ea3hmj/HMJTS/README.txt

!IMPORTANT, this repository is obsolete and has been replaced by the EA3HMJ Tracking Software Suit repository (https://github.com/EA3HMJ-Tracking-Software-Suite)
