ea3hmj/HMJTS/controller dish/remote/readme.md

# REMOTE CONTROL

The DishController remote control unit is a standalone battery powered wireless device that allows users to control the basic motion functions of the DishController without requiring a computer. 
It is a convenient device to operate the system outdoors (i.e., at the antenna location) while monitoring the antenna movement.
The remote wirelessly connects to the DishController mainboard and is powered by a rechargeable lithium-ion polymer (LiPo) battery.

## WARNING
Using the remote while a computer is operating connected to the DishController can potentially interfere with the normal functioning of the system. Therefore, it's advisable to avoid using the remote control when your computer is in use to command the DishController.

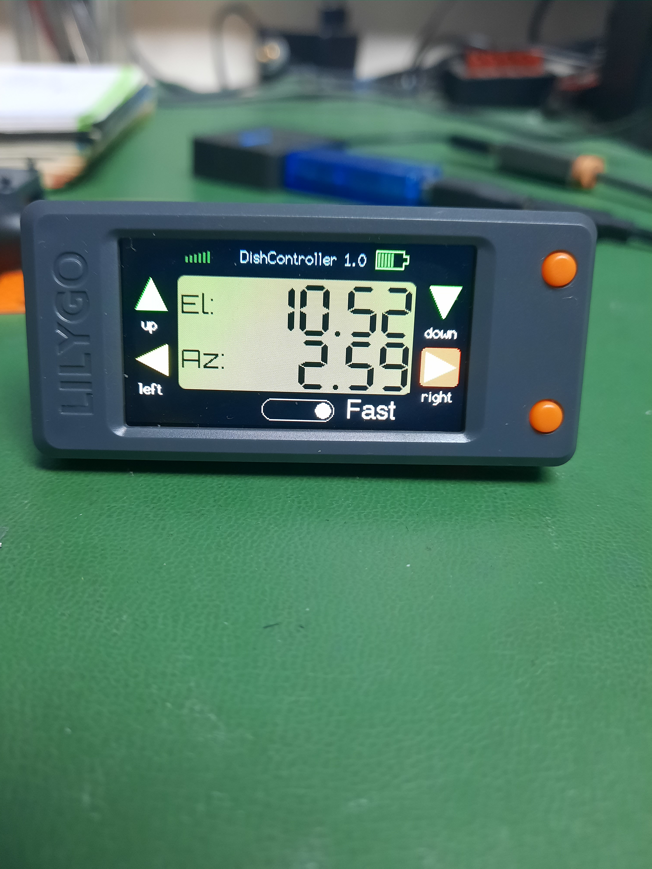
[picture p8: img/mando.jpg]


## INSTRUCTIONS

The remote has two main operating buttons on the upper and lower right of the front panel and a reset button on the side. 
To perform an action with the remote, press the appropriate button.

The lower right button performs the following functions:

• Single click to move between the four motion axes: ELEVATION (EL) up and down and AZIMUTH (AZ) right and left

• Double-click to switch from fast to slow speed motor movement

• Long click (0.5 s) to turn off the controller

The upper right button performs the following functions:

• Press and hold moves the selected movement axis

• Release stops movement

• When the motors are stopped, pressing it turns them on

## HARDWARE
The remote control is based on the LILYGO T-Display-S3 development board whose main control chip is ESP32-S3. It is equipped with a 1.9-inch LCD color screen and two programmable buttons.





## Documentation
### T-Display-S3 
https://es.aliexpress.com/item/1005004496543314.html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

### litle batery
https://www.amazon.es/EEMB-Bater%C3%ADa-pol%C3%ADmero-Recargable-Conector/dp/B09DPNZM31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

### big batery
https://www.amazon.es/dp/B09DPPMX14?psc=1&ref=ppx_yo2ov_dt_b_product_details

### files to print 3D box
https://github.com/Xinyuan-LilyGO/T-Display-S3/tree/main/3D_file/Shell

## Disclaimer
This software -including the source and the whole package- and hardware are distributed "as is" without any representation or warranty of any kind, either express or implied.

Please note that I am not able to provide support for this antenna tracking system. I designed and wrote it for myself and I am willing to share it here for those asking about my tracking system. I do not guarantee the accuracy or completeness of the information and materials distributed here. The software source has been tested on a real environment and scanned for viruses and has passed all tests.

I shall not be liable for any errors or omissions and shall not be responsible for any damages arising from the use of this antenna tracking system. I shall not be held responsible for any issues or problems that may arise from the use of it. By using any part of this antenna tracking system (software or hardware), you acknowledge and agree to the terms of this disclaimer.
