ea3hmj/HMJTS/controller dish/paralell to 485/readme.md

# CONVERTER PARALEL TO MODBUS-RTU RS-485
Interface for reading a 13-bit parallel encoder and converting it to RS-485 MOD-BU protocol.



## Documentation
For details, please read the document: [Encoder optico v2 ENG.pdf](docs/Encoder%20optico%20v2%20ENG.pdf)

## External library 
[ModbusSlave](https://github.com/yaacov/ArduinoModbusSlave)

## Updates

Download the firmware in [latest release page](https://github.com/ea3hmj/HMJTS/blob/main/controller%20dish/paralell%20to%20485/software/interface%20485.rar)

Use ST-LINK2 to program the board.

[Drivers for ST-LINK2 windows available here](https://github.com/ea3hmj/HMJTS/blob/main/controller%20dish/paralell%20to%20485/software/ST-LINK_USB_V2_1_Driver.rar)

## Disclaimer
This is an antenna tracking system (software and hardware) designed for amateur use in Earth–Moon–Earth communication (EME), radioastronomy, amateur Deep Sky Network (DSN) and other Space Communication applications where accurate and high precision tracking are required. 
Proper use of the system requires electronics knowledge and some software skills. Thus, it is only recommended to users with previous experience with antenna tracking systems.

This software -including the source and the whole package- and hardware are distributed "as is" without any representation or warranty of any kind, either express or implied. 

Please note that I am not able to provide support for this antenna tracking system. I designed and wrote it for myself and I am willing to share it here for those asking about my tracking system. I do not guarantee the accuracy or completeness of the information and materials distributed here. The software source has been tested on a real environment and scanned for viruses and has passed all tests.

I shall not be liable for any errors or omissions and shall not be responsible for any damages arising from the use of this antenna tracking system. I shall not be held responsible for any issues or problems that may arise from the use of it. 
By using any part of this antenna tracking system (software or hardware), you acknowledge and agree to the terms of this disclaimer.
