ea3hmj/HMJTS/Star up tracking system v1 ENG.pdf

### Version 1.0

08-08-2023

# STARTUP TRACKING SYSTEM

© EA3HMJ

Translated by CT1BYM

08/08/2023 | STARTUP TRACKING SYSTEM | 1

# INDICE

08/08/2023 | STARTUP TRACKING SYSTEM | 2

## STARTUP TRACKING SYSTEM

This is an antenna tracking system that integrates dedicated hardware and software designed for amateur use in Earth-Moon-Earth (EME) communications, radio astronomy, amateur Deep Sky Network (DSN) and other Space Communications applications where an accurate and high precision tracking is needed.

Proper use of the system requires knowledge of electronics and some software skills. Therefore, it is recommended for users with previous experience in antenna tracking systems only.

The hardware components of this system have been specifically selected to support the software applications that run on it. These components include a DishController unit that uses an ESP32 microcontroller (MCU), a DC motor driver board with high-performance, high-current control devices, RS485 input/output devices, and a DC step-up converter (versions <1.5). Other peripherals can be connected, such as a variety of digital absolute encoders and inclinometers to sense the motion and position of the motorized turning system, and a remote control unit.

The application software includes the DriverDish program, responsible for requesting data from the ephemeris server and for communicating with the DishController unit, and a suite of server programs (JPLastroserver, Astroserver, or Astronomyserver) that obtain the most accurate positioning data possible, are available from reliable sources.

The integration of dedicated hardware and software in such a system offers several advantages. First, it improves system performance and reliability by allowing the DishController unit to directly access and control specialized hardware components such as motor drivers and position sensors. This reduces overhead and improves response times. Second, it simplifies system design and development by providing a standardized set of hardware and software components optimized for narrow-beam antenna tracking. Third, unlike other antenna tracking system designs, motion and position sensors are located at the last link in the motion chain to actively monitor the aim of the antenna. In this way, the system is able to minimize the impact of mechanical tolerances and gear backlash.

The system is made up of three blocks that work together:

- Ephemeris servers (Astroserver, JPLastroserver or Astronomyserver)
- Control soware, SO Windows (DriverDish.App)
- Antenna Controller (Controller Dish)

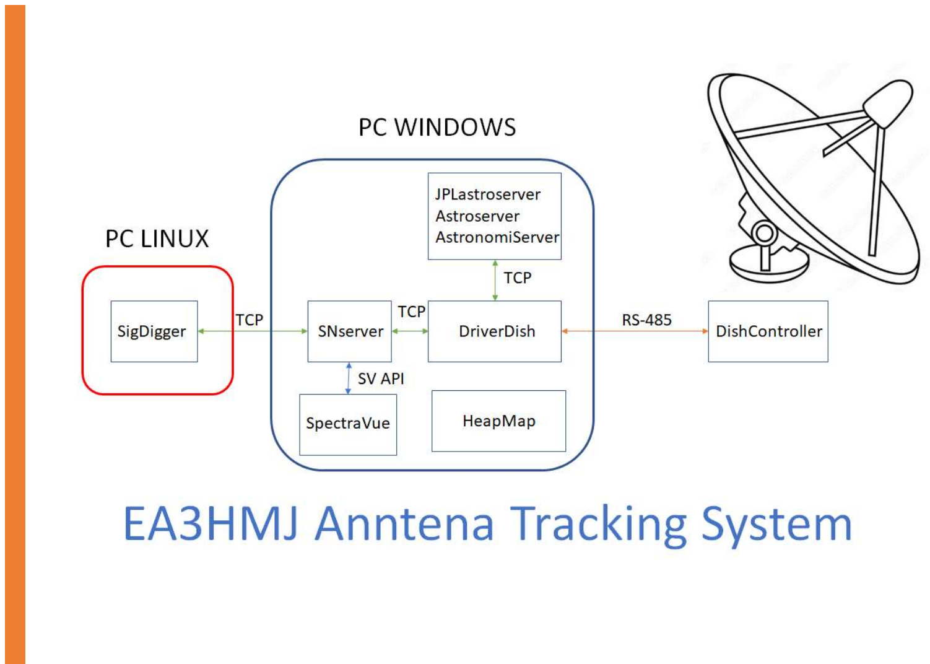
[picture p13: page 4]

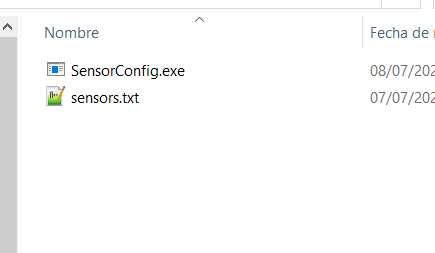
[picture p14: figure]
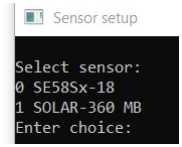
[picture p15: figure]
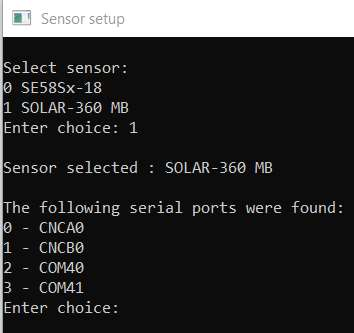
[picture p16: figure]

08/08/2023 | STARTUP TRACKING SYSTEM | 4

## Encoders

The first thing we must do is configure the encoders, both SOLAR-360 elevation and SE58xx azimuth.

To simplify the process I have created a utility that does the job automatically, we just have to connect the sensor to the computer through the USB-RS485 adapter and power it.

We will use two programs, one to configure and the other to verify.

To configure: https://ea3hmj.net/download/SensorConfig.rar

To verify: https://ea3hmj.net/download/ModRTUClient.rar

Unzip the file to a directory and run SensorConfig.exe

## Elevation SOLAR-360 MB

We connect the encoder and feed it.

Option 1 ask wich port it is connected

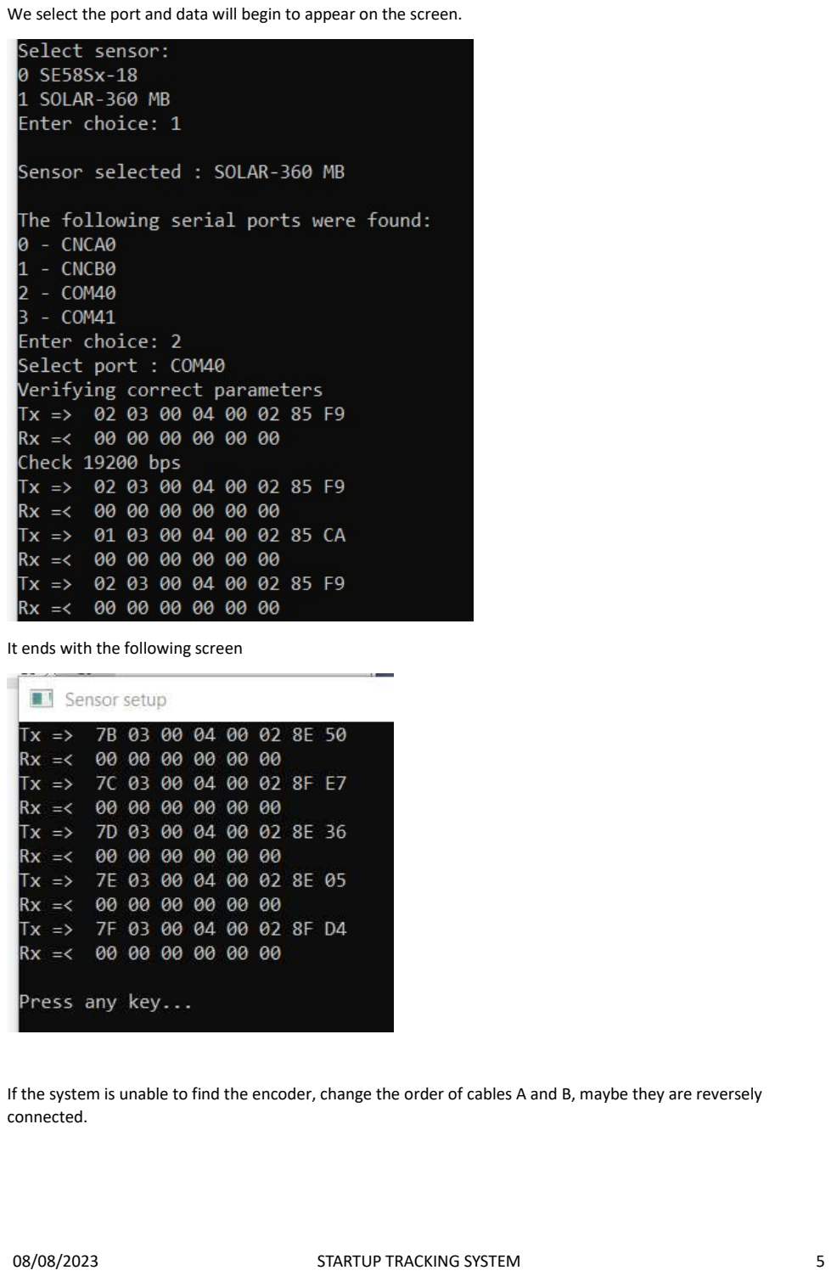
[picture p17: page 6]

08/08/2023 | STARTUP TRACKING SYSTEM | 5

We select the port and data will begin to appear on the screen.

It ends with the following screen

If the system is unable to find the encoder, change the order of cables A and B, maybe they are reversely connected.

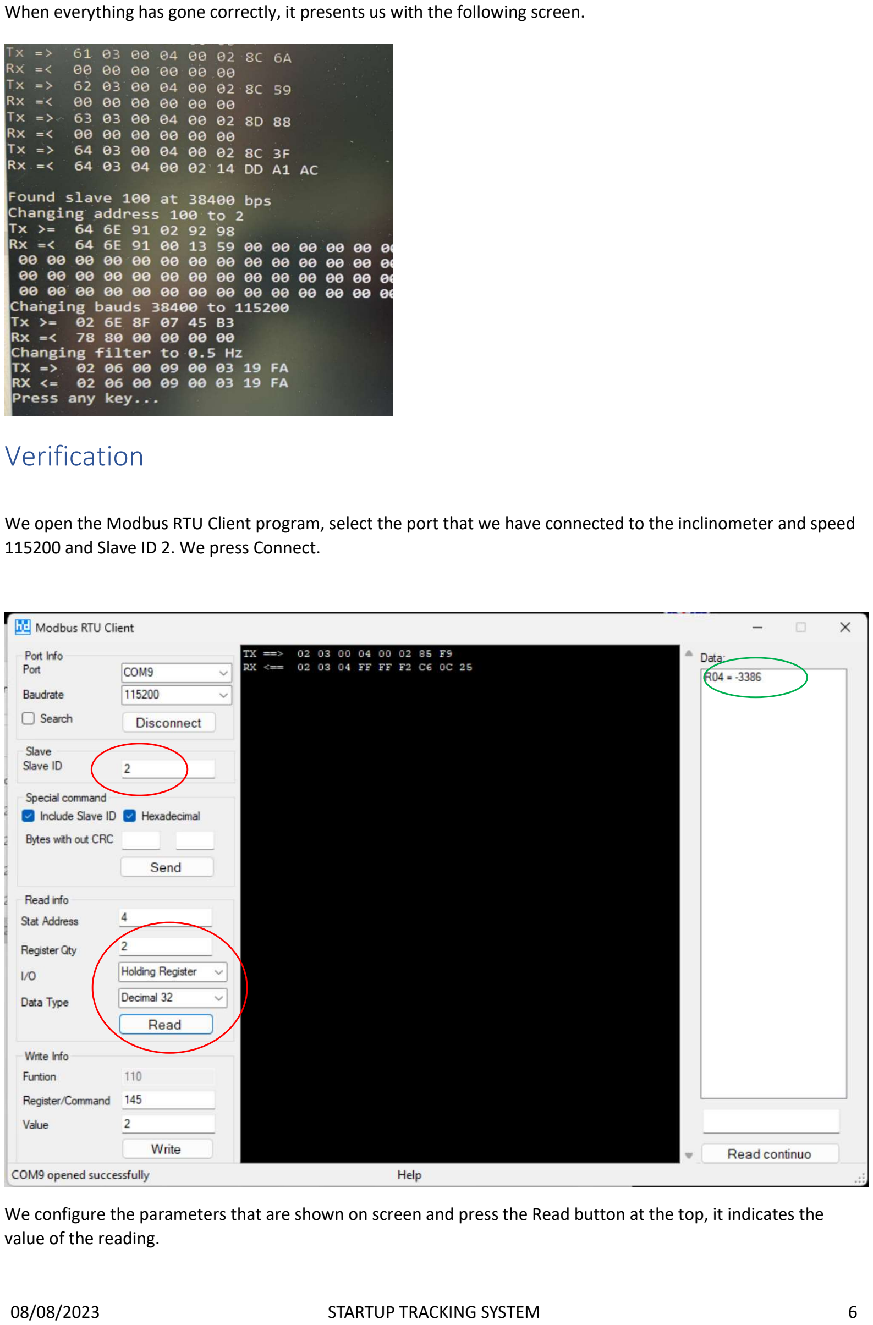
[picture p18: page 7]

08/08/2023 | STARTUP TRACKING SYSTEM | 6

When everything has gone correctly, it presents us with the following screen.

## Verification

We open the Modbus RTU Client program, select the port that we have connected to the inclinometer and speed 115200 and Slave ID 2. We press Connect.

We configure the parameters that are shown on screen and press the Read button at the top, it indicates the value of the reading.

## Azimuth SE58Sx

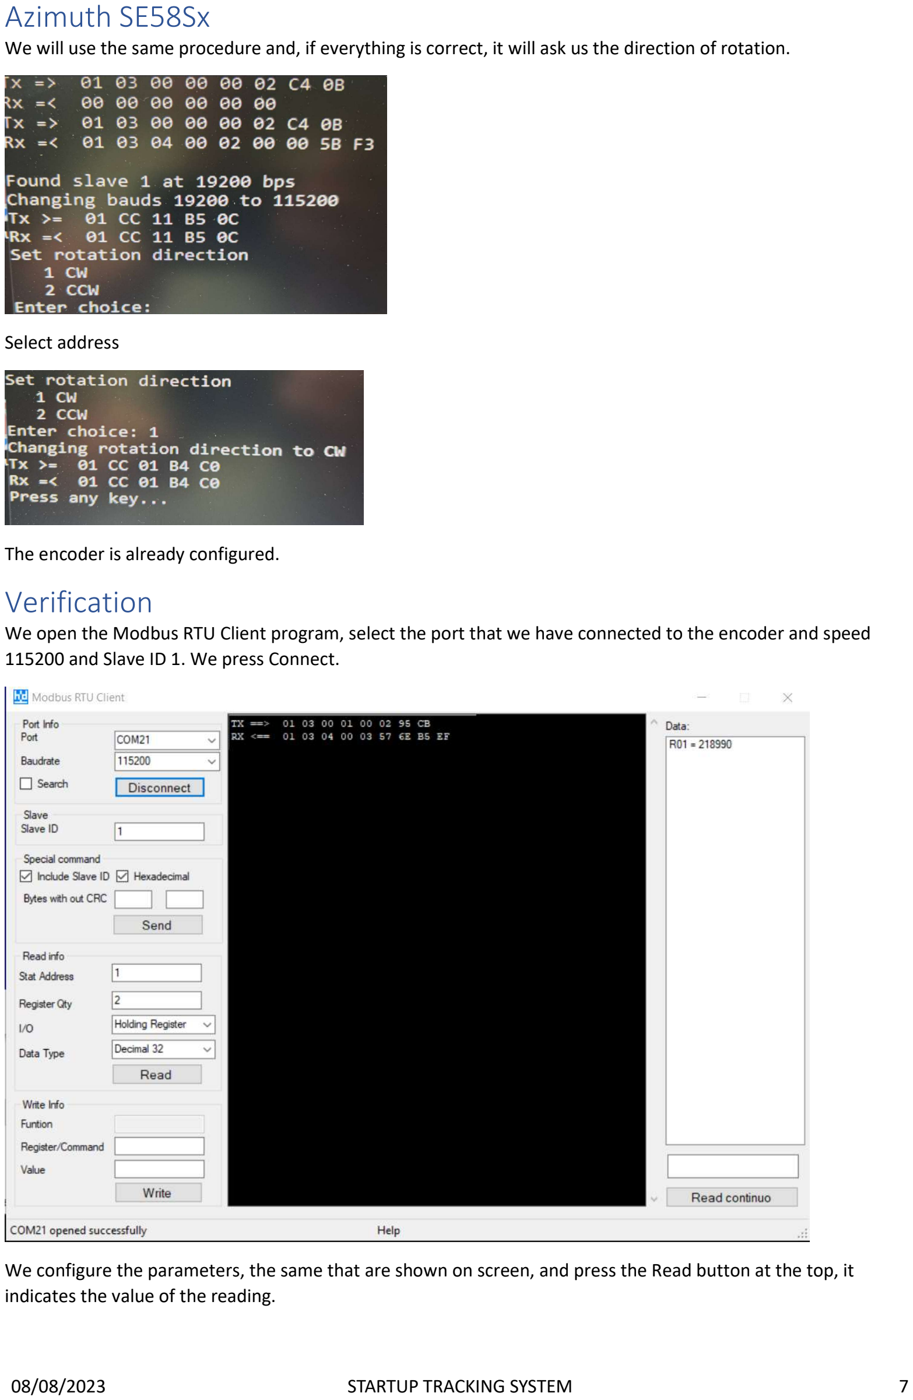
[picture p19: page 8]

08/08/2023 | STARTUP TRACKING SYSTEM | 7

We will use the same procedure and, if everything is correct, it will ask us the direction of rotation.

Select address

The encoder is already configured.

## Verification

We open the Modbus RTU Client program, select the port that we have connected to the encoder and speed 115200 and Slave ID 1. We press Connect.

We configure the parameters, the same that are shown on screen, and press the Read button at the top, it indicates the value of the reading.

## DriverDish

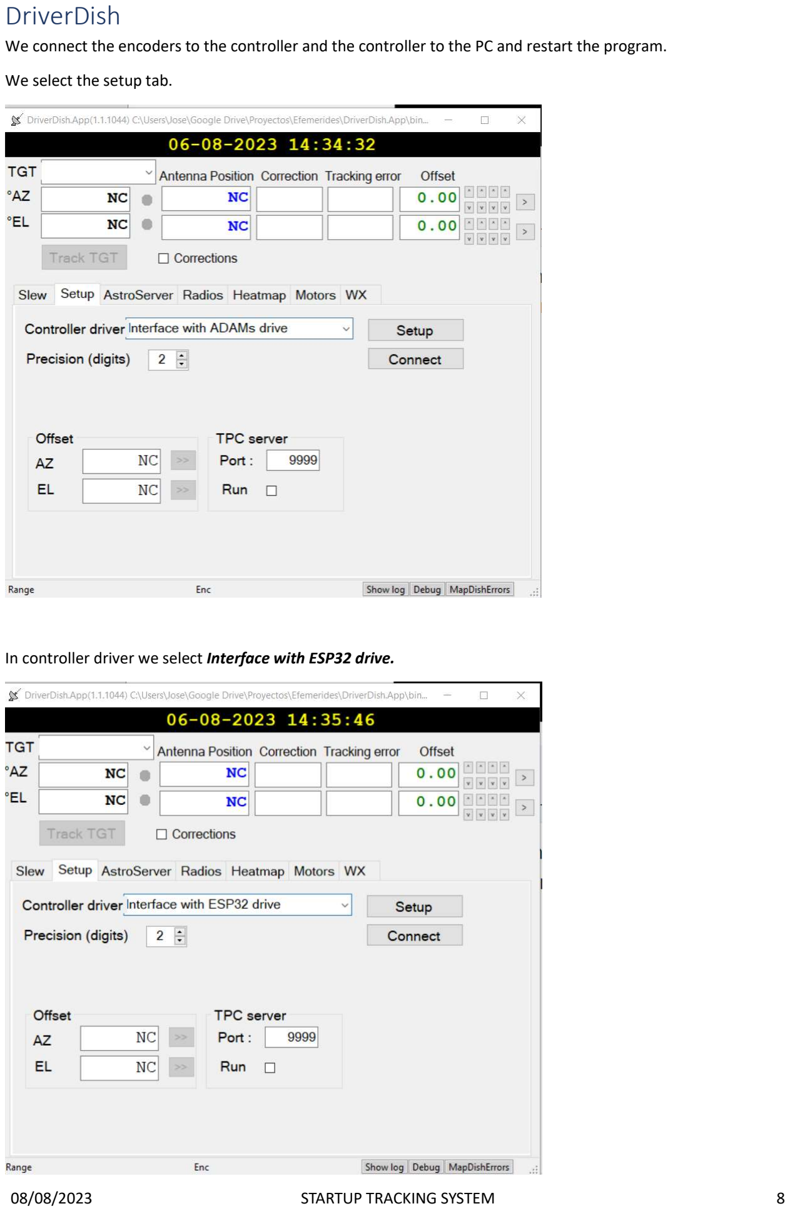
[picture p20: page 9]

08/08/2023 | STARTUP TRACKING SYSTEM | 8

We connect the encoders to the controller and the controller to the PC and restart the program. We select the setup tab.

In controller driver we select Interface with ESP32 drive.

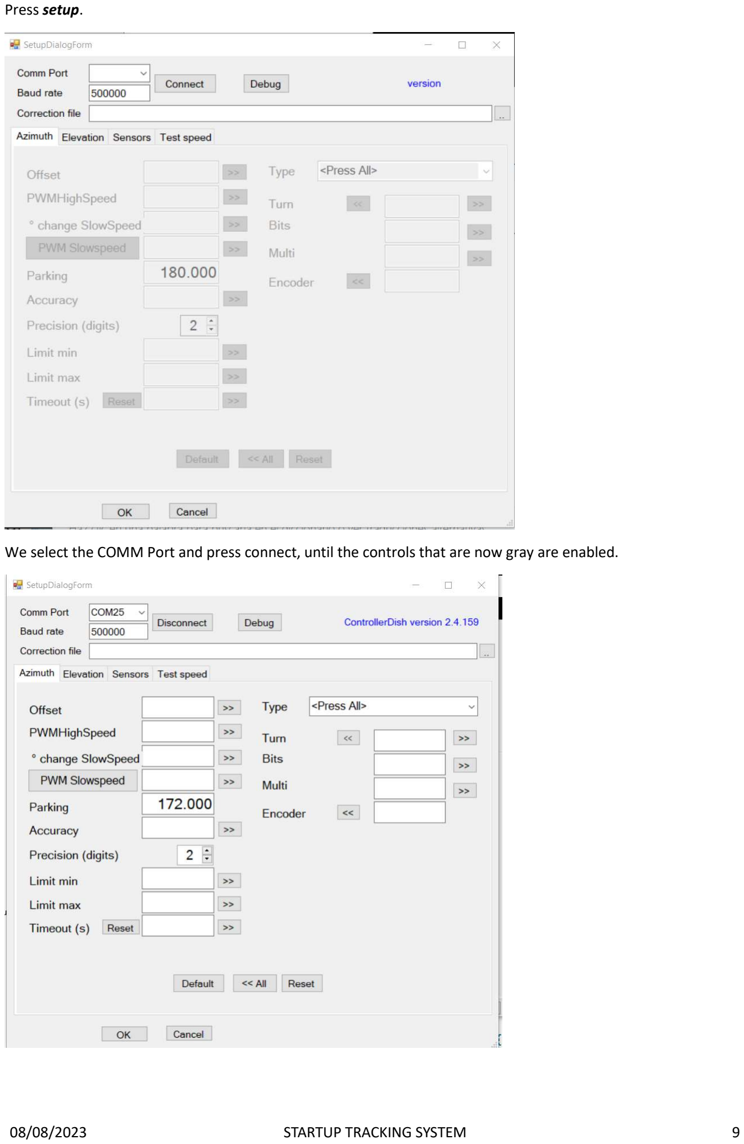
[picture p21: page 10]

08/08/2023 | STARTUP TRACKING SYSTEM | 9

Press setup.

We select the COMM Port and press connect, until the controls that are now gray are enabled.

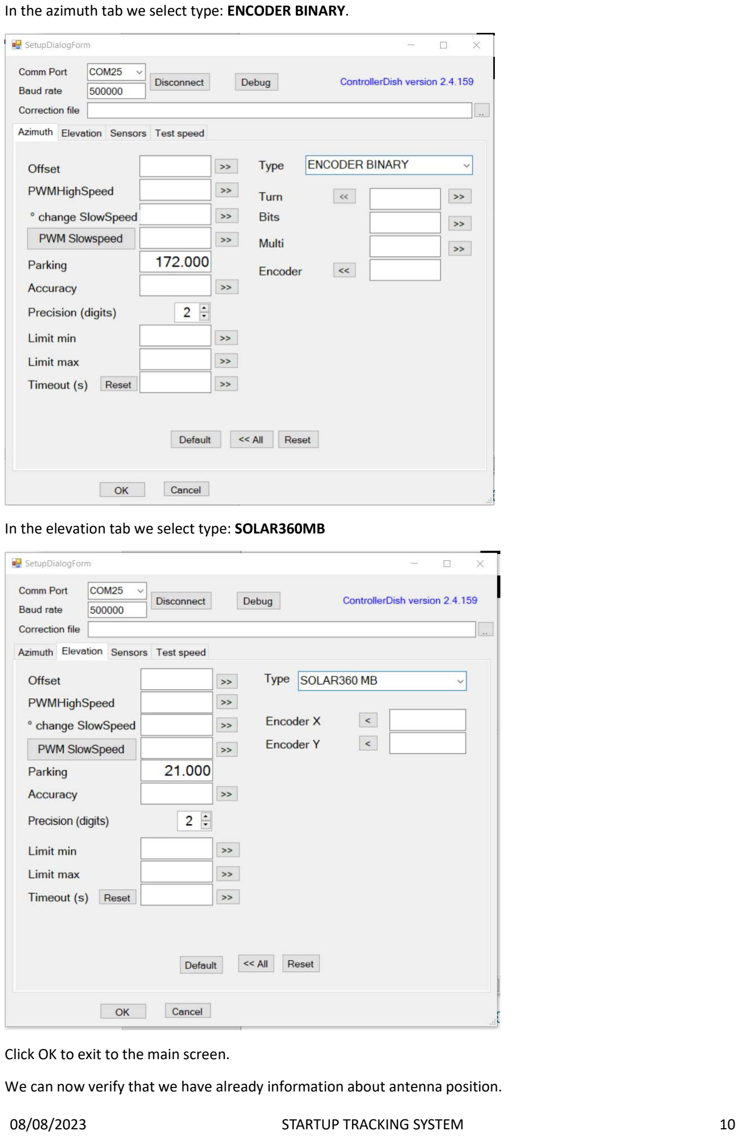
[picture p22: page 11]

08/08/2023 | STARTUP TRACKING SYSTEM | 10

In the azimuth tab we select type: ENCODER BINARY.

In the elevation tab we select type: SOLAR360MB

Click OK to exit to the main screen.
We can now verify that we have already information about antenna position.

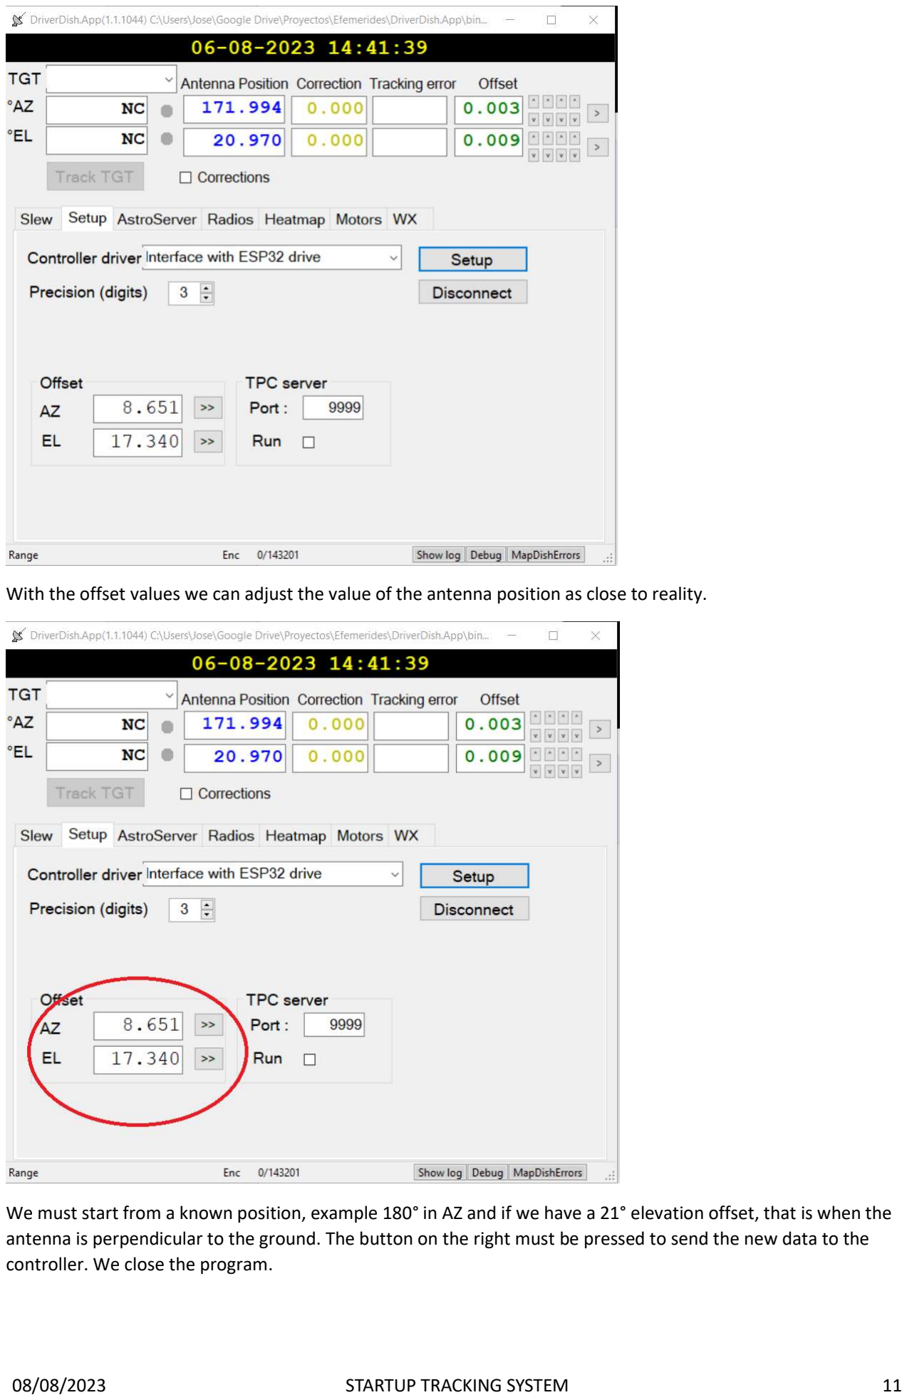
[picture p23: page 12]

08/08/2023 | STARTUP TRACKING SYSTEM | 11

With the offset values we can adjust the value of the antenna position as close to reality.

We must start from a known position, example 180° in AZ and if we have a 21° elevation offset, that is when the antenna is perpendicular to the ground. The button on the right must be pressed to send the new data to the controller. We close the program.

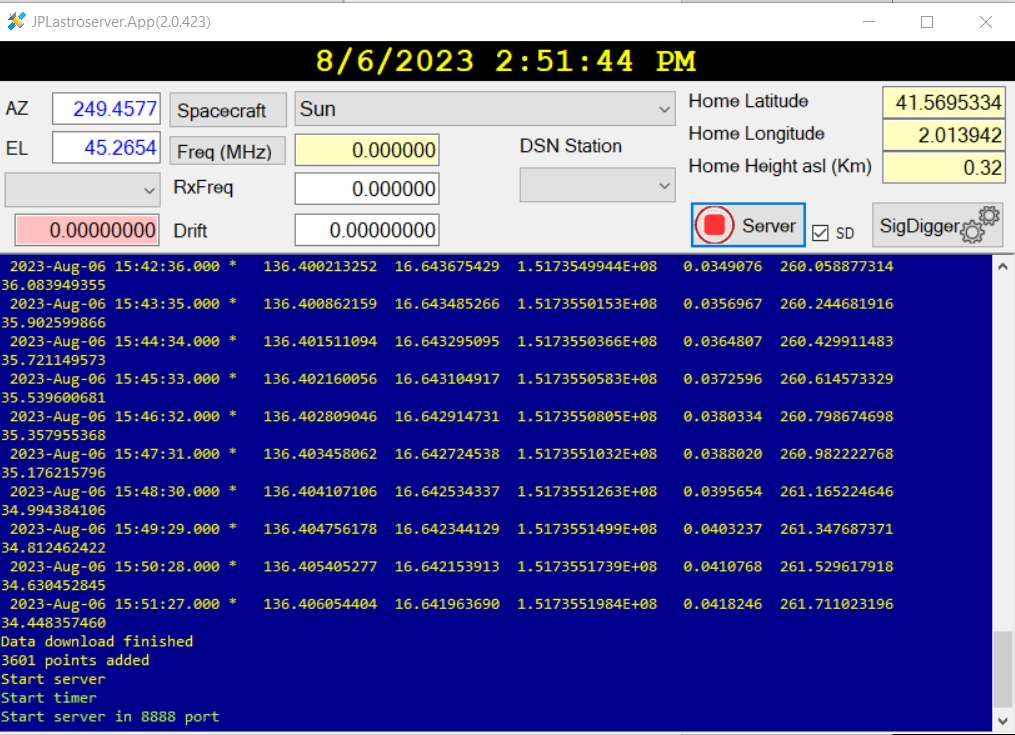
[picture p24: figure]

08/08/2023 | STARTUP TRACKING SYSTEM | 12

## JPLastroserver

We start the program

We must put the appropriate values of latitude, longitude and height of our location.

We close the program.

## Verification of communications

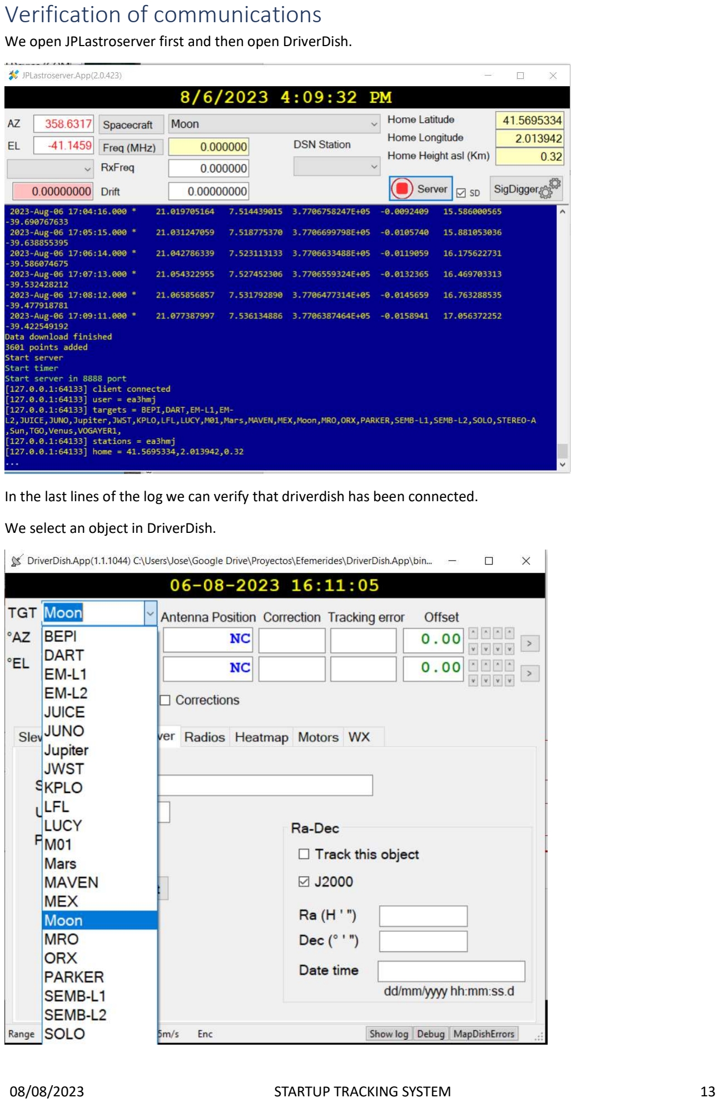
[picture p25: page 14]

08/08/2023 | STARTUP TRACKING SYSTEM | 13

We open JPLastroserver first and then open DriverDish.

In the last lines of the log we can verify that driverdish has been connected. We select an object in DriverDish.

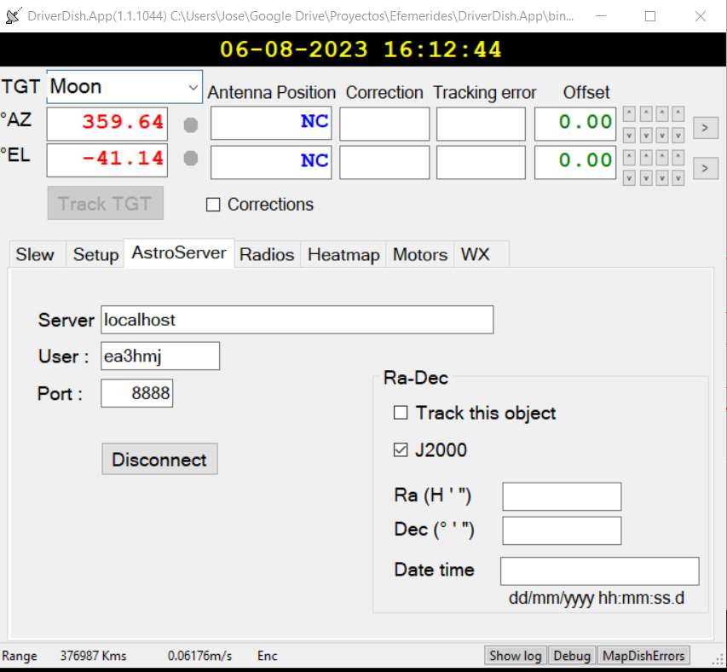
[picture p26: figure]

08/08/2023 | STARTUP TRACKING SYSTEM | 14

The program already obtained ephemeris from the server and we can track the object selected.

## SNserver

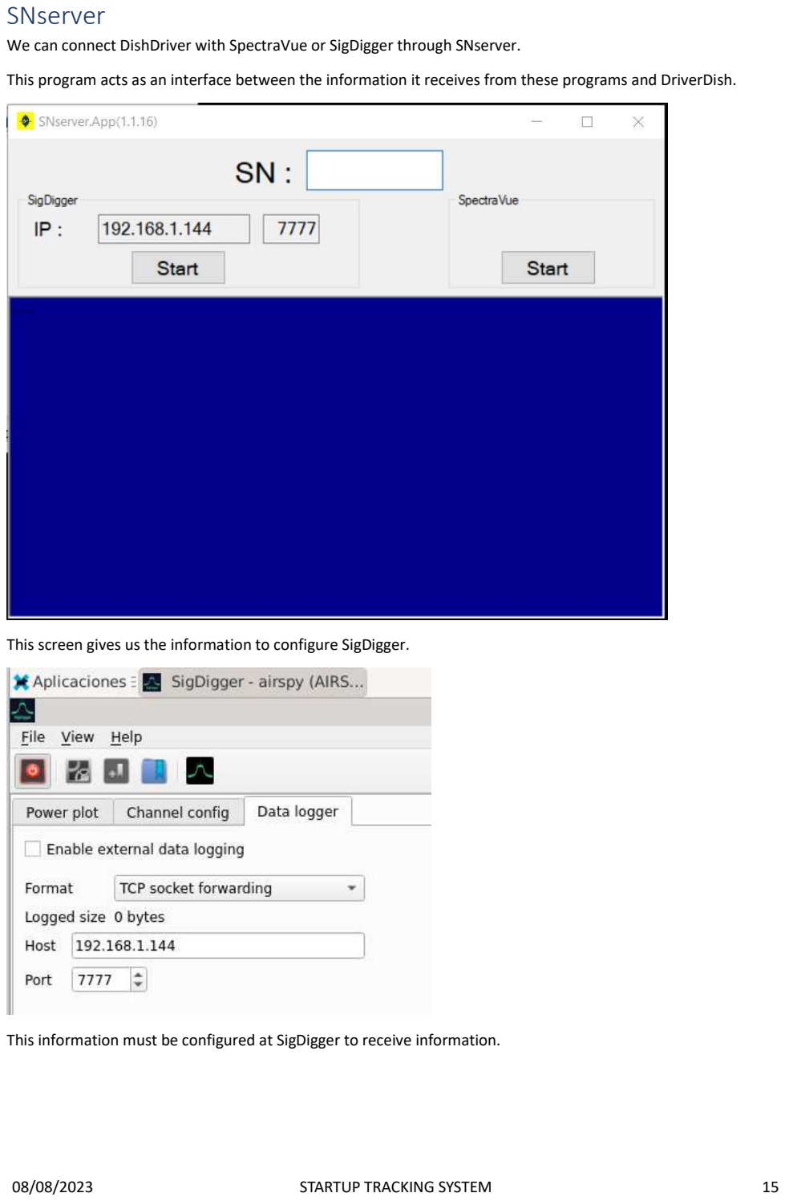
[picture p27: page 16]

08/08/2023 | STARTUP TRACKING SYSTEM | 15

We can connect DishDriver with SpectraVue or SigDigger through SNserver.
This program acts as an interface between the information it receives from these programs and DriverDish.

This screen gives us the information to configure SigDigger.

This information must be configured at SigDigger to receive information.

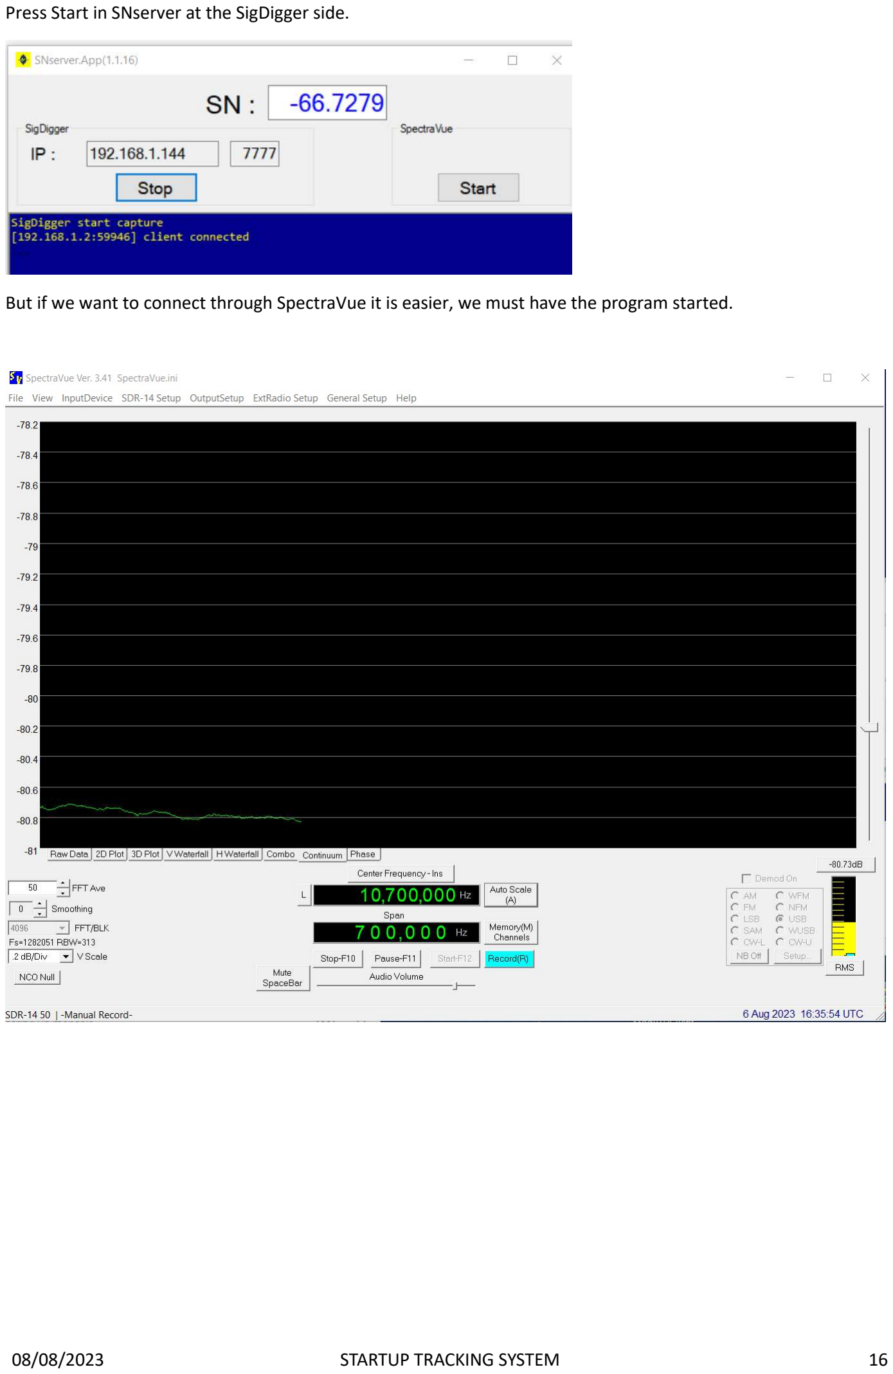
[picture p28: page 17]

08/08/2023 | STARTUP TRACKING SYSTEM | 16

Press Start in SNserver at the SigDigger side.

But if we want to connect through SpectraVue it is easier, we must have the program started.

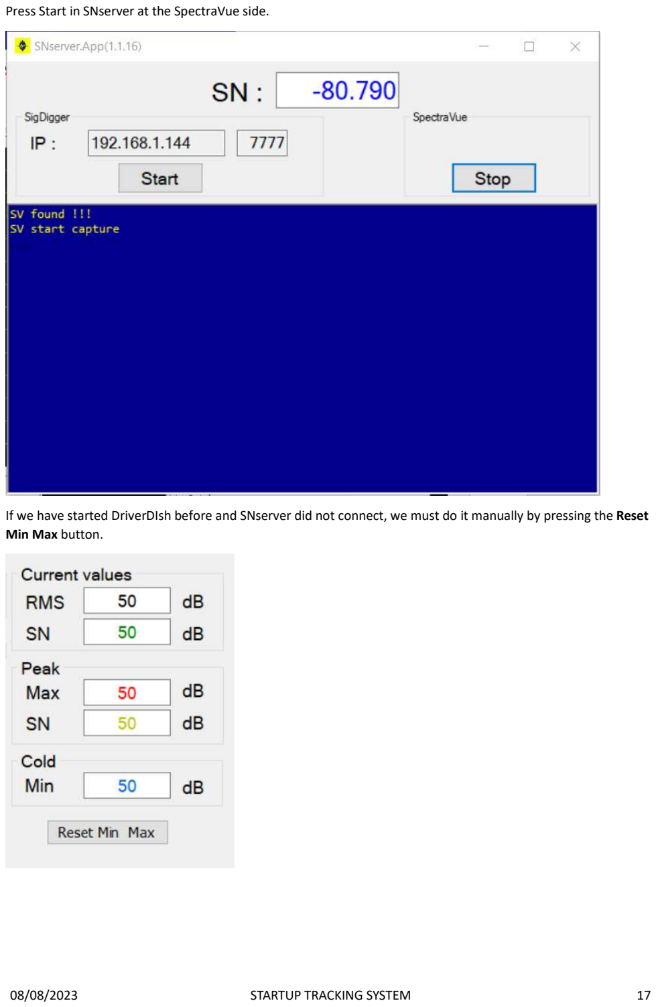
[picture p29: page 18]

08/08/2023 | STARTUP TRACKING SYSTEM | 17

Press Start in SNserver at the SpectraVue side.

If we have started DriverDIsh before and SNserver did not connect, we must do it manually by pressing the Reset Min Max button.

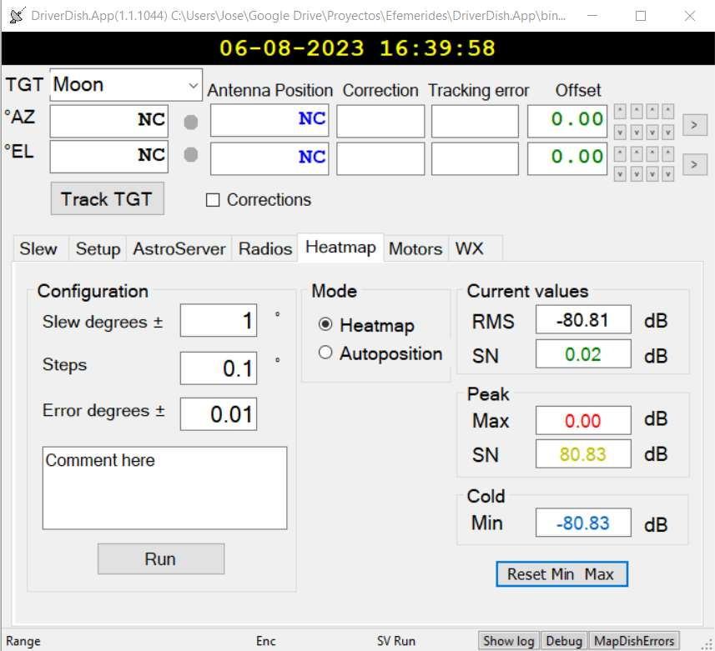
[picture p30: figure]

08/08/2023 | STARTUP TRACKING SYSTEM | 18

We already have the information.
If we first start SNserver when starting DriverDish it automatically connects.
