ea3hmj/HMJTS/Star up tracking system v1 ESP.pdf

### Versión 1.0

6-08-2023

# START UP TRACKING SYSTEM

© EA3HMJ

06/08/2023 | START UP TRACKING SYSTEM | 1

# INDICE

06/08/2023 | START UP TRACKING SYSTEM | 2

## START UP TRACKING SYSTEM

Se trata de un sistema de seguimiento de antenas que integra hardware y software dedicado diseñado para uso amateur en comunicaciones Tierra-Luna-Tierra (EME), radioastronomía, Red de Cielo Profundo (DSN) amateur y otras aplicaciones de Comunicaciones Espaciales donde se requiere un seguimiento exacto y de alta precisión.

El uso adecuado del sistema requiere conocimientos de electrónica y algunas habilidades de software. Por ello, sólo se recomienda a usuarios con experiencia previa en sistemas de seguimiento de antenas.

Los componentes hardware de este sistema han sido específicamente seleccionados para soportar las aplicaciones software que se ejecutan en él. Estos componentes incluyen una unidad DishController que incluye un microcontrolador ESP32 (MCU), una placa de controladores de motor de CC con dispositivos de control de alto rendimiento y alta corriente, dispositivos de entrada/salida RS485 y un convertidor elevador de tensión de CC (versiones <1.5) , otros periféricos como una variedad de codificadores digitales absolutos e inclinómetros para detectar el movimiento y la posición del sistema de accionamiento de giro motorizado y una unidad de control remoto.

El software de aplicación incluye el programa DriverDish, responsable de solicitar datos al servidor de efemérides y de comunicarse con la unidad DishController, y un conjunto de programas de servidor (JPLastroserver, Astroserver y Astronomyserver) que obtienen los datos de posicionamiento más precisos que sean factibles y estén disponibles en fuentes fiables.

La integración de hardware y software dedicados en un sistema de este tipo ofrece varias ventajas. En primer lugar, mejora el rendimiento y la fiabilidad del sistema al permitir que la unidad DishController acceda directamente a los componentes de hardware especializados, como los controladores de motor y los sensores de posición, y los controle. Esto reduce la sobrecarga y mejora los tiempos de respuesta. En segundo lugar, simplifica el diseño y desarrollo del sistema al proporcionar un conjunto estandarizado de componentes de hardware y software optimizados para el seguimiento de antenas de haz estrecho. En tercer lugar, a diferencia de otros diseños de sistemas de seguimiento de antenas, los sensores de movimiento y posición están situados en el último eslabón de la cadena de movimiento para supervisar activamente la dirección de apuntamiento de la antena. De este modo, el sistema es capaz de minimizar el impacto de las tolerancias mecánicas y las holguras de los engranajes.

El sistema se compone de tres bloques que funcionan conjuntamente:

- Servidores de efemérides (Astroserver, JPLastroserver y Astronomyserver)
- Aplicación de control en SO Windows (DriverDish.App)
- Controlador de antena (Controller Dish)

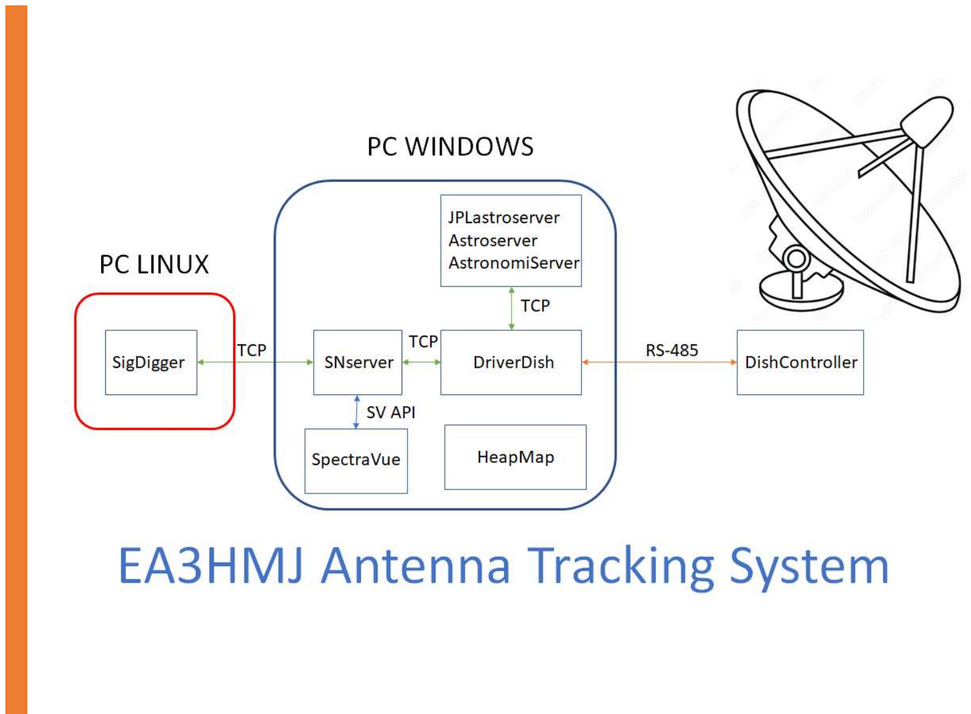
[picture p31: page 4]

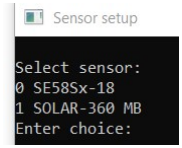
[picture p32: figure]

06/08/2023 | START UP TRACKING SYSTEM | 4

## Encoders

Lo primero que debemos de hacer es configurar los encoders, tanto elevación SOLAR-360 como azimuth SE58xx. Para simplificar el proceso he creado una utilidad que realiza el trabajo automáticamente, solo debemos de conectar el sensor al ordenador a través del adaptador USB-RS485 y alimentarlo.
Usaremos dos programas uno para configurar y otro para verificar.
Para configurar bajar https://ea3hmj.net/download/SensorConfig.rar y para verificar https://ea3hmj.net/download/ModRTUClient.rar

Descomprime el fichero en un directorio y ejecuta SensorConfig.exe

## Elevación SOLAR-360 MB

Conectamos el encoder y lo alimentamos.

Opción 1 y nos pregunta el puerto donde está conectado

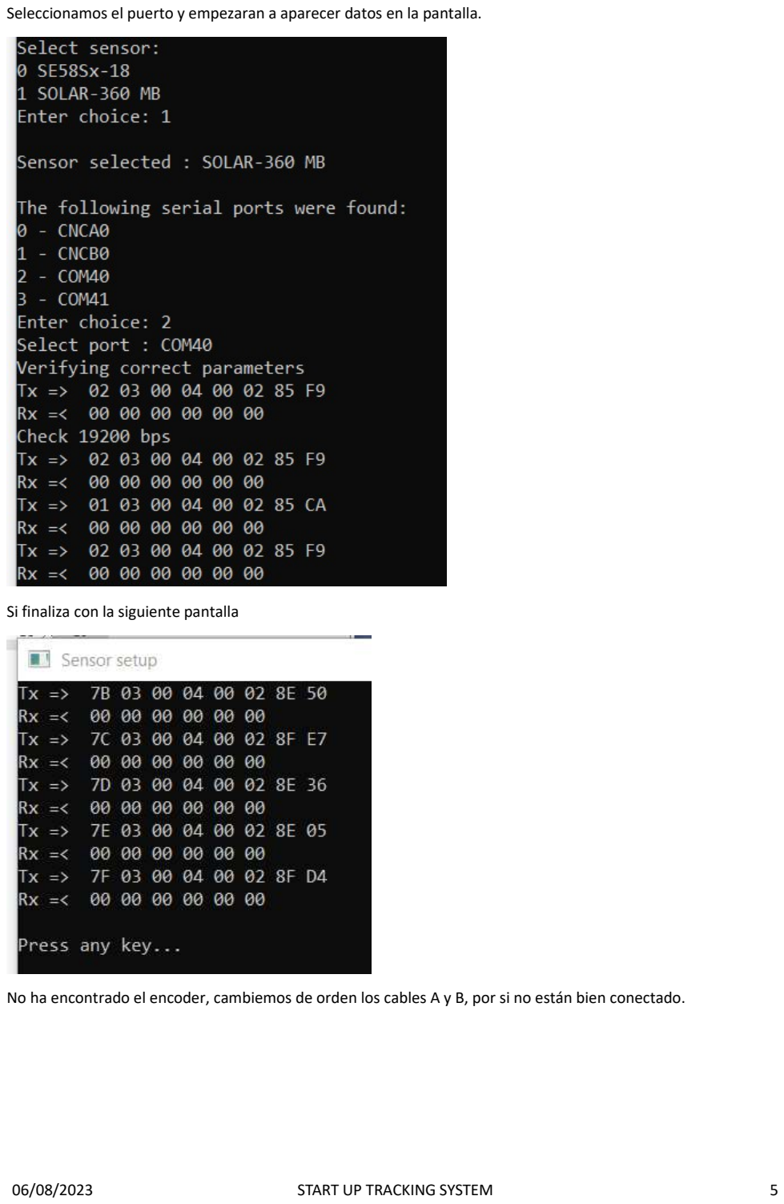
[picture p33: page 6]

06/08/2023 | START UP TRACKING SYSTEM | 5

Seleccionamos el puerto y empezaran a aparecer datos en la pantalla.

Si finaliza con la siguiente pantalla

No ha encontrado el encoder, cambiemos de orden los cables A y B, por si no están bien conectado.

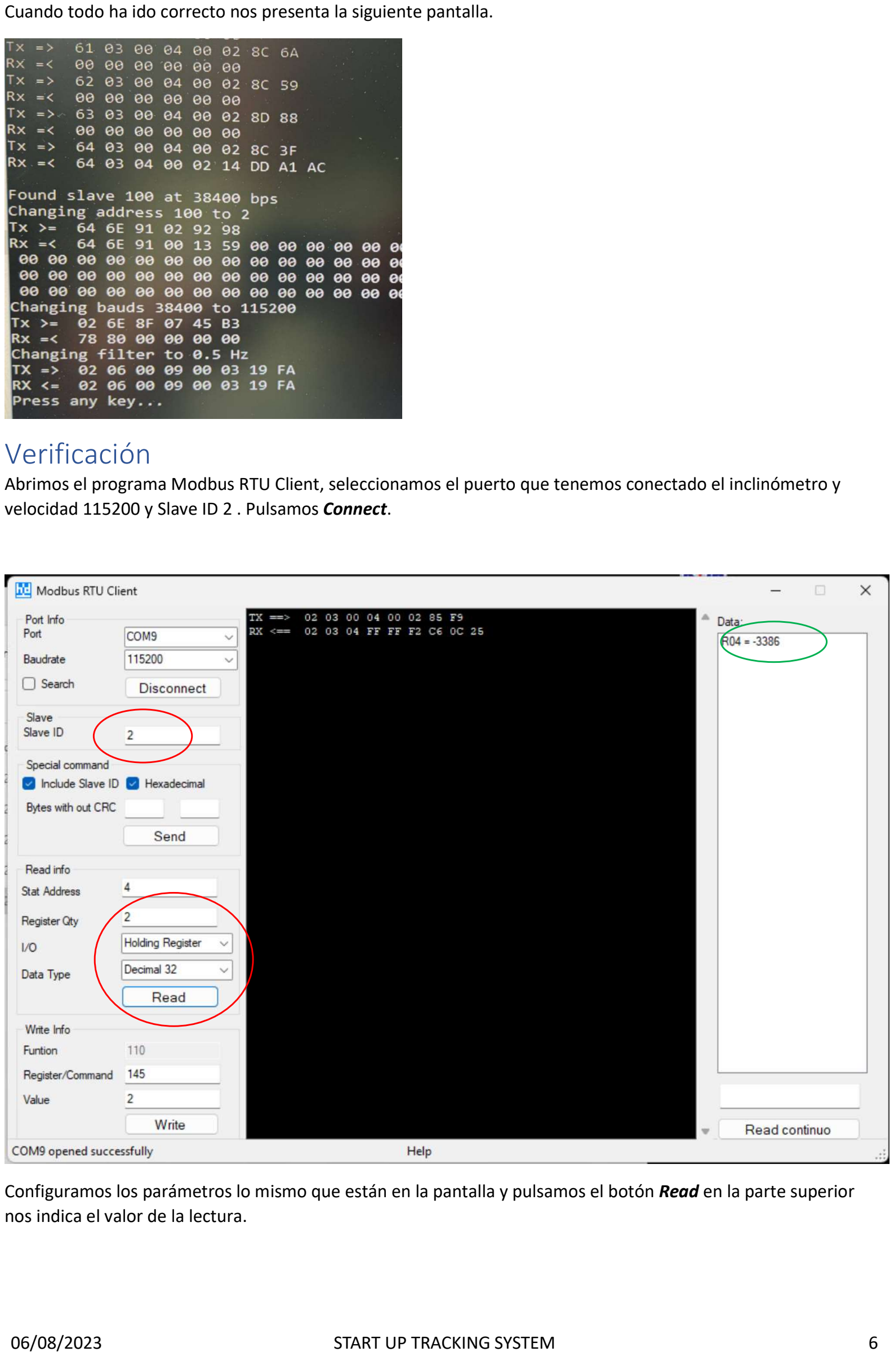
[picture p34: page 7]

06/08/2023 | START UP TRACKING SYSTEM | 6

Cuando todo ha ido correcto nos presenta la siguiente pantalla.

## Verificación

Abrimos el programa Modbus RTU Client, seleccionamos el puerto que tenemos conectado el inclinómetro y velocidad 115200 y Slave ID 2 . Pulsamos Connect.

Configuramos los parámetros lo mismo que están en la pantalla y pulsamos el botón Read en la parte superior nos indica el valor de la lectura.

## Azimuth SE58Sx

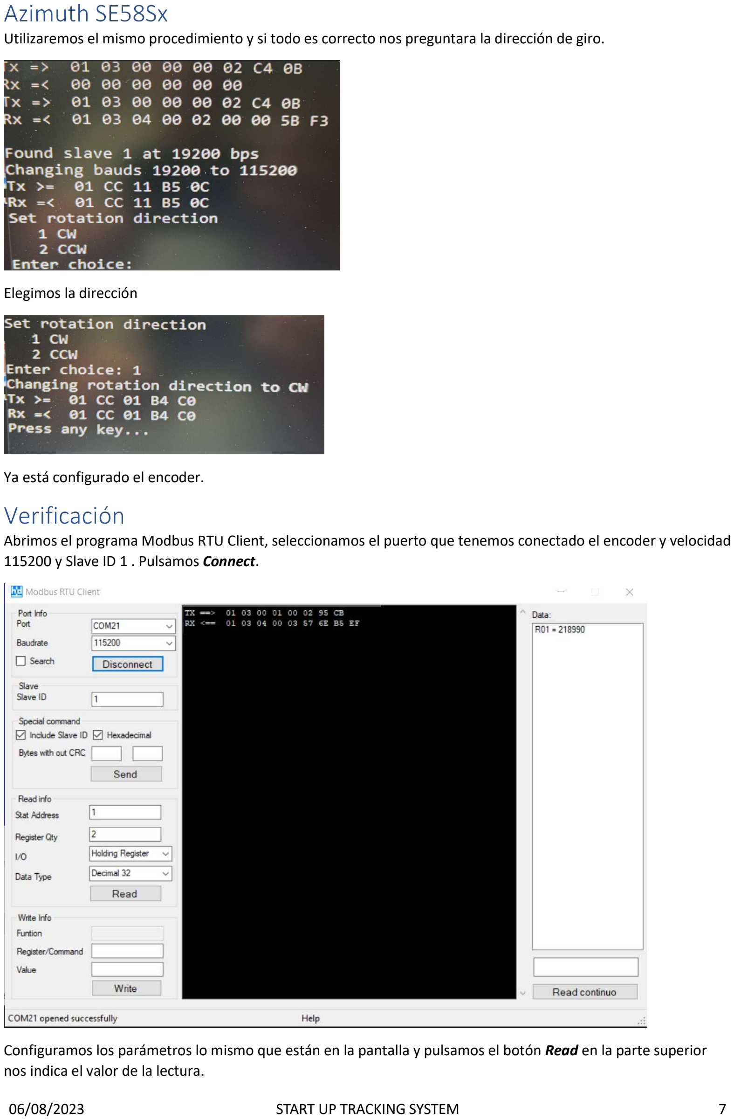
[picture p35: page 8]

06/08/2023 | START UP TRACKING SYSTEM | 7

Utilizaremos el mismo procedimiento y si todo es correcto nos preguntara la dirección de giro.

Elegimos la dirección

Ya está configurado el encoder.

## Verificación

Abrimos el programa Modbus RTU Client, seleccionamos el puerto que tenemos conectado el encoder y velocidad 115200 y Slave ID 1 . Pulsamos Connect.

Configuramos los parámetros lo mismo que están en la pantalla y pulsamos el botón Read en la parte superior nos indica el valor de la lectura.

## DriverDish

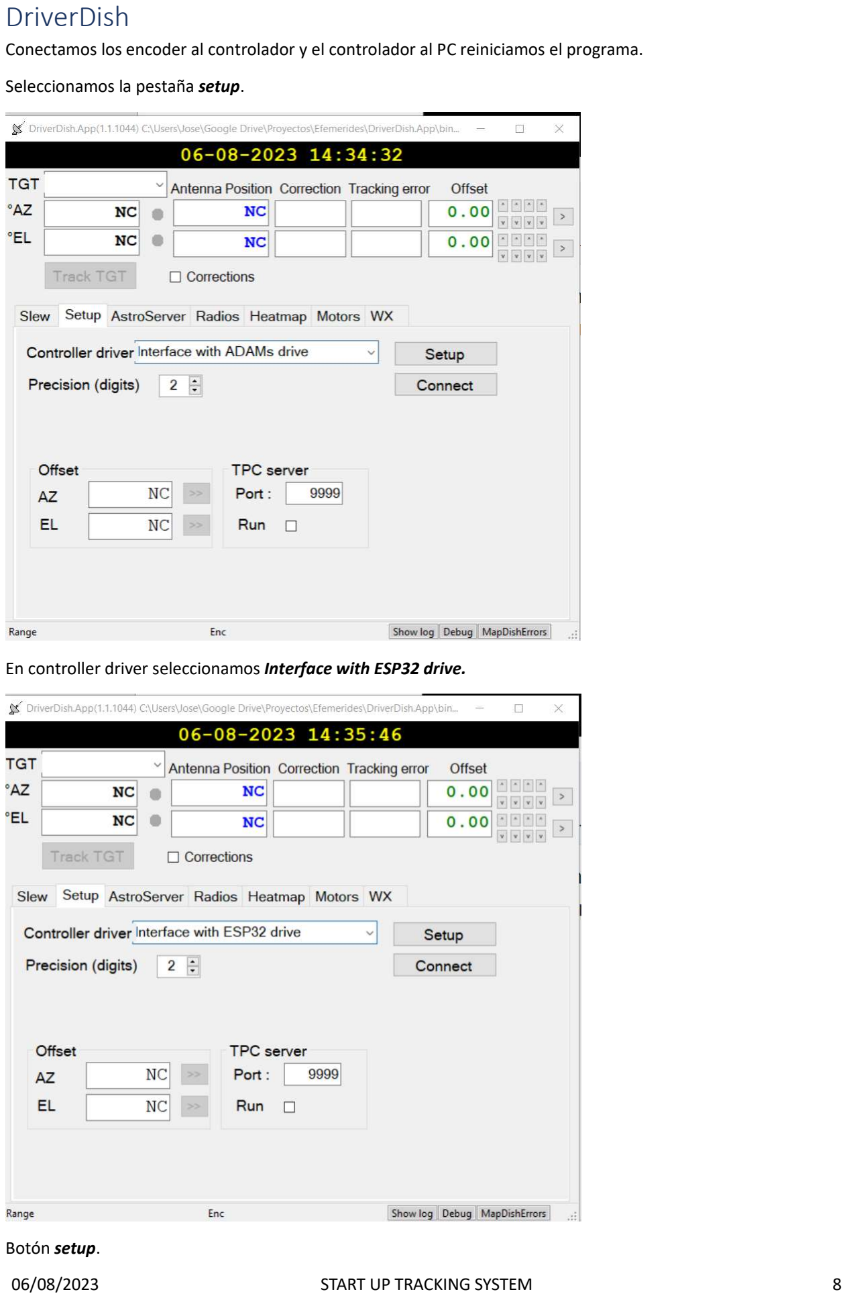
[picture p36: page 9]

06/08/2023 | START UP TRACKING SYSTEM | 8

Conectamos los encoder al controlador y el controlador al PC reiniciamos el programa. Seleccionamos la pestaña setup.

En controller driver seleccionamos Interface with ESP32 drive.

Botón setup.

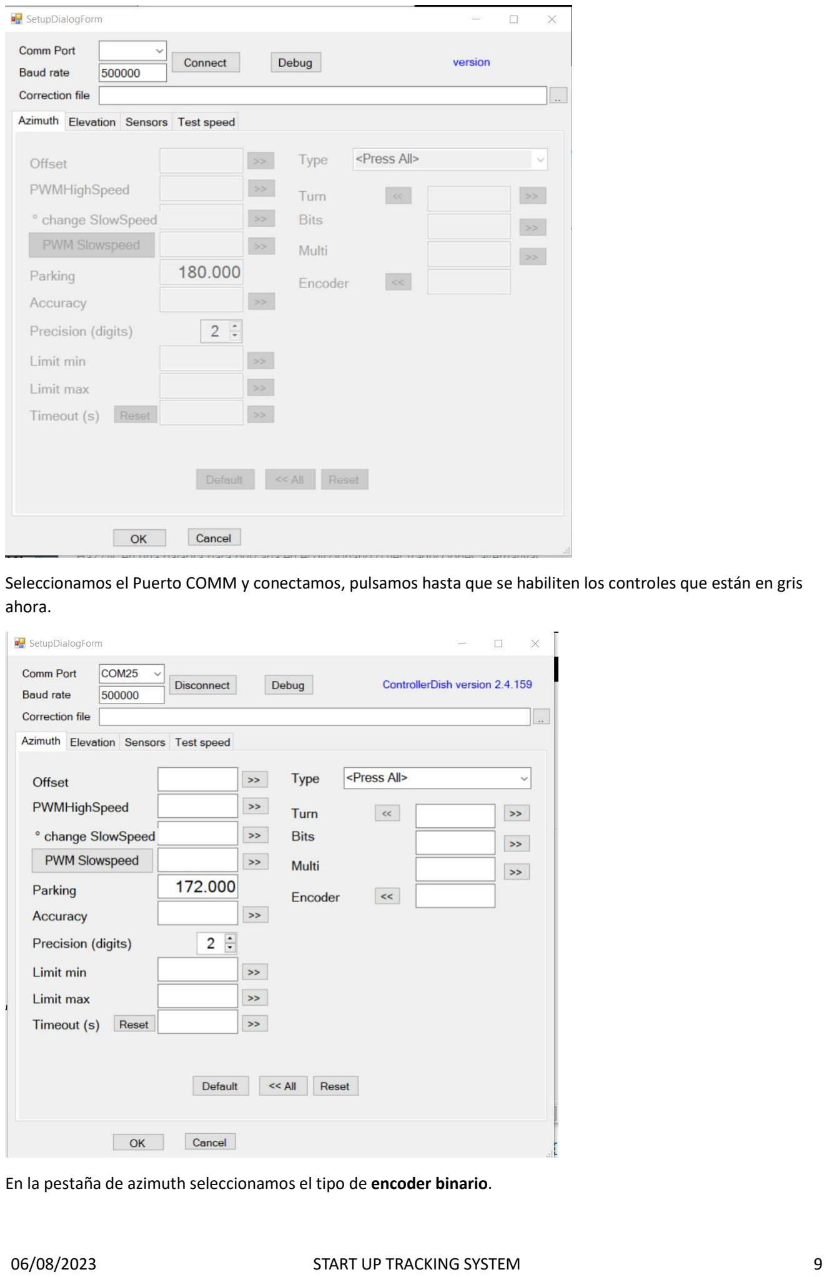
[picture p37: page 10]

06/08/2023 | START UP TRACKING SYSTEM | 9

Seleccionamos el Puerto COMM y conectamos, pulsamos hasta que se habiliten los controles que están en gris ahora.

En la pestaña de azimuth seleccionamos el tipo de encoder binario.

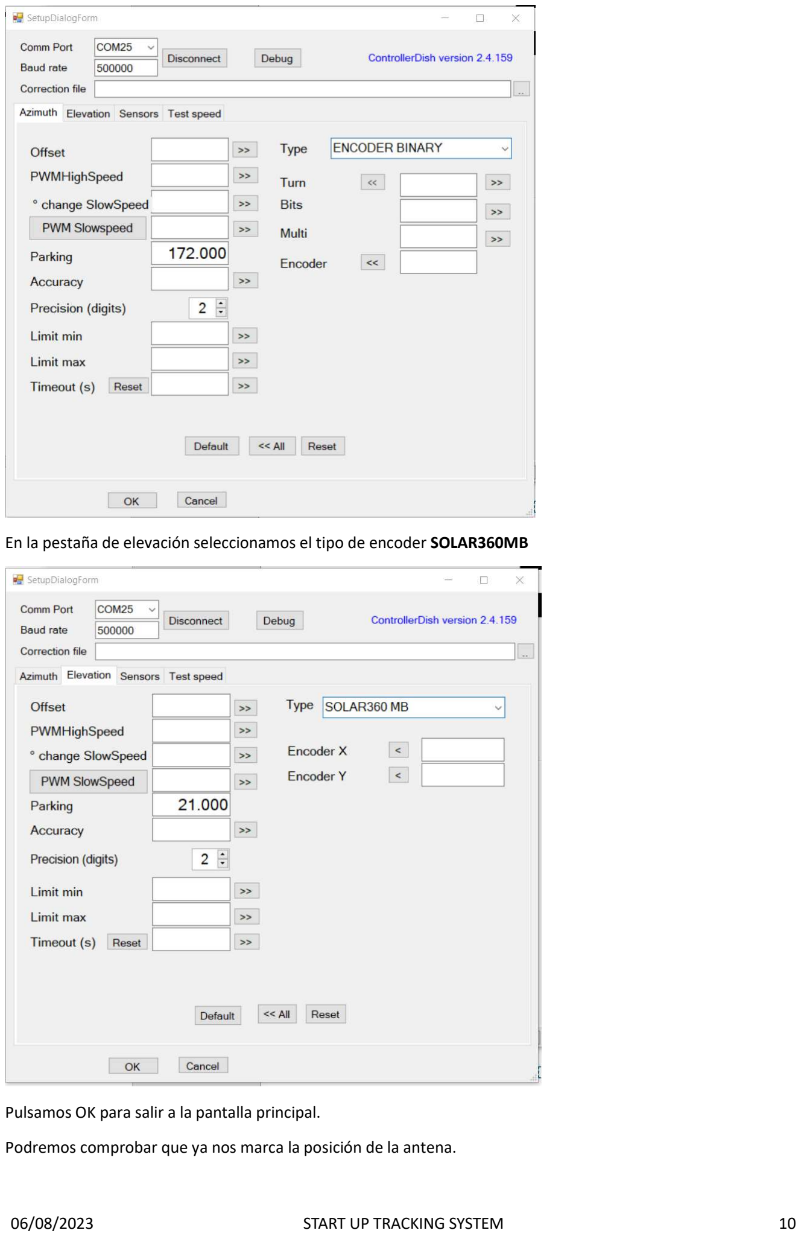
[picture p38: page 11]

06/08/2023 | START UP TRACKING SYSTEM | 10

En la pestaña de elevación seleccionamos el tipo de encoder SOLAR360MB

Pulsamos OK para salir a la pantalla principal.
Podremos comprobar que ya nos marca la posición de la antena.

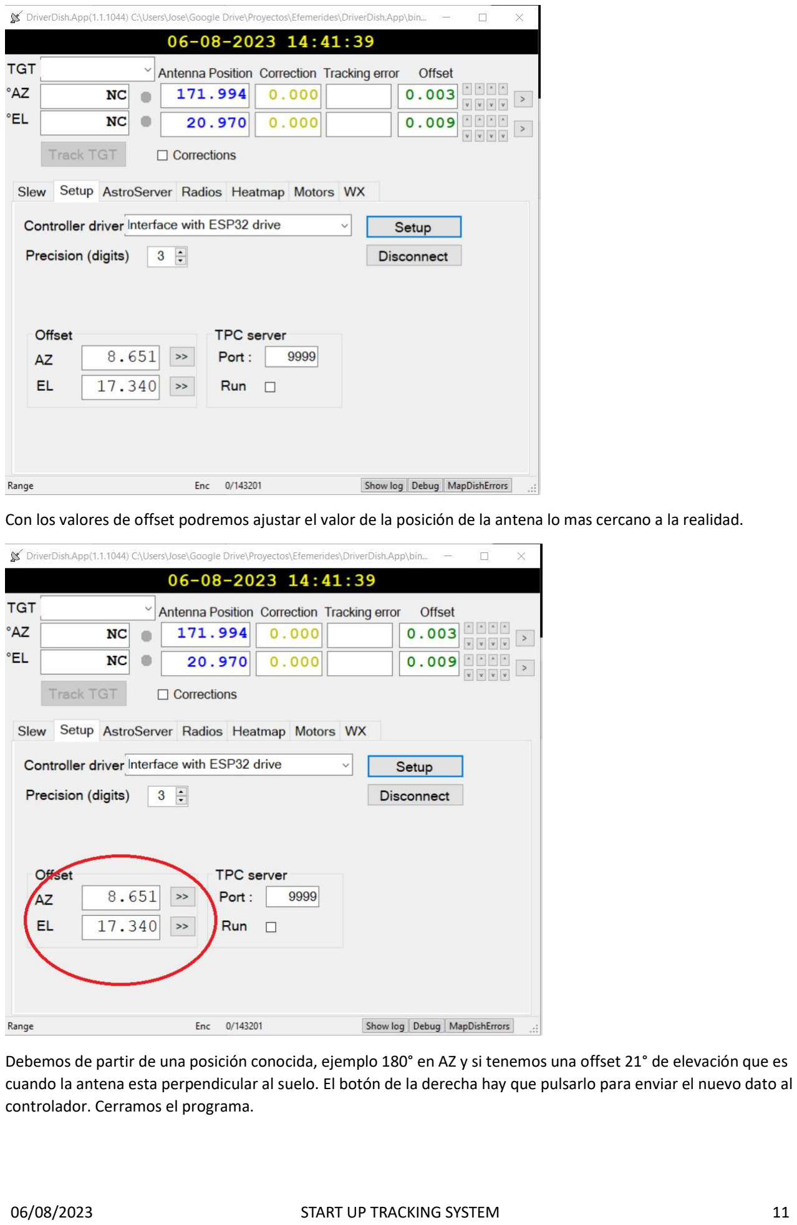
[picture p39: page 12]

06/08/2023 | START UP TRACKING SYSTEM | 11

Con los valores de offset podremos ajustar el valor de la posición de la antena lo mas cercano a la realidad.

Debemos de partir de una posición conocida, ejemplo 180° en AZ y si tenemos una offset 21° de elevación que es cuando la antena esta perpendicular al suelo. El botón de la derecha hay que pulsarlo para enviar el nuevo dato al controlador. Cerramos el programa.


06/08/2023 | START UP TRACKING SYSTEM | 12

## JPLastroserver

Iniciamos el programa

Debemos poner los valores adecuandos de latitud, longitud y altura de nuestro qth. Cerramos el programa.

## Verificación de las comunicaciones

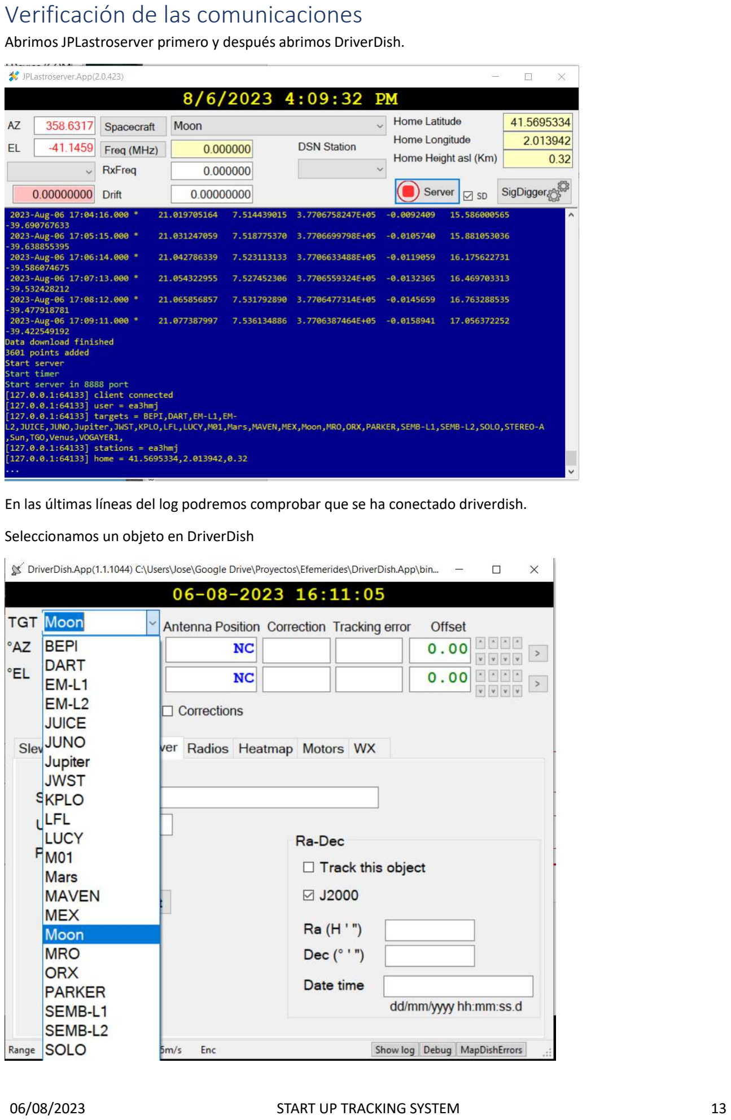
[picture p40: page 14]

06/08/2023 | START UP TRACKING SYSTEM | 13

Abrimos JPLastroserver primero y después abrimos DriverDish.

En las últimas líneas del log podremos comprobar que se ha conectado driverdish. Seleccionamos un objeto en DriverDish


06/08/2023 | START UP TRACKING SYSTEM | 14

El programa ya obtiene efemerides del servidor y podemos hacer seguimientos.

## SNserver

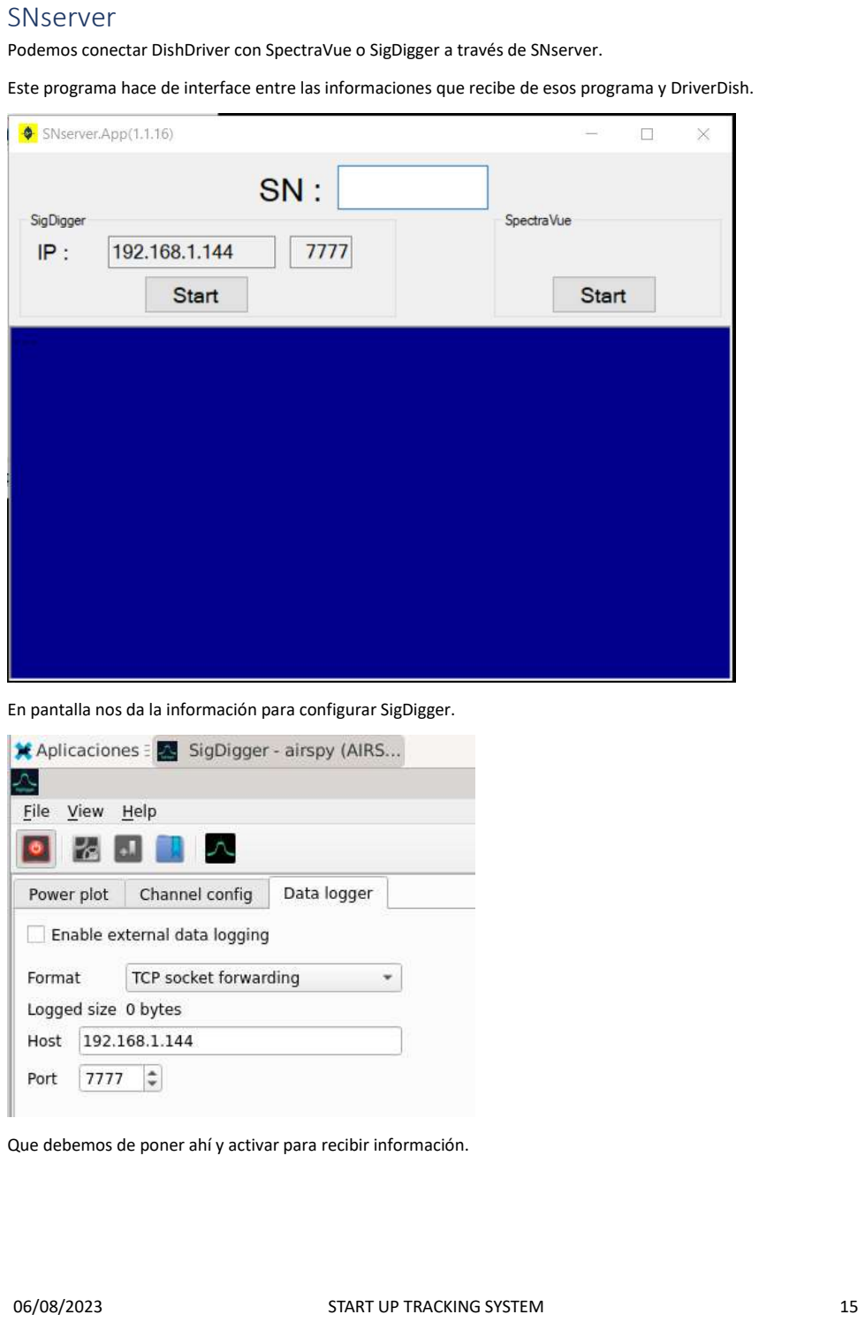
[picture p41: page 16]

06/08/2023 | START UP TRACKING SYSTEM | 15

Podemos conectar DishDriver con SpectraVue o SigDigger a través de SNserver.
Este programa hace de interface entre las informaciones que recibe de esos programa y DriverDish.

En pantalla nos da la información para configurar SigDigger.

Que debemos de poner ahí y activar para recibir información.

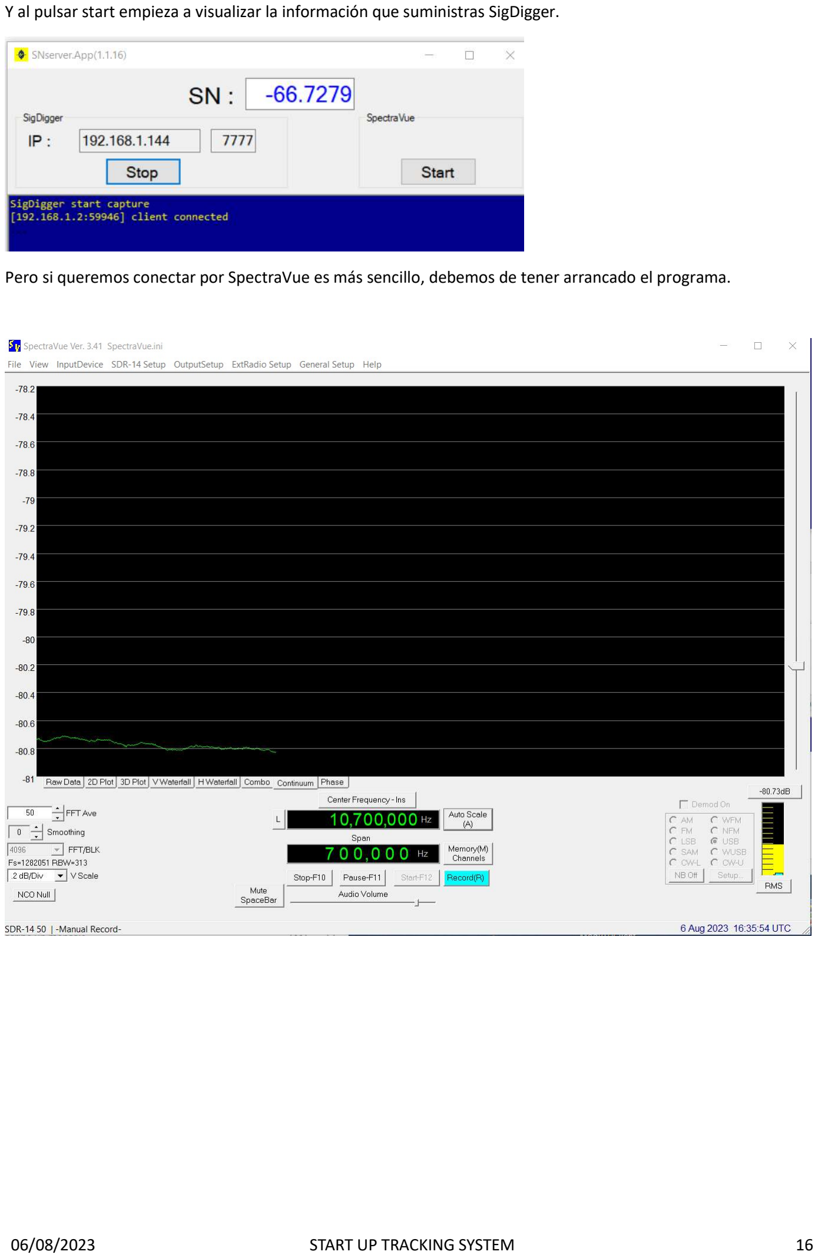
[picture p42: page 17]

06/08/2023 | START UP TRACKING SYSTEM | 16

Y al pulsar start empieza a visualizar la información que suministras SigDigger.

Pero si queremos conectar por SpectraVue es más sencillo, debemos de tener arrancado el programa.

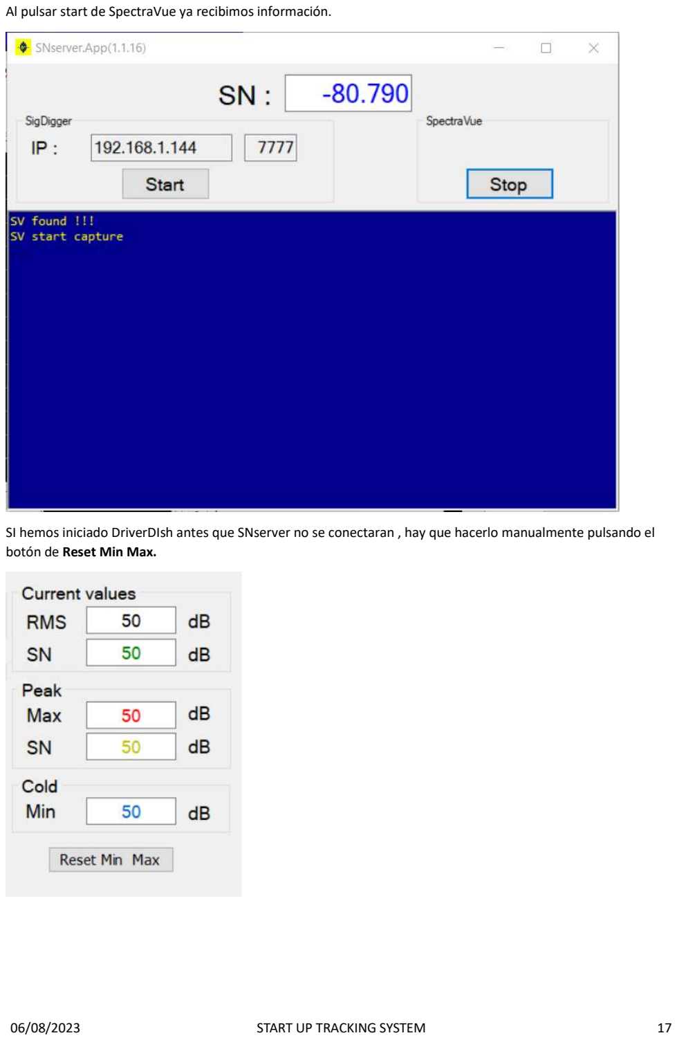
[picture p43: page 18]

06/08/2023 | START UP TRACKING SYSTEM | 17

Al pulsar start de SpectraVue ya recibimos información.

SI hemos iniciado DriverDIsh antes que SNserver no se conectaran , hay que hacerlo manualmente pulsando el botón de Reset Min Max.


06/08/2023 | START UP TRACKING SYSTEM | 18

Ya tenemos la información.
Si arrancamos primero SNserver al arrancar DriverDish automáticamente se conecta.
