ea3hmj/HMJTS/controller dish/mini weather station/wx V1 ESP.pdf

### VERSIÓN 1.0

16-04-2023

### WEATHER STATTION DISH CONTROLLER

© EA3HMJ

15-06-2021 | DISH CONTROLLER | 1


15-06-2021 | DISH CONTROLLER | 2

### DISH CONTROLLER

INTRODUCCIÓN
El controlador dispone de un puerto MOD-BUS RS485 para disposivos auxiliares, en este puerto conectamos la estación meteorológica WX.

Esta estación meteorológica esta compuesta por:
- ESP32 -S2 mini
- Sonda BME280
- Sonda MLX90614 10° POV
- Interface TTL - RS485

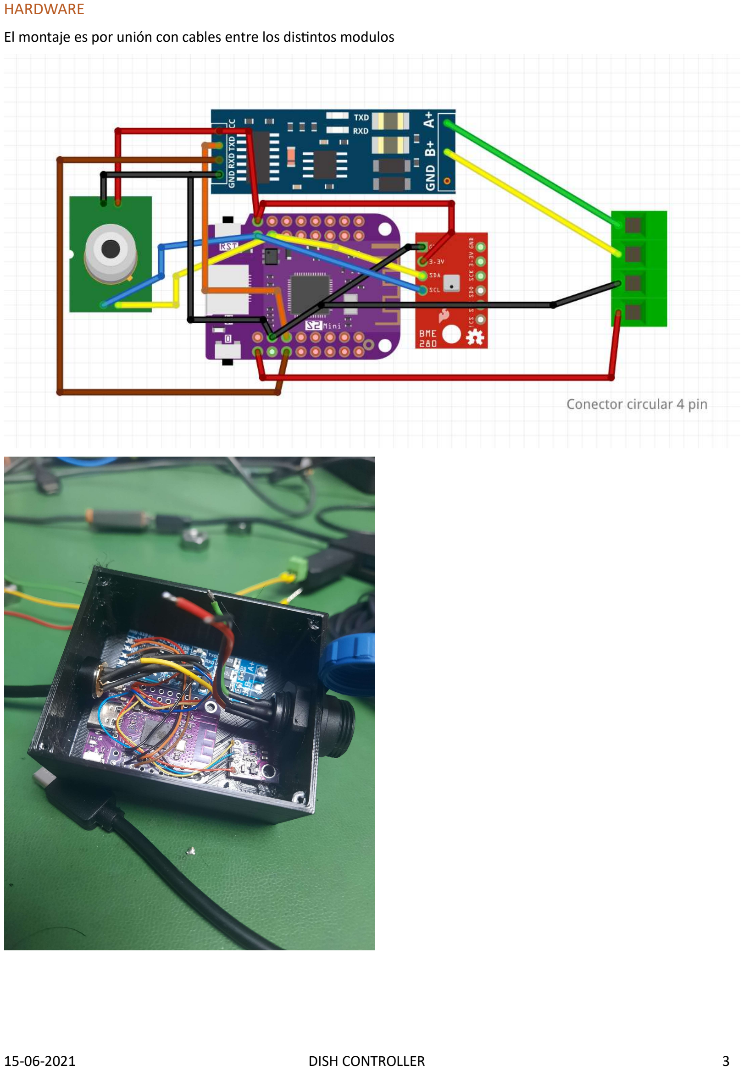
[picture p47: page 4]

15-06-2021 | DISH CONTROLLER | 3

HARDWARE
El montaje es por unión con cables entre los disntos modulos


15-06-2021 | DISH CONTROLLER | 4

COMUNICACIONES
La comunicación con el PC es a través de un puerto RS-485 a 57600 bauds. La dirección del disposivo es la número 3 y hay 5 registros con datos.
Registro | Contenido | Comentarios
0 | Temperatura del cielo | Devuelte la temperatura * 10
1 | Temperatura ambiente | Devuelte la temperatura * 10

2 Presión atmosférica

3 Humedad relava

4 | Temperatura BME280 | Devuelte la temperatura * 10

Estos valores los usara DriverDish.App

15-06-2021 | DISH CONTROLLER | 5

ENLACES DE COMPRAS
ESP32 S2 MINI
hps://www.amazon.es/Sxdluzi-V1-0-0-ESP32-S2FN4R2-ESP32-S2-MicroPython/dp/B0BPS4X6C9/ref=sr_1_1_sspa?__mk_es_ES=%C3%85M%C3%85%C5%BD%C3%95%C3%91&crid= O03W9L2VSBBF&keywords=ESP32+S2+Mini&qid=1681664534&s=electronics&sprefix=esp32+s2+mini+%2Celectron ics%2C95&sr=1-1-spons&sp_csd=d2lkZ2V0TmFtZT1zcF9hdGY&psc=1 hps://es.aliexpress.com/item/1005003145192016.html

ADAPTADOR TTL A RS485
HTTPS://WWW.AMAZON.ES/DP/B09Z2GTMJ8?PSC=1&REF=PPX_YO2OV_DT_B_PRODUCT_DETAILS hps://es.aliexpress.com/item/4001032241843.html?pdp_npi=2%40dis%21EUR%21%E2%82%AC%200.64%21%E2 %82%AC%200.55%21%21%21%21%21%40211b446216816647415508375efcc0%2110000013612022862%21b&_t =pvid%3A1bd3ddbe-5843-4520-8937-7037dd0f996e&afTraceInfo=4001032241843__pc__pcBridgePPC__xxxxxx__1681664741&spm=a2g0o.ppclist.produ ct.mainProduct&gatewayAdapt=glo2esp

BME280
hps://www.amazon.es/s?k=bme280+3%2C3v&ref=nb_sb_ss__1_4 hps://es.aliexpress.com/item/1005002950104941.html?pdp_npi=2%40dis%21EUR%21%E2%82%AC%200.80%21 %E2%82%AC%200.76%21%21%21%21%21%40211b5e1d16816651886764122e0b15%2112000022925834914%21b &_t=pvid%3Ad0062f42-466e-4436-bf42-ae8905e6ea85&afTraceInfo=1005002950104941__pc__pcBridgePPC__xxxxxx__1681665189&spm=a2g0o.ppclist.pr oduct.mainProduct&gatewayAdapt=glo2esp

MLX90614
hps://www.ebay.es/itm/173858657366?hash=item287ac89456:g:rzwAAOSw6n5XvLW9&amdata=enc%3AAQAIAA AAwICMTxSBsxy8PAX6rDxlUr%2FXbDutRZKorxaV5EpyON0BKKDuVTBHP8vM5Xnlu6rfCyp59uEsYmOrB2xD7d1Uu5aP Havjw3u7seGHzUjBaJTB9El08rAIBsckiTELlIcj9ozrf7C2uI4NxLpVNvFt3GdD2lNp11iZbqDto6JaQfwse2meCR5GUvWaQ pQmLk40Q6Lcy5%2FIAF%2B%2BS2%2BuK3DBceEe3Li3G2DRArKmla4JntOHyOKkNLz%2BFT8ta7I0FLpdGA%3D%3D% 7Ctkp%3ABk9SR-rQhrHxYQ
