ea3hmj/HMJTS/controller dish/main board/docs/Dish Controller v5 ENG.pdf

### VERSION 5.0

6-05-2023

### DISH CONTROLLER

Translated by EA4LE

© EA3HMJ

08-03-2023 | DISH CONTROLLER | 1

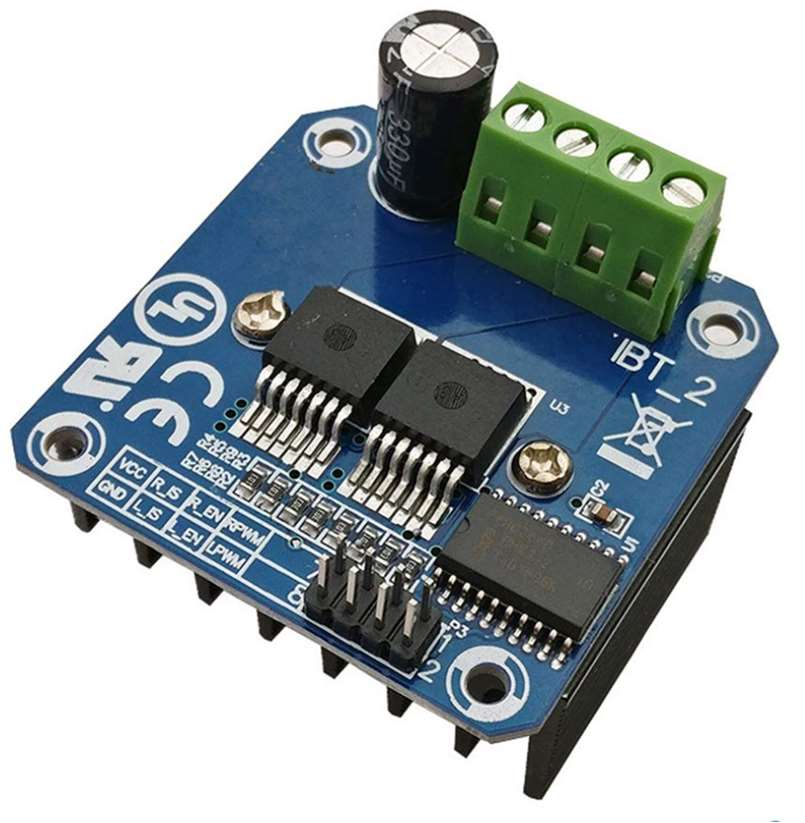
[picture p48: figure]
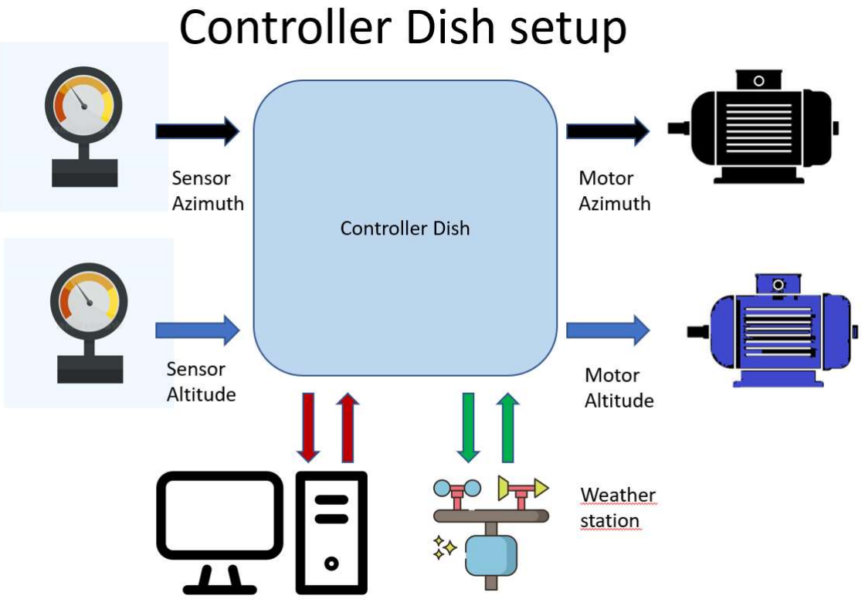
[picture p49: figure]

08-03-2023 | DISH CONTROLLER | 2

### DISH CONTROLLER

INTRODUCTION
The Dish Controller board version 5 differs from version 4 and it is not a direct replacement.

Version 5 offers disnct hardware features, including the absence of an onboard voltage up-converter, which allows for direct power supply from either 12 or 24V sources.

It also supports the affordable IBT_2 H-bridge motor drivers, and each motor can be powered separately with its own voltage, with independent monitoring of each motor's current.

In addion, version 5 has an extra controller bus for connecng auxiliary devices, such as the new compact weather staon. This weather staon is capable of measuring the sky temperature

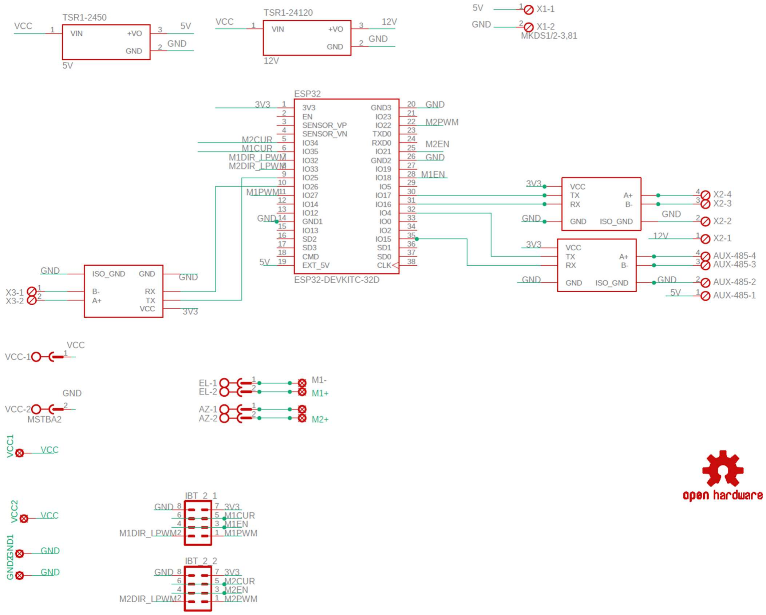
[picture p50: figure]

08-03-2023 | DISH CONTROLLER | 3

HARDWARE CONTROLADOR
The majority of the features remain the same as in previous versions, but now include the new motor driver opon.

FIRMWARE
Starng from version 2.4, the new firmware now includes an automac detecon feature for the type of motor driver being used. This eliminates the need for any manual configuraon, streamlining the setup process for users. ASSEMBLY DIRECTIONS
The assembly direcons for the new version remain the same as in previous versions, except for the connecon of the new IBT_2 motor driver. The control bus on this device is designed to use an 8-way IDC connector, while the power bus lines require 1mm diameter cable.

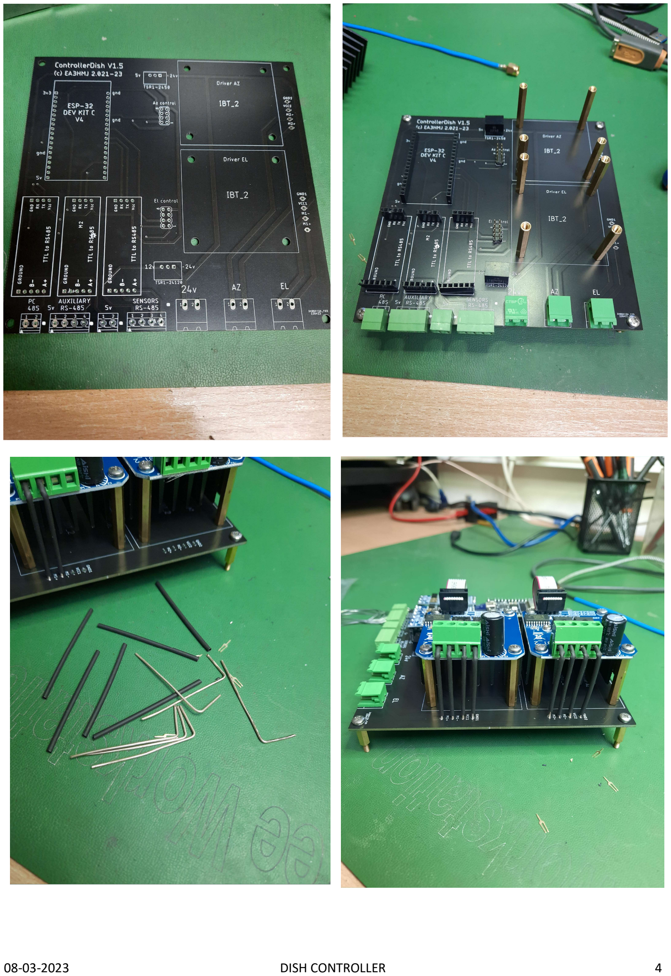
[picture p51: page 5]

08-03-2023 | DISH CONTROLLER | 4

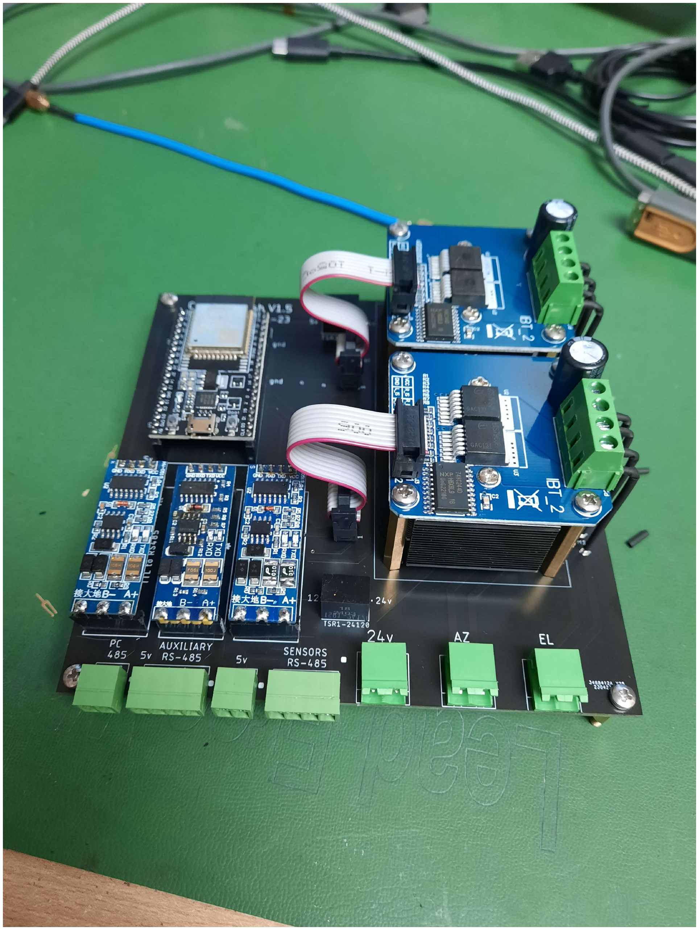
[picture p52: figure]

08-03-2023 | DISH CONTROLLER | 5

08-03-2023 | DISH CONTROLLER | 6

PURCHASING LINKS
DC CONVERTERS (36V MAX. INPUT VOLTAGE) hps://es.farnell.com/tracopower/tsr-1-2450/converter-dc-dc-5v-1a-sip/dp/1696320 hps://es.farnell.com/tracopower/tsr-1-24120/converdor-cc-cc-24v-12v-1a-sip/dp/1672130?st=tsr1-24120 MOTOR DRIVERS (2)
hps://www.googleadservices.com/pagead/aclk?sa=L&ai=DChcSEwjk3N6nlOX-AhVBgFAGHd58CoUYABAKGgJkZw&ohost=www.google.com&cid=CAESbeD2bo1V8LsuCqo79lI77-NstVpm4CR1W3GnSNVnx5-s3N0igP9xXnJvIbyygsPoqkW9CE3VXR7F1Vb8OOpzitZHqkEsszk_a2kv-M_kETdYVvUuddUddvEMuY1B-W6S33_gBksJQi-DMsopctk&sig=AOD64_0oUAsVfMlSiAPBuBmcqYuTOtgrbw&ctype=5&q=&ved=2ahUKEwjKp9inlOX-AhWMRMAKHbvGANwQ9aACKAB6BAgCEB4&adurl= hps://www.amazon.es/BTS7960-H-Bridge-corriente-Semiconductor-Refrigeraci%C3%B3n/dp/B07Y4TTK3Z/ref=dp_prsubs_sccl_1/260-6917266-6408167?pd_rd_w=AYVad&contentid=amzn1.sym.ab915153-2fea-42b5-89b1-8b48983ea8e7&pf_rd_p=ab915153-2fea-42b5-89b1-8b48983ea8e7&pf_rd_r=QZZBQE6D2NBDVZD487KF&pd_rd_wg=9vNFA&pd_rd_r=0f4e240c-adb6-4593-801eade620416c94&pd_rd_i=B07Y4TTK3Z&psc=1
