ea3hmj/HMJTS/controller dish/main board/docs/Dish Controller v5 ESP.pdf

### VERSIÓN 5.0

6-05-2023

### DISH CONTROLLER

© EA3HMJ

08-03-2023 | DISH CONTROLLER | 1

### DISH CONTROLLER

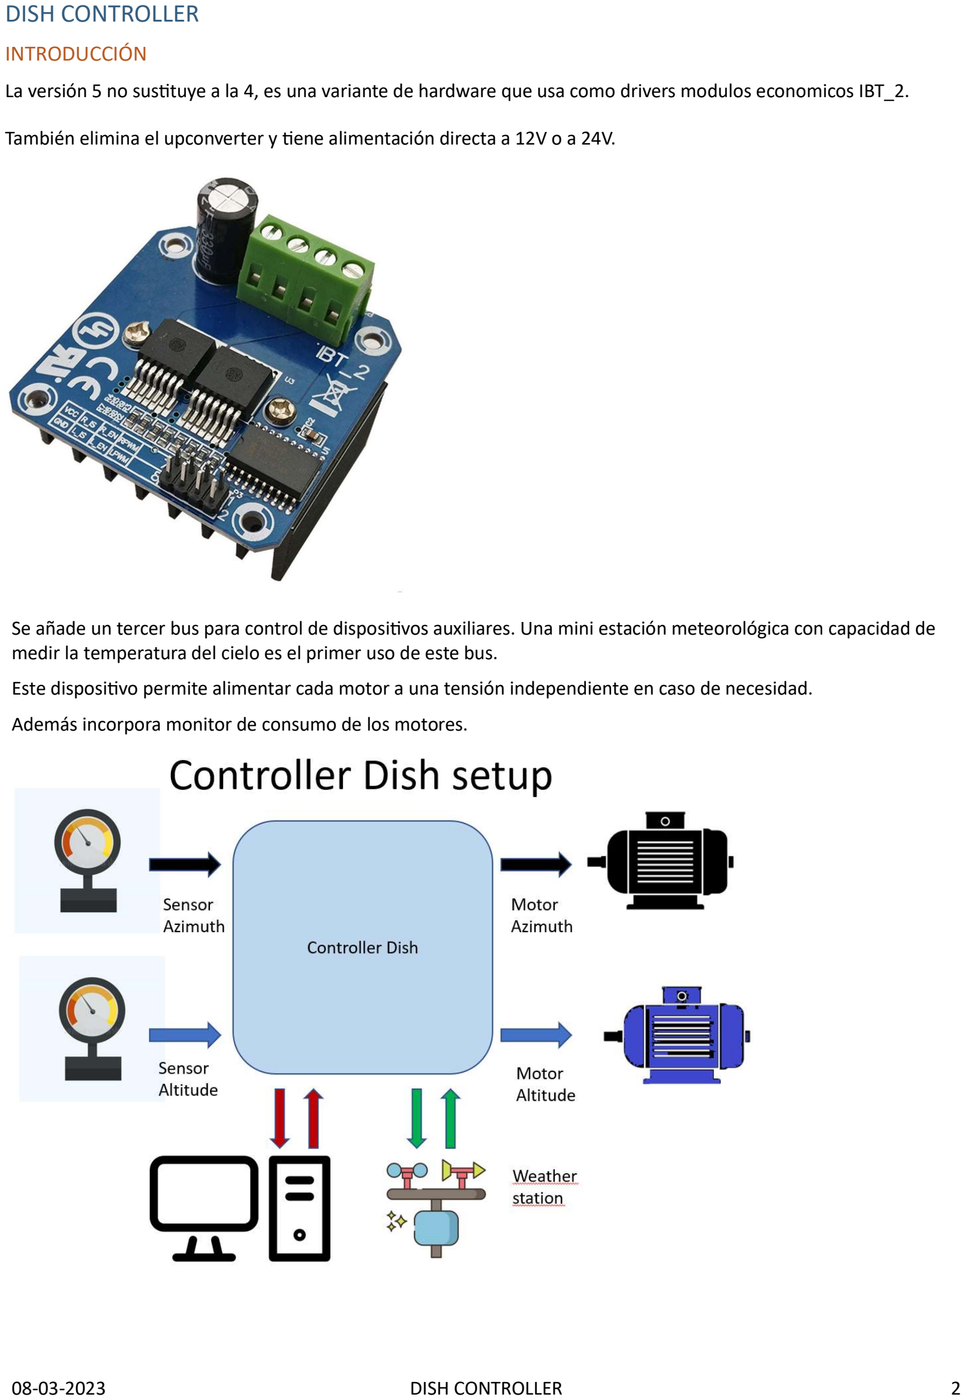
[picture p53: page 3]

08-03-2023 | DISH CONTROLLER | 2

INTRODUCCIÓN
La versión 5 no sustuye a la 4, es una variante de hardware que usa como drivers modulos economicos IBT_2.

También elimina el upconverter y ene alimentación directa a 12V o a 24V.

Se añade un tercer bus para control de disposivos auxiliares. Una mini estación meteorológica con capacidad de medir la temperatura del cielo es el primer uso de este bus.
Este disposivo permite alimentar cada motor a una tensión independiente en caso de necesidad.
Además incorpora monitor de consumo de los motores.


08-03-2023 | DISH CONTROLLER | 3

HARDWARE CONTROLADOR
Es de aplicación la lo mismo que las versiones anteriores más el añadido del nuevo driver.

FIRMWARE
A parr de la versión 2.4. el firmware detecta automácamente el po de driver empleado, por lo que no es necesario realizar ninguna configuración.
MONTAJE
El proceso de montaje es el descrito en el anterior manual a excepción del driver IBT_2 que la conexión de control se realiza por un peine de 8 vias IDC y las de potencia con cable de 1 mm de diametro..


08-03-2023 | DISH CONTROLLER | 4


08-03-2023 | DISH CONTROLLER | 5

08-03-2023 | DISH CONTROLLER | 6

ENLACES DE COMPRAS
REGULADORES DE TENSION (TENSIÓN DC MÁX. DE ENTRADA:36V) hps://es.farnell.com/tracopower/tsr-1-2450/converter-dc-dc-5v-1a-sip/dp/1696320 hps://es.farnell.com/tracopower/tsr-1-24120/converdor-cc-cc-24v-12v-1a-sip/dp/1672130?st=tsr1-24120 MODULO REGULADOR MOTORES (2) hps://www.googleadservices.com/pagead/aclk?sa=L&ai=DChcSEwjk3N6nlOX-AhVBgFAGHd58CoUYABAKGgJkZw&ohost=www.google.com&cid=CAESbeD2bo1V8LsuCqo79lI77-NstVpm4CR1W3GnSNVnx5-s3N0igP9xXnJvIbyygsPoqkW9CE3VXR7F1Vb8OOpzitZHqkEsszk_a2kv-M_kETdYVvUuddUddvEMuY1B-W6S33_gBksJQi-DMsopctk&sig=AOD64_0oUAsVfMlSiAPBuBmcqYuTOtgrbw&ctype=5&q=&ved=2ahUKEwjKp9inlOX-AhWMRMAKHbvGANwQ9aACKAB6BAgCEB4&adurl= hps://www.amazon.es/BTS7960-H-Bridge-corriente-Semiconductor-Refrigeraci%C3%B3n/dp/B07Y4TTK3Z/ref=dp_prsubs_sccl_1/260-6917266-6408167?pd_rd_w=AYVad&contentid=amzn1.sym.ab915153-2fea-42b5-89b1-8b48983ea8e7&pf_rd_p=ab915153-2fea-42b5-89b1-8b48983ea8e7&pf_rd_r=QZZBQE6D2NBDVZD487KF&pd_rd_wg=9vNFA&pd_rd_r=0f4e240c-adb6-4593-801eade620416c94&pd_rd_i=B07Y4TTK3Z&psc=1
