ea3hmj/HMJTS/ephemerides/JPLastroserver/readme.md

# JPLASTROSERVER
Download the application and run it, you only have to define your position (Latitude, Longitude and altitude in Kms).

For spacecraft tracking, the server can calculate the doppler of the probe's emission frequency, but we must enter it in the file sondas.txt.

The format of the probes.txt file is a text file with **;** delimiter.

If the line starts with **;** it is a comment.

The fields are:
Naif Id;Name;Rx frequency in MHz

Example
-170;JWST;2270.5

In the combobox list all the objects included in the file sondas.txt will appear.

It`s now possible to send commands to SigDigger software to control the Doppler Rate in the Doppler Tool menu.
Both machines IP must be known, JPL Server must be configured with the IP and port from SigDigger machine:

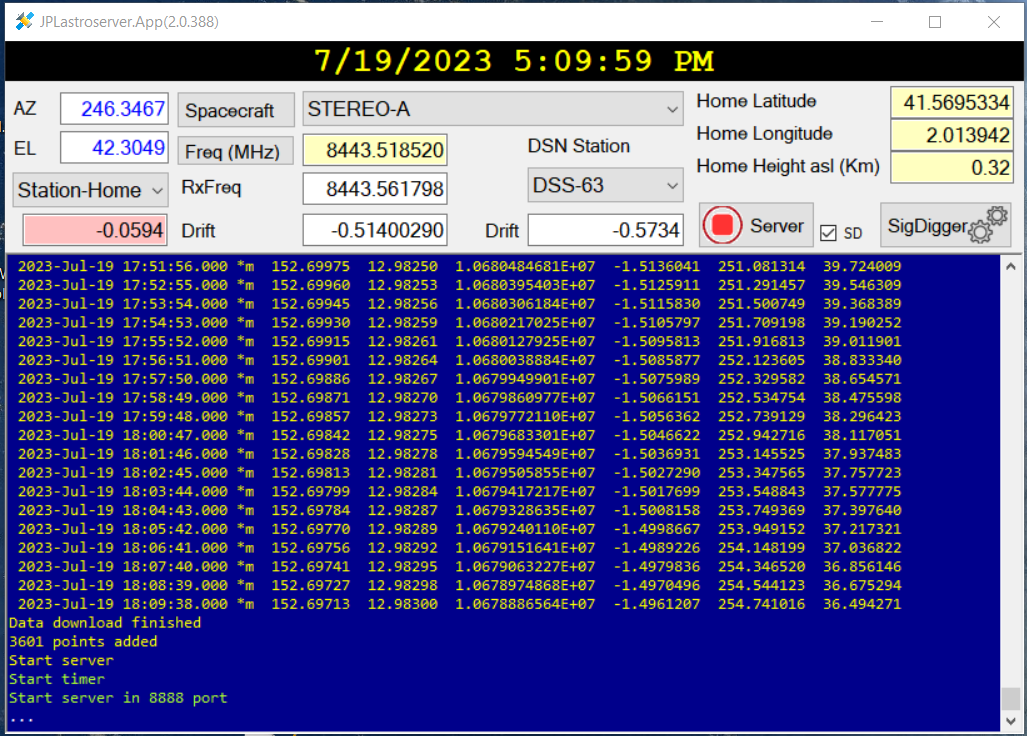
[picture p54: img/jpl11.png]


SigDigger must have enabled the remote operation, with its own IP and port:

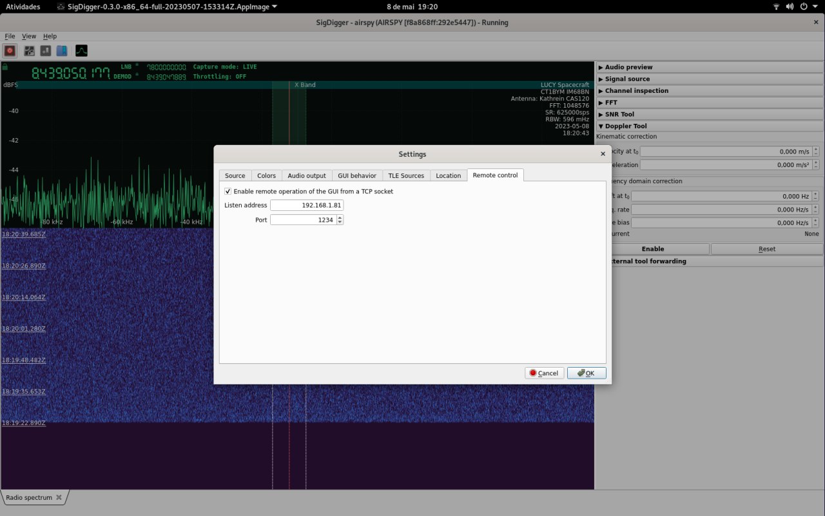
[picture p55: img/SD1.jpg]


Sometimes the spacecraft is locked to some Groundstation from Deep Space Network.

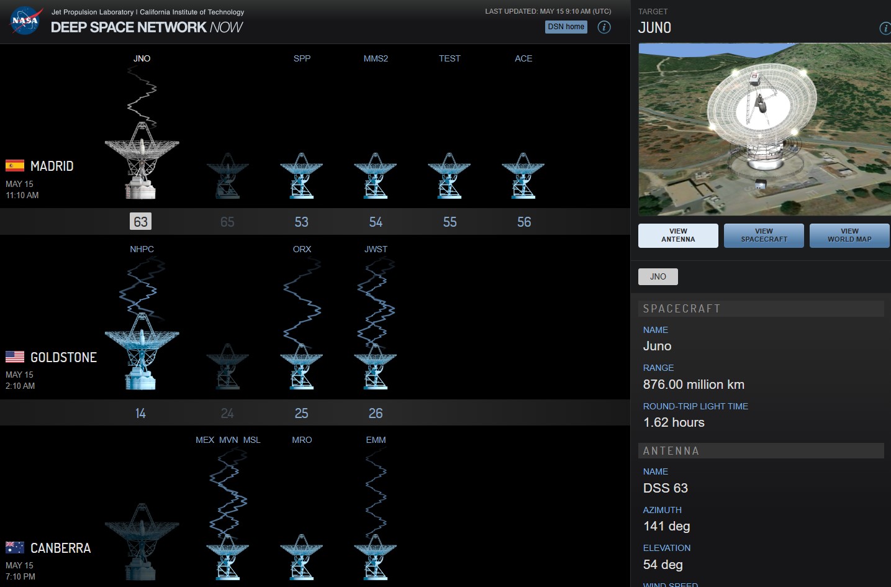
[picture p56: img/DSN1.jpg]


It`s now possible to compensate also this difference in Doppler by selecting the Ground Station. The software will perform all the calculations needed and send the results to SigDigger.

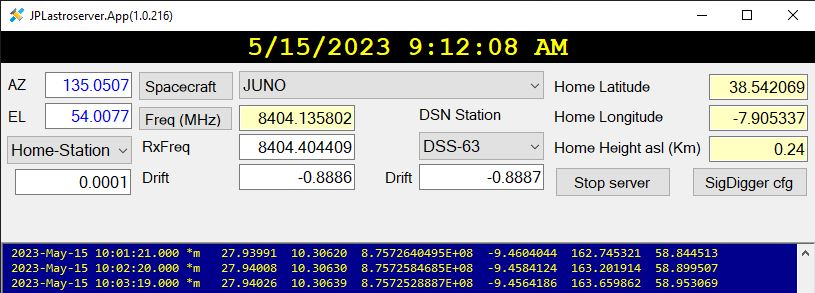
[picture p57: img/JPL3.JPG]




When press button Spacecraft, list all small bodys found in JPL system.
 


Added search functionality.



## New server for satellites
Through the system menu you can change the server.
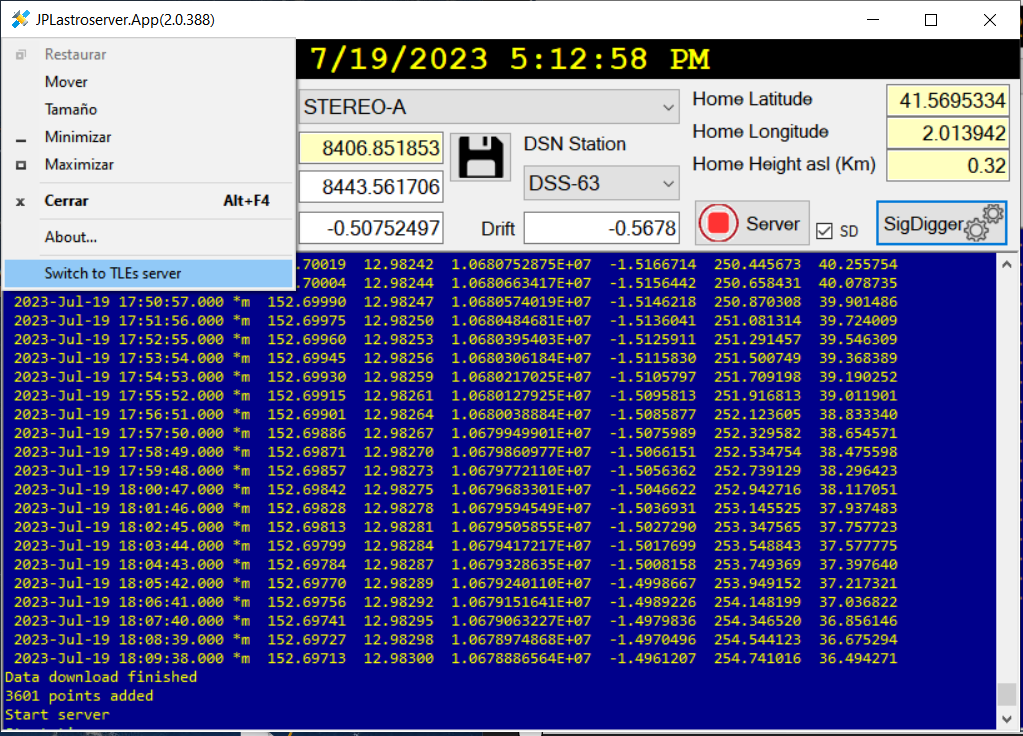
[picture p58: img/jpl14.png]

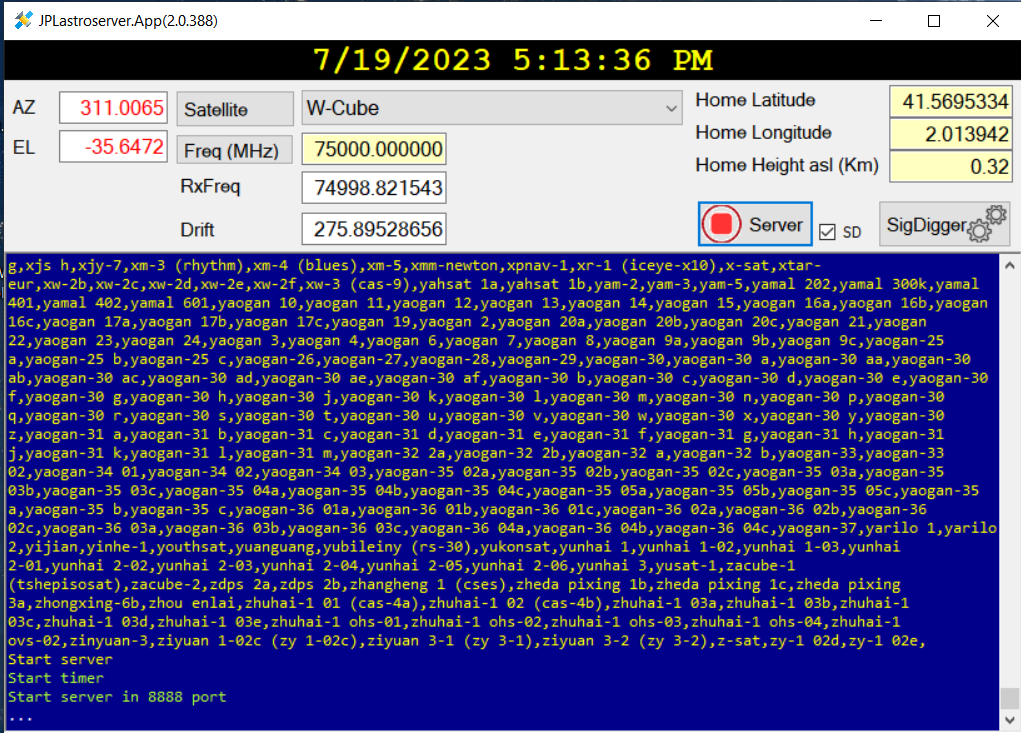
[picture p59: img/jpl15.png]


You can choose the satellite from the list of active satellites or by editing the satelites.txt file.

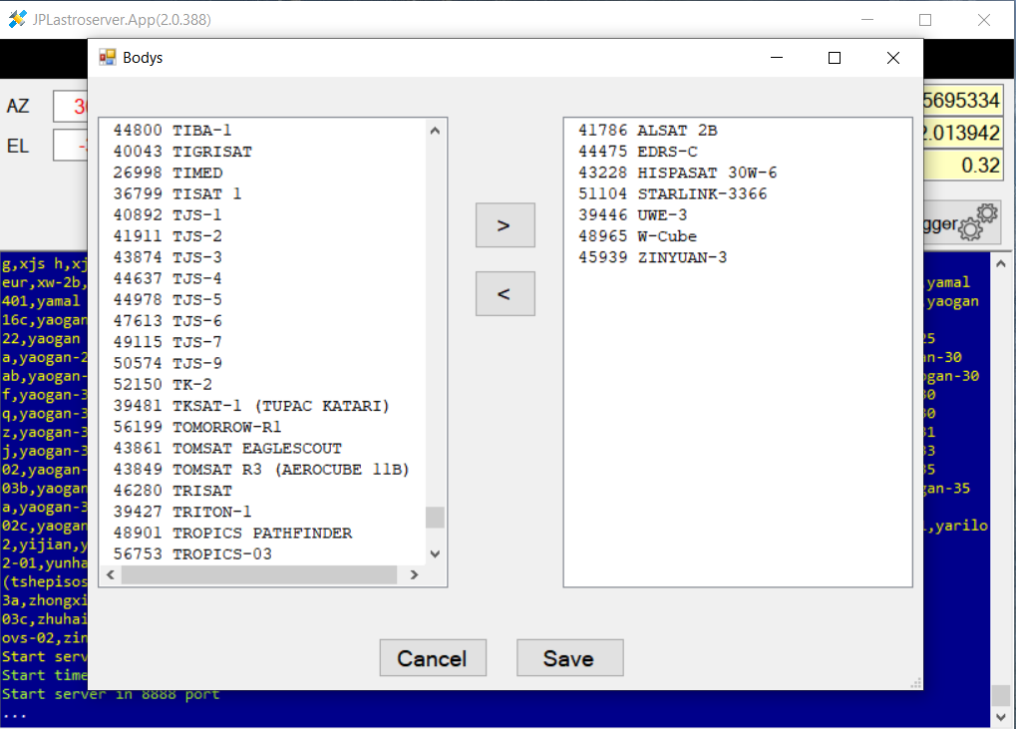
[picture p60: img/jpl16.png]


Added search functionality when press button Satellite.



## Disclaimer
This is a tracking systems designed for amateur use in Moonbounce, Radioastronomy and DSN. It requieres advanced skills of electronics and software, only recommended to users with previous experience with tracking systems.

Warning this software is distributed as is and I can not supply support. I write  it for myself and now I share it for other users that are asking about my tracking system.

This source and the whole package comes without warranty. It may or may not harm your computer or cell phone. Please use with care. Any damage cannot be related back to the author. The source has been tested on a real environment and scanned for viruses and has passed all tests.
