ea3hmj/HMJTS/DriverDish/SNserver/readme.md

This server enables the possibility to chose from two sources of Data: SigDigger or SpectraVue.



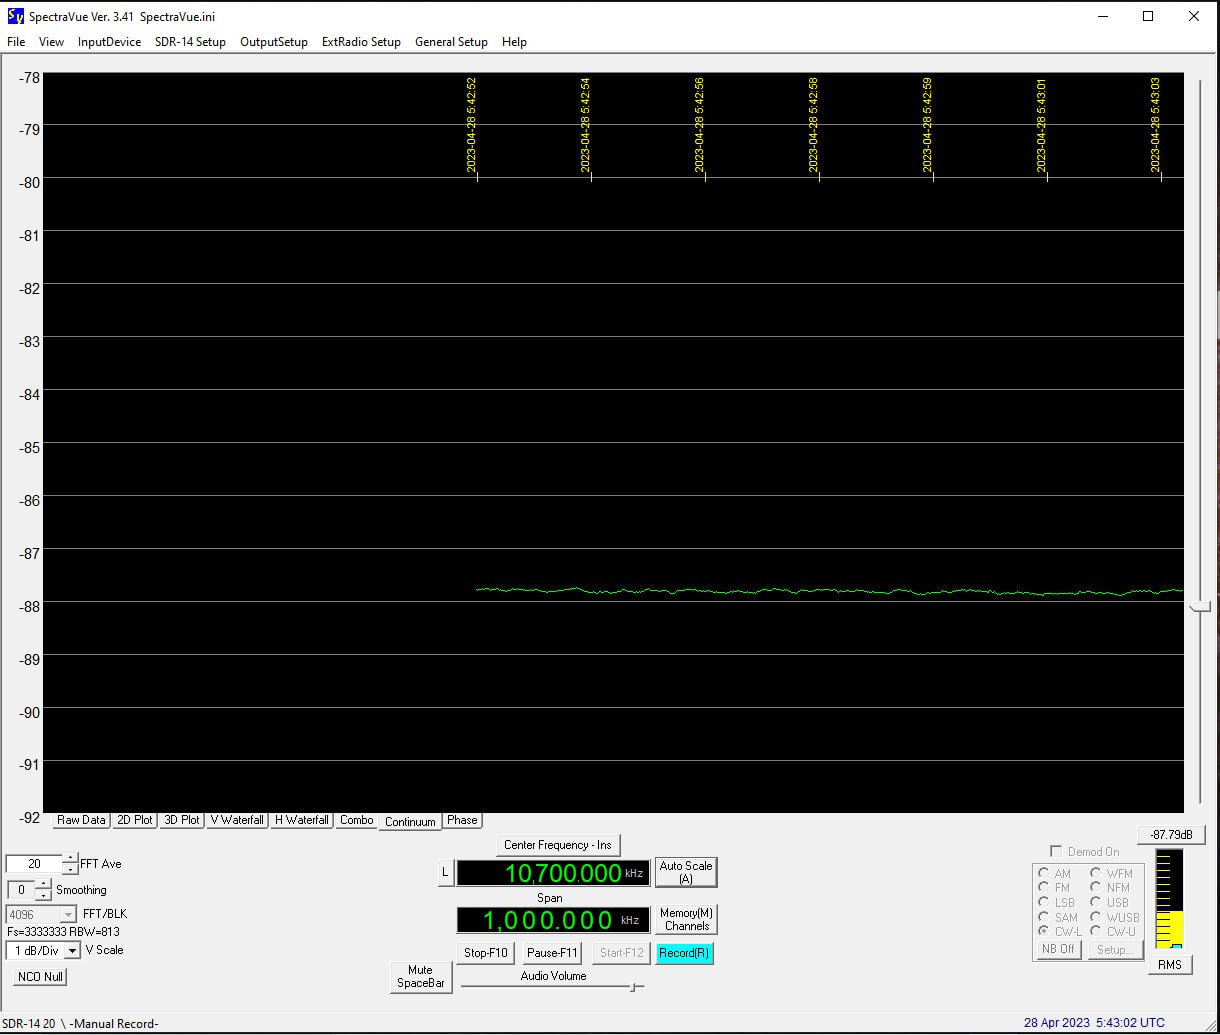
[picture p61: img/SV.jpg]


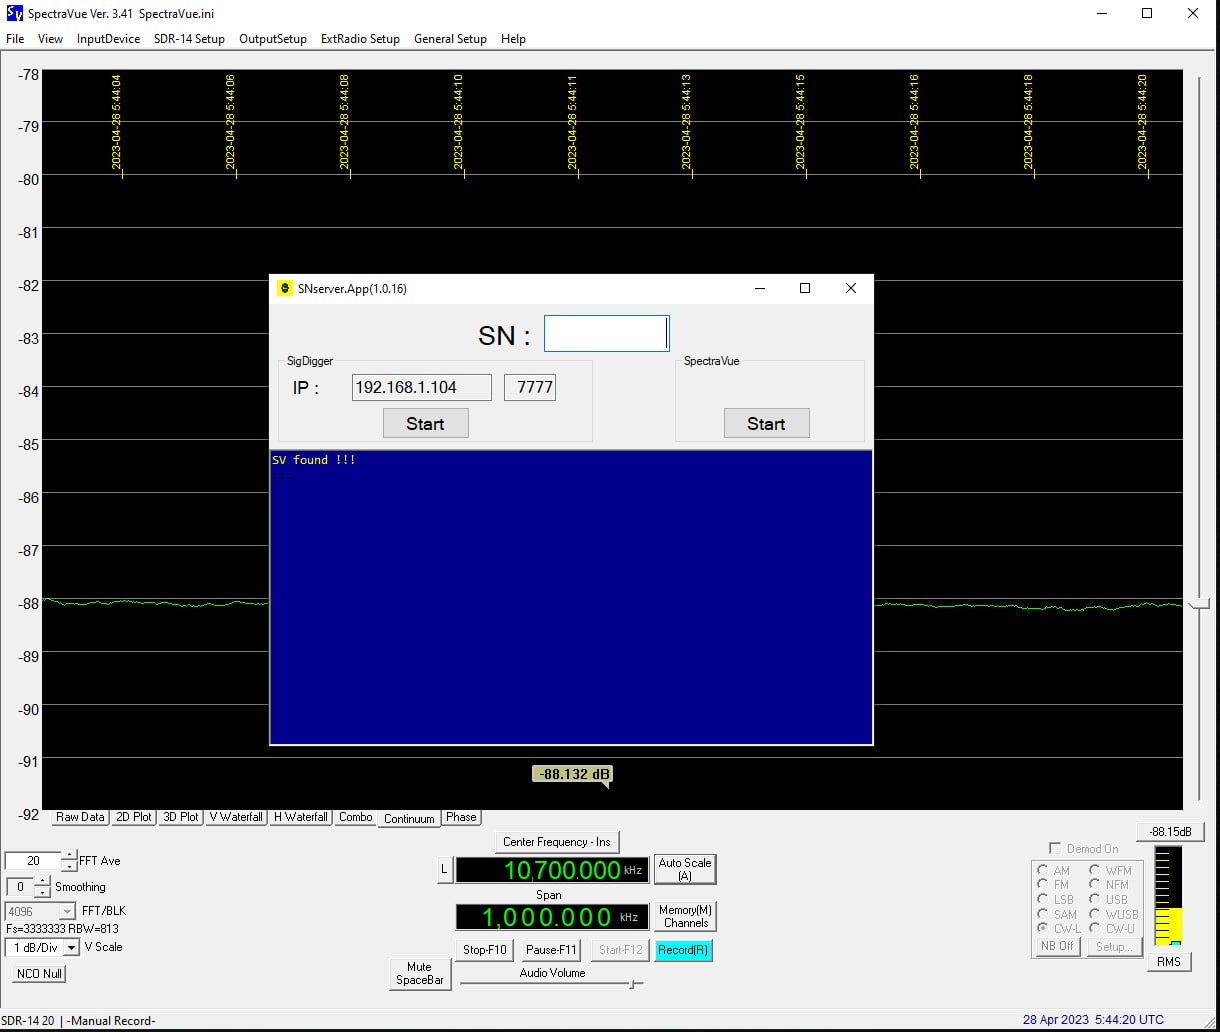
[picture p62: img/SVySNS.jpg]


With SigDigger running, open the "Channel Inspection" menu:

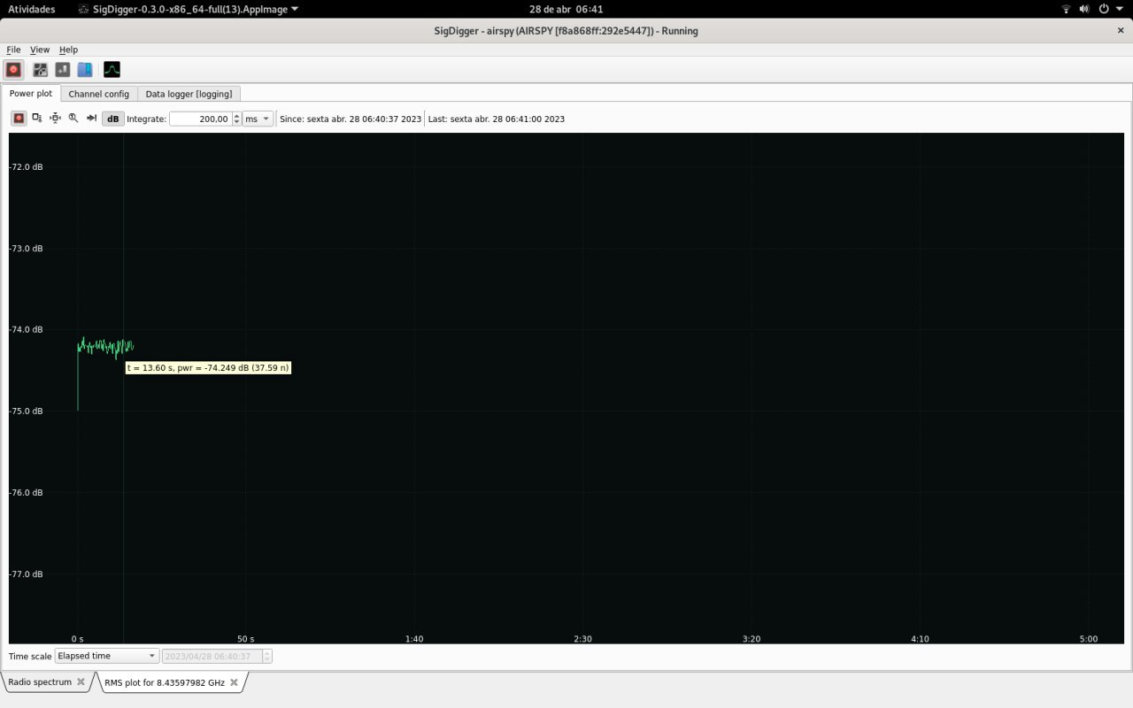
[picture p63: img/SD2.jpg]


In the "Data Logger" menu, you must configure the TCP data taken from SN Server:

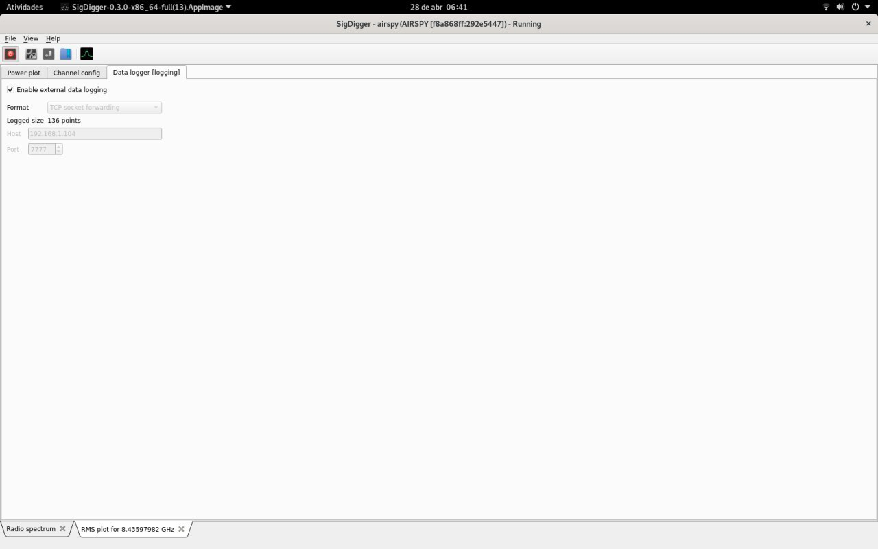
[picture p64: img/SD3.jpg]


When all configurations are settle, open first SpectaVue and SigDigger.
After that, run DriverDish and press start on the server, chosing from SigDigger or SpectraVue.

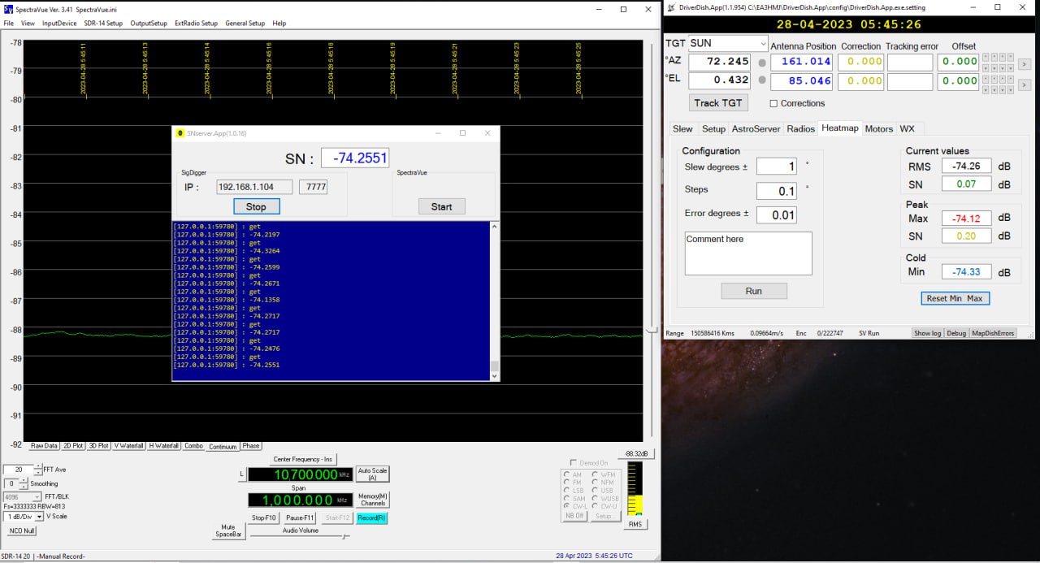
[picture p65: img/DDtotal.jpg]
