ea3hmj/HMJTS/ephemerides/AstroserverHelper.App/readme.md

This App enables you to create a list of coordinates were an object can be found at a specific time. For example, it is useful when some kind of transit measurements are needed.
Use same user as DriverDish in the AstroServer config menu, Server is localhost, port 8888.
This App is used with Astroserver, and uses the same objects.

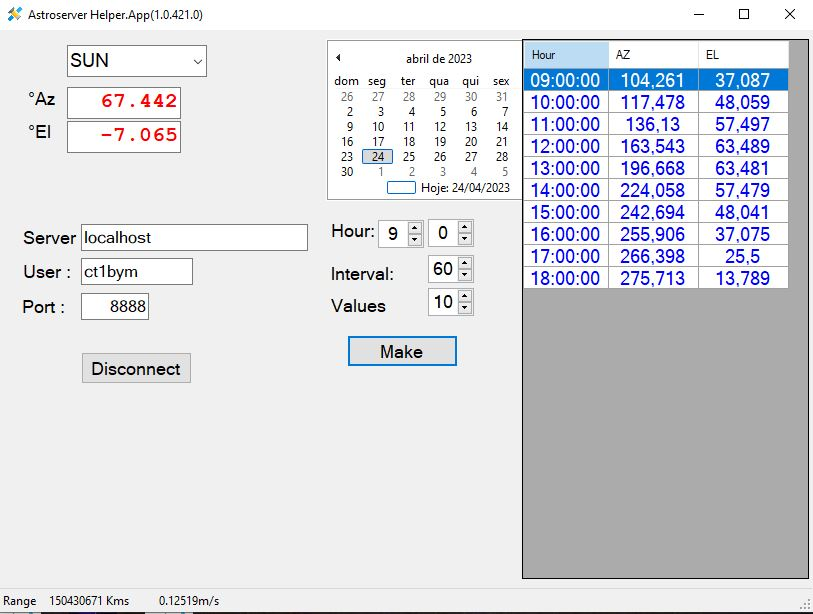
[picture p66: img/AstroHelper.JPG]
