ea3hmj/HMJTS/controller dish/main board/readme.md

# CONTROLLER DISH
The controller allows to manage two motors with their corresponding position sensors.

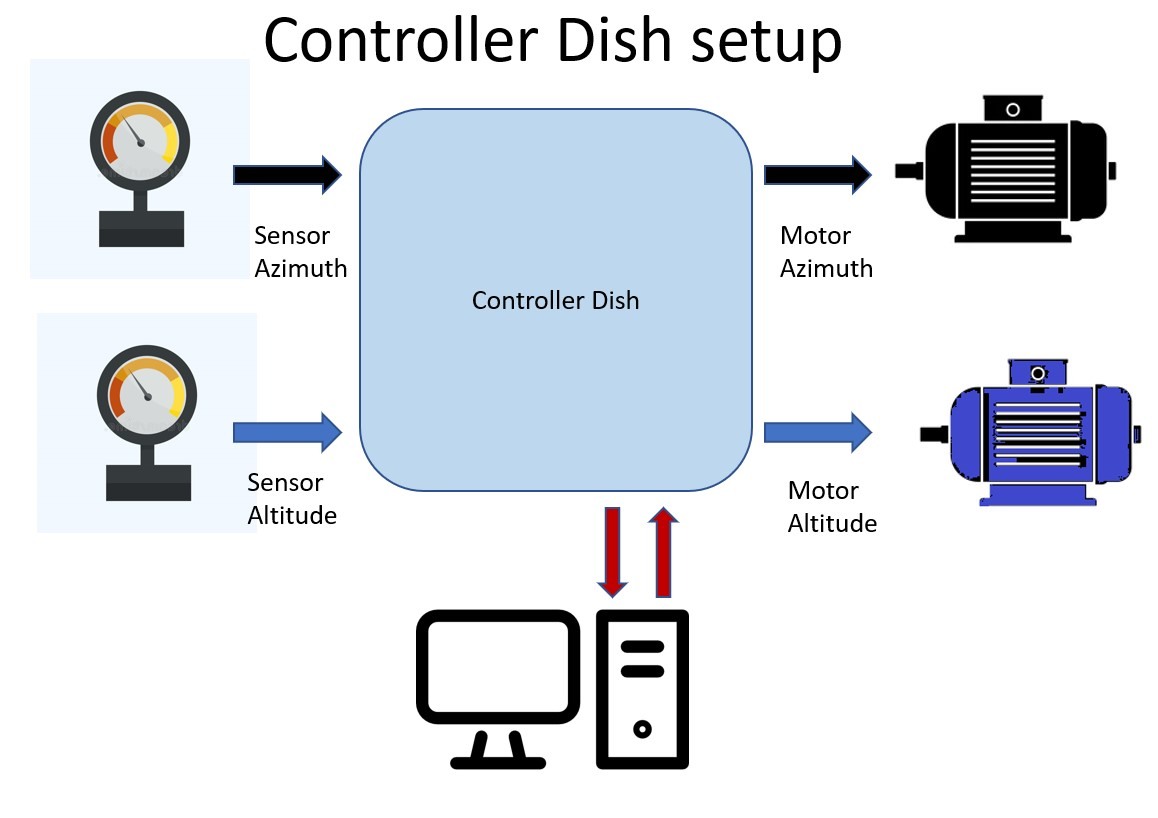
[picture p67: img/controlledishsetup.jpg]


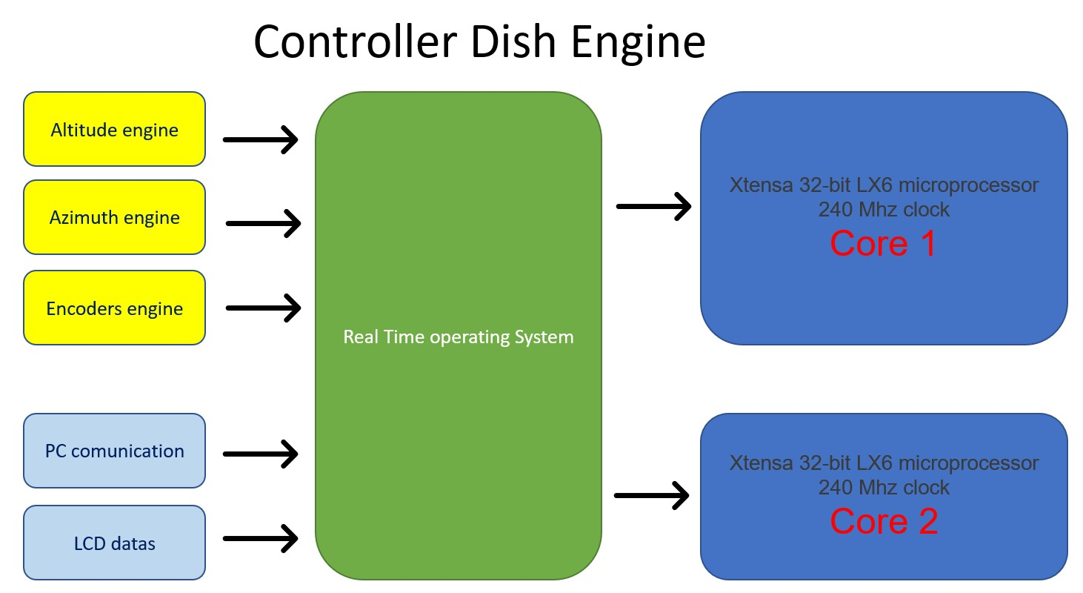
[picture p68: img/controllerdishengine.jpg]


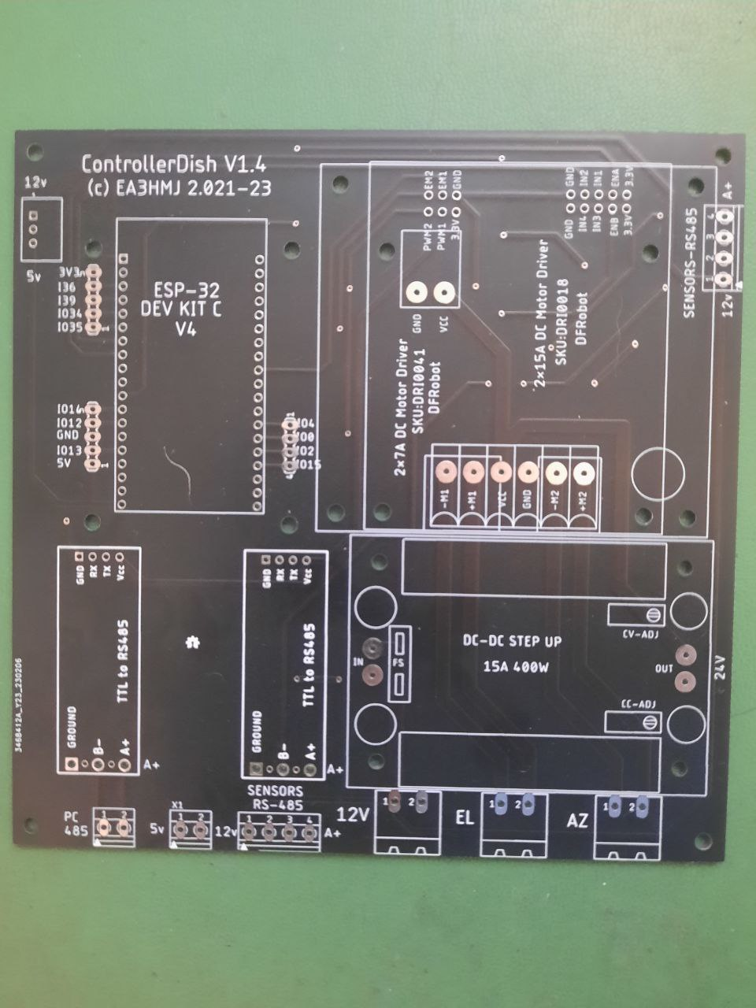
[picture p69: img/Dish Controler V4.png]


## Documentation
For details, please read the document: [Dish Controller v4 ENG.pdf](docs/Dish%20Controller%20v4%20ENG.pdf)

## Disclaimer
This is a tracking systems designed for amateur use in Moonbounce, Radioastronomy and DSN. It requieres advanced skills of electronics and software, only recommended to users with previous experience with tracking systems.

Warning this software is distributed as is and I can not supply support. I write  it for myself and now I share it for other users that are asking about my tracking system.

This source and the whole package comes without warranty. It may or may not harm your computer or cell phone. Please use with care. Any damage cannot be related back to the author. The source has been tested on a real environment and scanned for viruses and has passed all tests.
