ea3hmj/HMJTS/controller dish/main board/docs/Dish Controller v4 ENG.pdf

### VERSION 4.0

8-03-2023

### DISH CONTROLLER

Translated by EA4LE
© EA3HMJ

08-03-2023 | DISH CONTROLLER | 1
ASSEMBLY DIRECTIONS | Error! Bookmark not defined.
PURCHASING LINKS | Error! Bookmark not defined.

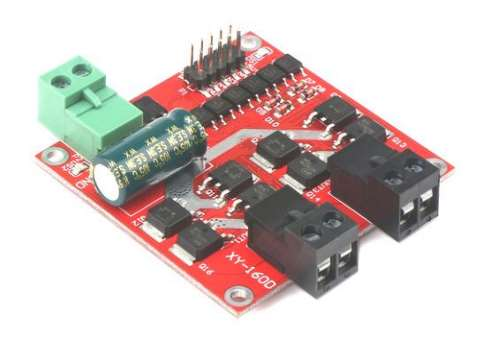
[picture p85: figure]

08-03-2023 | DISH CONTROLLER | 2

### DISH CONTROLLER

INTRODUCTION
The new Version 4 of the dish controller PCB not only supports the previous driver/motor controller but also allows the use of XY-160D model Chinese drivers.

In comparison to the now obsolete previous motor driver, the XY-160D driver is not only cheaper but also offers an important advantage of enabling the use of the motor brake funcon.

HARDWARE CONTROLLER UPDATES
The majority of the features remain the same as in previous versions, but now include the new motor driver opon. The previous on-board LCD screen has been replaced with a more convenient remote controller, which has its own display.
Addionally, the connectors have been updated; the three power connectors (Vcc, AZ, and EL motors) have been upgraded to pitch 5.08, while the rest are now pitch 3.81.
To accommodate future new features, three new data buses have been added.

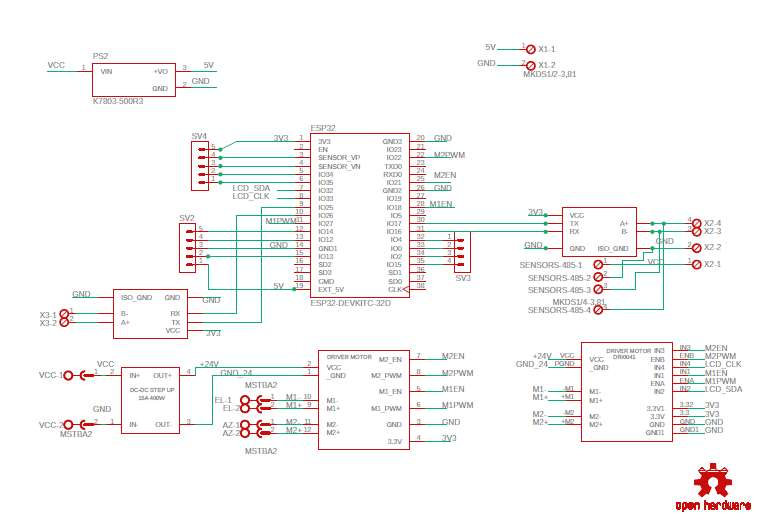
[picture p86: figure]

08-03-2023 | DISH CONTROLLER | 3

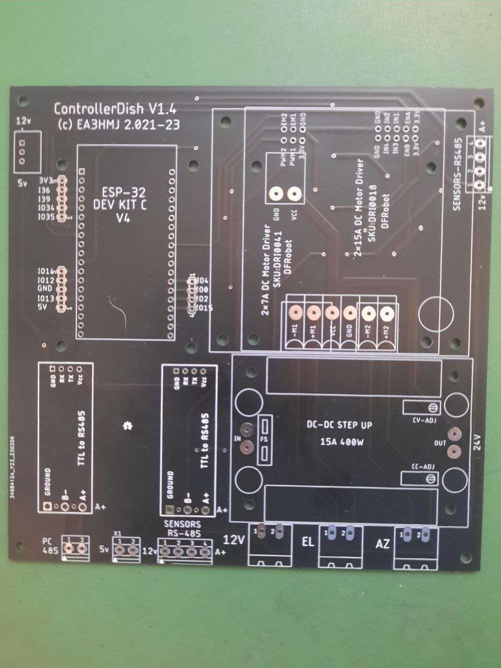
[picture p87: page 5]

08-03-2023 | DISH CONTROLLER | 4

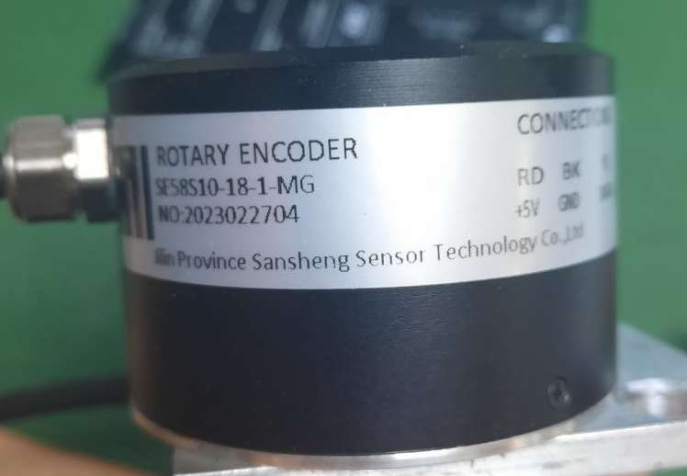
[picture p88: figure]

08-03-2023 | DISH CONTROLLER | 5

FIRMWARE
The new firmware has an automac detecon feature for the type of motor driver used, which eliminates the need for any manual configuraon.
RECOMMENDED AZIMUTH AND ELEVATION SENSORS
The use of mechanical mulpliers is no longer recommended due to the high amount of backlash.
We highly recommend the use SANSHENG SENSOR rotary encoder model SE58S10. This is a high performance 18-bit single-turn absolute encoder. We have conducted extensive tesng on this item and achieved outstanding results.

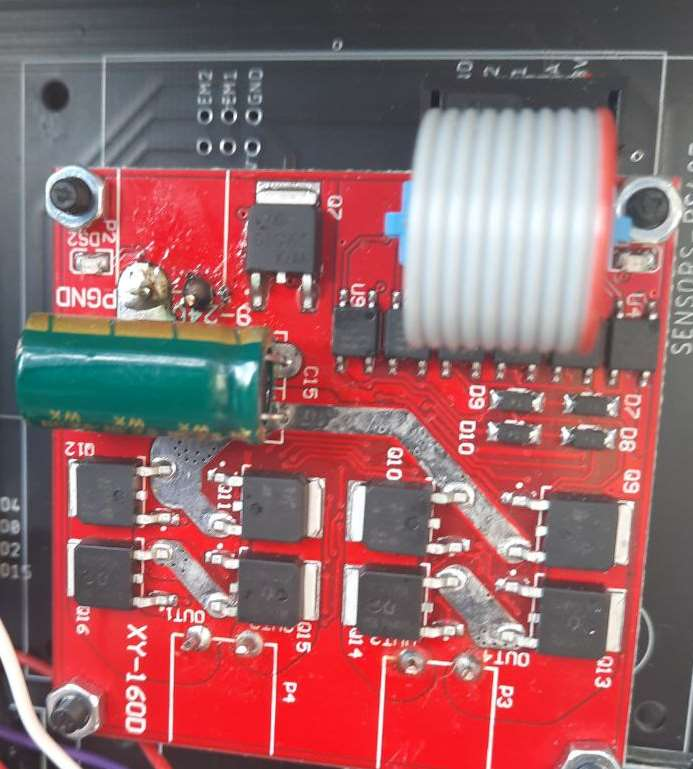
[picture p89: figure]

08-03-2023 | DISH CONTROLLER | 6

ASSEMBLY DIRECTIONS
The assembly direcons for the new version remain the same as in previous versions, except for the connecon of the new XY-160D motor driver. The XY-160D driver is connected to the board using a 10 Pin Dual Row IDC Female Socket Connector.

08-03-2023 | DISH CONTROLLER | 7

PURCHASING LINKS
XY-160D MOTOR DRIVER (1)
hps://es.aliexpress.com/i/32801170537.html hps://www.amazon.com/-/es/XY-160D-Controlador-velocidad-M%C3%B3dulo-industrial/dp/B07RQWXT8N
