ea3hmj/HMJTS/controller dish/main board/docs/Dish Controller v4 ESP.pdf

### VERSIÓN 4.0

8-03-2023

### DISH CONTROLLER

© EA3HMJ

08-03-2023 | DISH CONTROLLER | 1


08-03-2023 | DISH CONTROLLER | 2

### DISH CONTROLLER

INTRODUCCIÓN
La versión 4 permite ulizar el driver de motores original o el driver chino XY-160D

Este driver puede usar la función freno del motor y es más barato que el original que ya esta descatalogado.

HARDWARE CONTROLADOR
Es de aplicación la lo mismo que las versiones anteriores más el añadido del nuevo driver.
Se suprime el LCD al contar con un mando a distancia que ene más funcionalidad.
Se han cambiado los conectores para mantener una coherencia, los de potencia (Vcc, Motor Az y motor El) son de paso 5.08 mientras que el resto son de paso 3.81.
Se añaden tres buses al micro para ampliaciones futuras.


08-03-2023 | DISH CONTROLLER | 3


08-03-2023 | DISH CONTROLLER | 4


08-03-2023 | DISH CONTROLLER | 5

FIRMWARE
El firmware detecta automácamente el po de driver empleado, por lo que no es necesario realizar ninguna configuración.
SENSORES AZIMUT Y ELEVACIÓN RECOMENDADOS
Con respecto a los enconder explicados en el anterior manual se descarta el uso de mulplicador mecánico al tener mucho backslat.
Hay un enconder absoluto ópco de 18 bits que es una maravilla de la empresa china SANSHENG SENSOR, el modelo SE58S10


08-03-2023 | DISH CONTROLLER | 6

MONTAJE
El proceso de montaje es el descrito en el anterior manual a excepción del driver XY-160D que la conexión de control se realiza por un peine de 10 vias IDC.

08-03-2023 | DISH CONTROLLER | 7

ENLACES DE COMPRAS
MODULO REGULADOR MOTORES (1)
hps://es.aliexpress.com/i/32801170537.html hps://www.amazon.com/-/es/XY-160D-Controlador-velocidad-M%C3%B3dulo-industrial/dp/B07RQWXT8N
