ea3hmj/HMJTS/img/EA3HMJ_DishController_connections.png

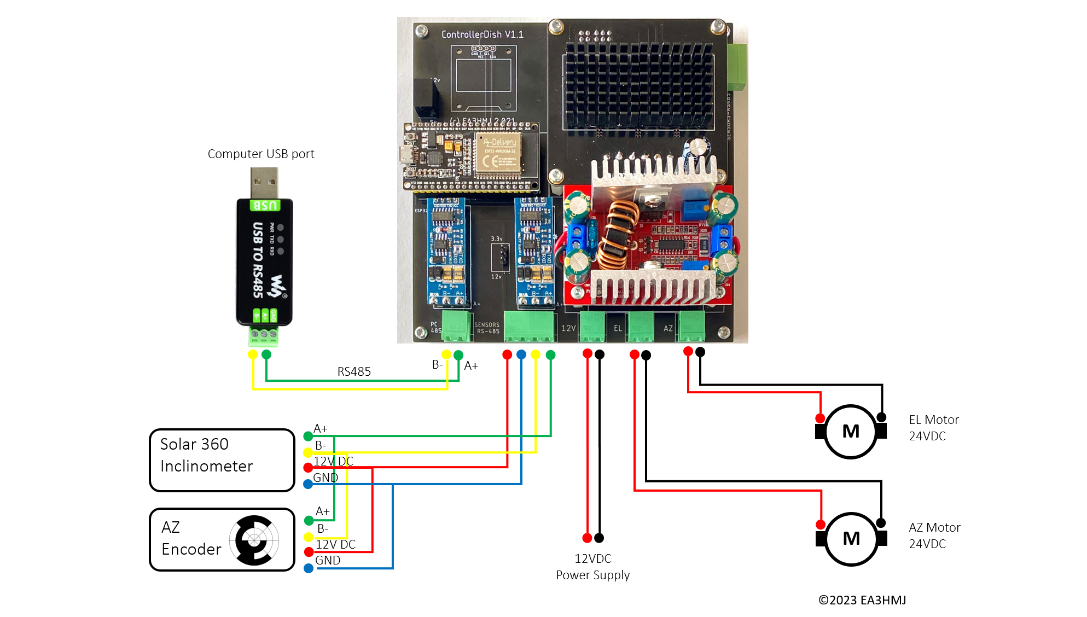
img/EA3HMJ_DishController_connections.png
