ea3hmj/HMJTS/img/eme system.jpg

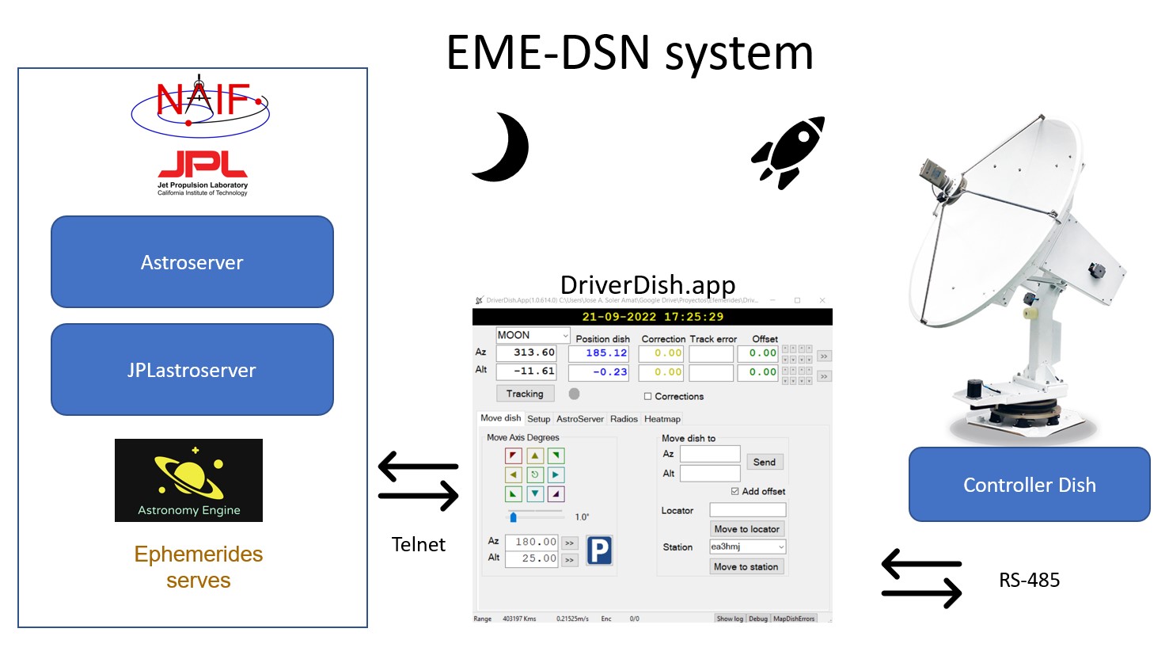
img/eme system.jpg
