ea3hmj/HMJTS/img/heatmap 76.png

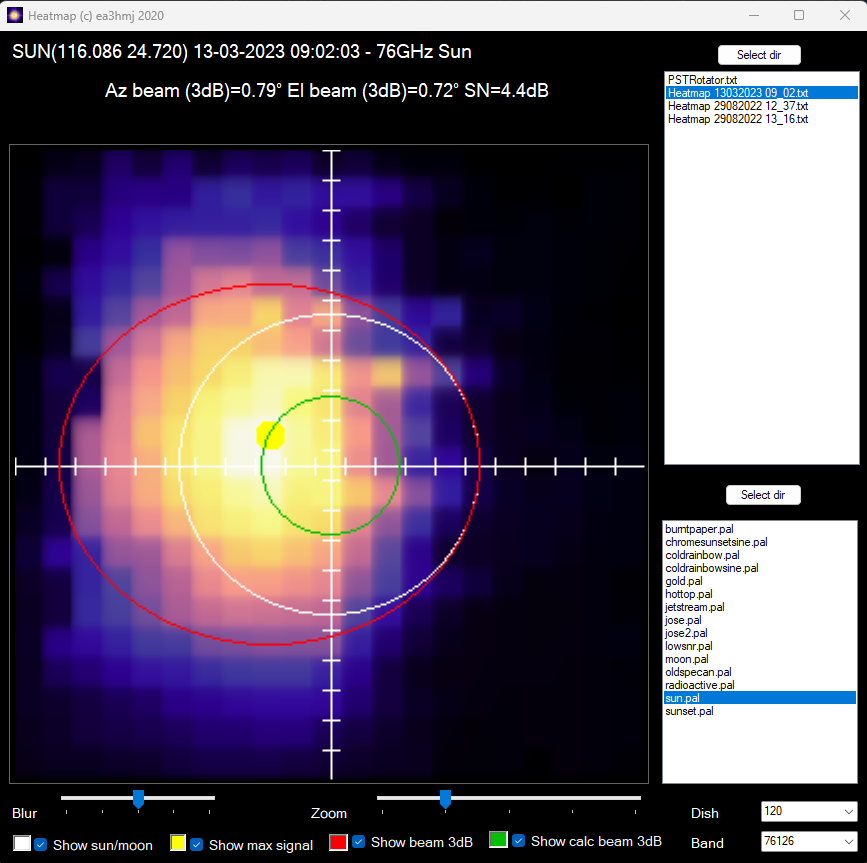
img/heatmap 76.png
