ea3hmj/HMJTS/img/heatmap diriverdish.jpg

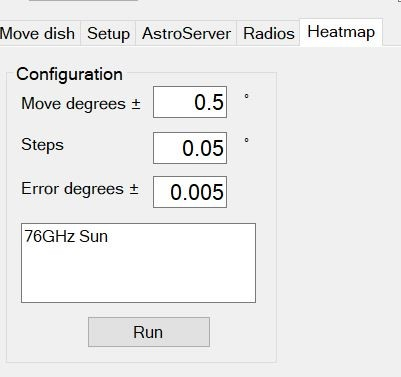
img/heatmap diriverdish.jpg
