ea3hmj/HMJTS/img/horizons_cartoon.jpg

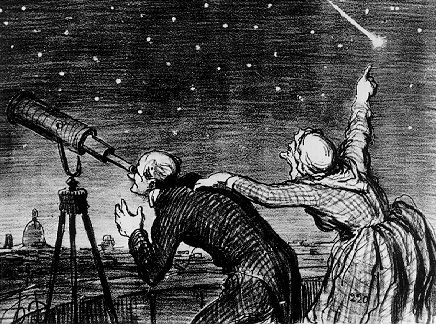
img/horizons_cartoon.jpg
