ea3hmj/HMJTS/img/JPL1.jpg

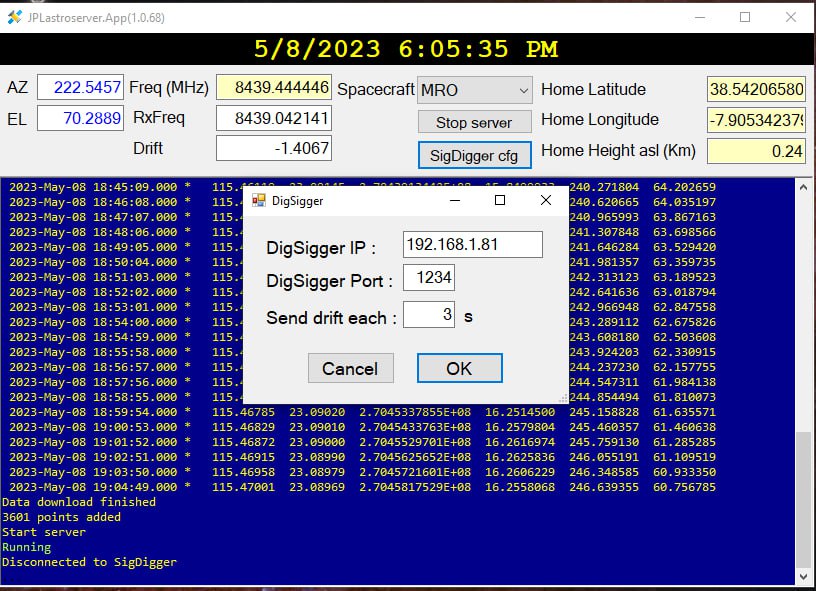
img/JPL1.jpg
