ea3hmj/HMJTS/img/JPL2.jpg

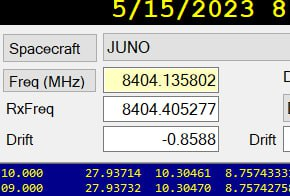
img/JPL2.jpg
