ea3hmj/HMJTS/img/JPL4.jpg

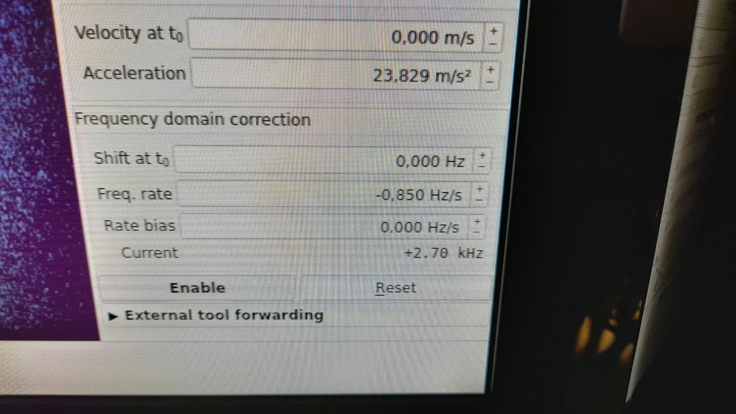
img/JPL4.jpg
