ea3hmj/HMJTS/img/jpl12.png

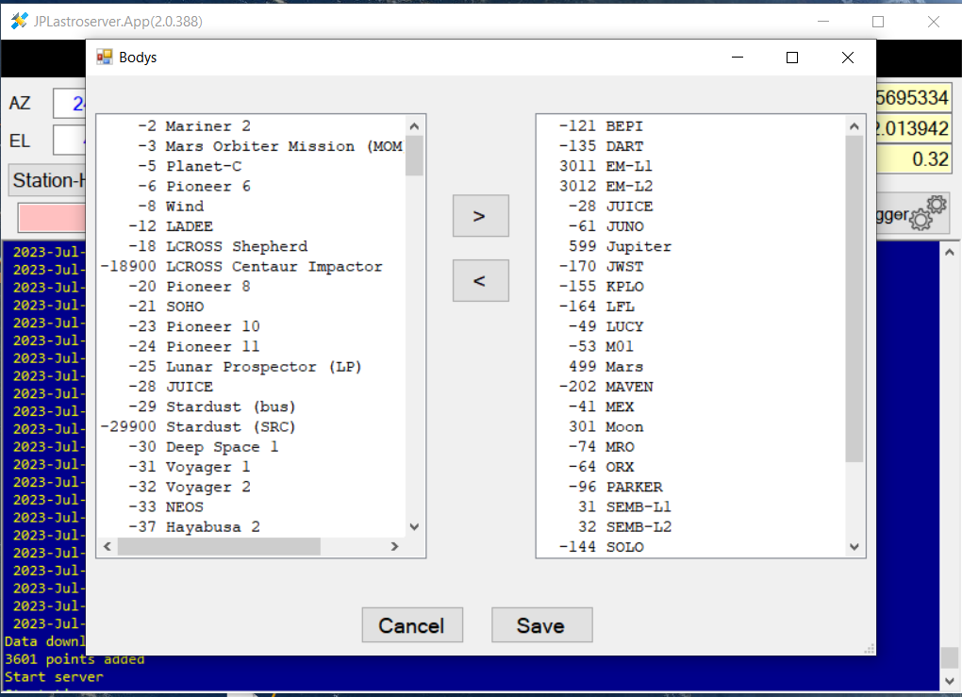
img/jpl12.png
