ea3hmj/HMJTS/img/jpl13.png

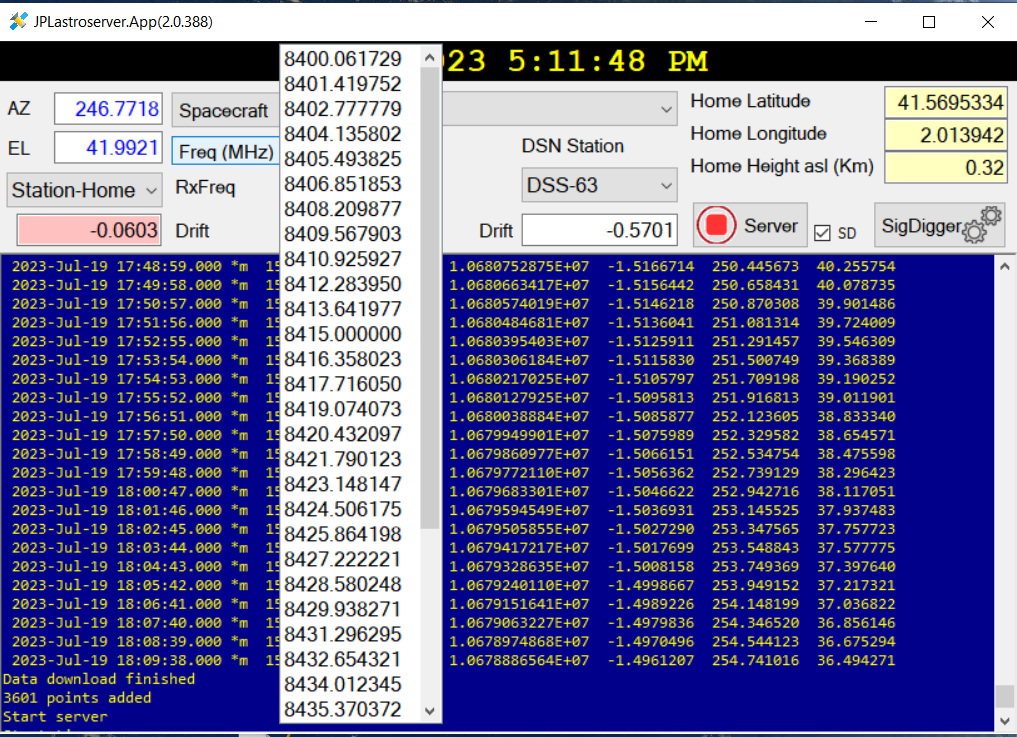
img/jpl13.png
