ea3hmj/HMJTS/controller dish/remote/stl/botones.stl

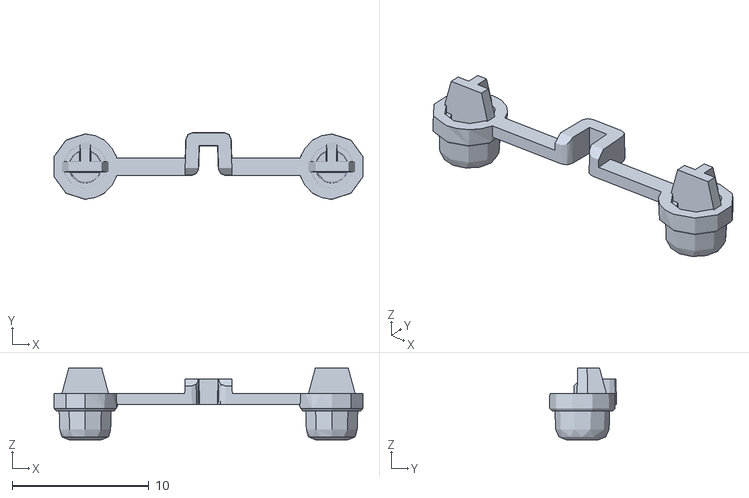
[picture p101: CAD file, 2023-02-12]
controller dish/remote/stl/botones.stl
22.6 x 4.89 x 5.25
