ea3hmj/HMJTS/controller dish/remote/stl/parte superior.stl

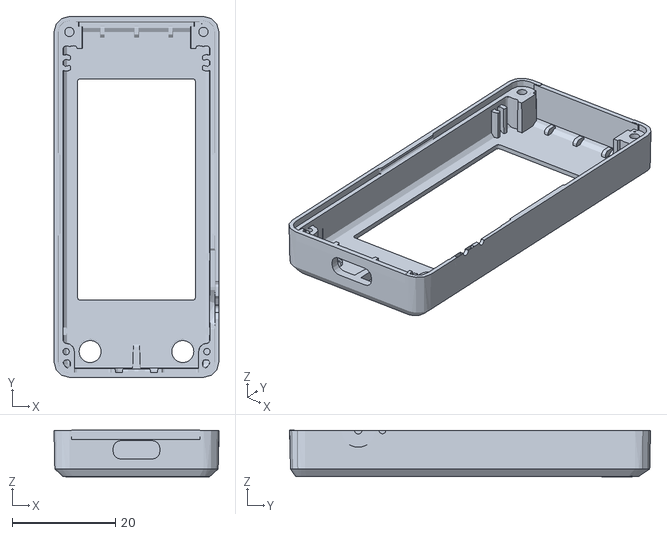
[picture p102: CAD file, 2023-02-12]
controller dish/remote/stl/parte superior.stl
32.0 x 70.0 x 9.03
