ea3hmj/HMJTS/controller dish/remote/stl/parte inferior.stl

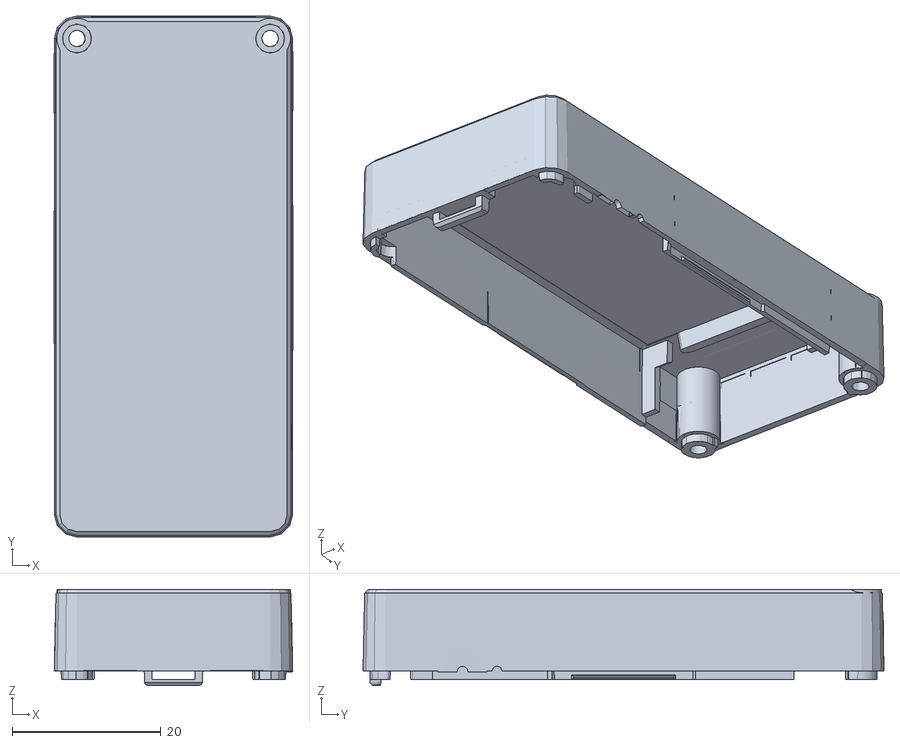
[picture p103: CAD file, 2023-02-12]
controller dish/remote/stl/parte inferior.stl
32.1 x 70.0 x 13.0
