ea3hmj/HMJTS/controller dish/mini weather station/esquema.pdf

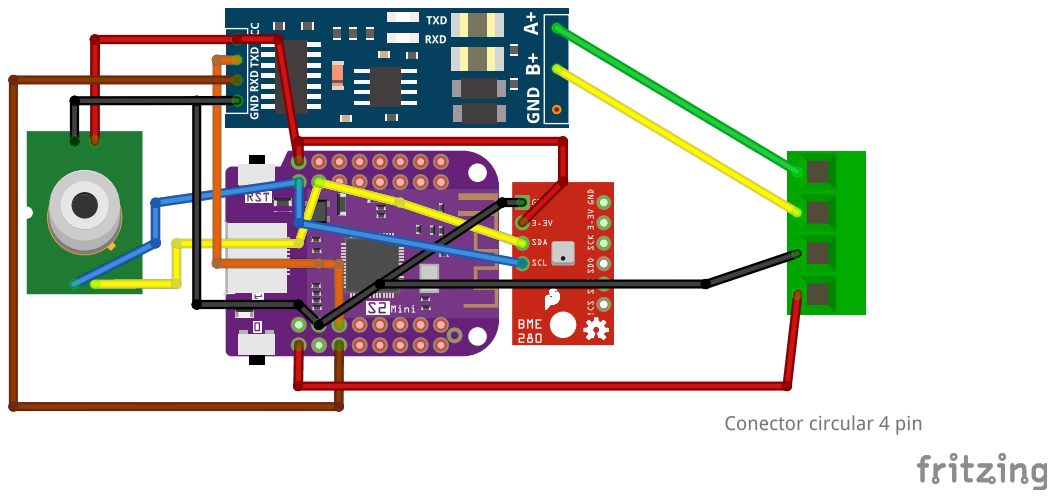
[picture p104: page 1]
