ea3hmj/HMJTS/controller dish/main board/hardware/esquema v5.brd

## EAGLE design controller dish/main board/hardware/esquema v5.brd (2023-05-08)

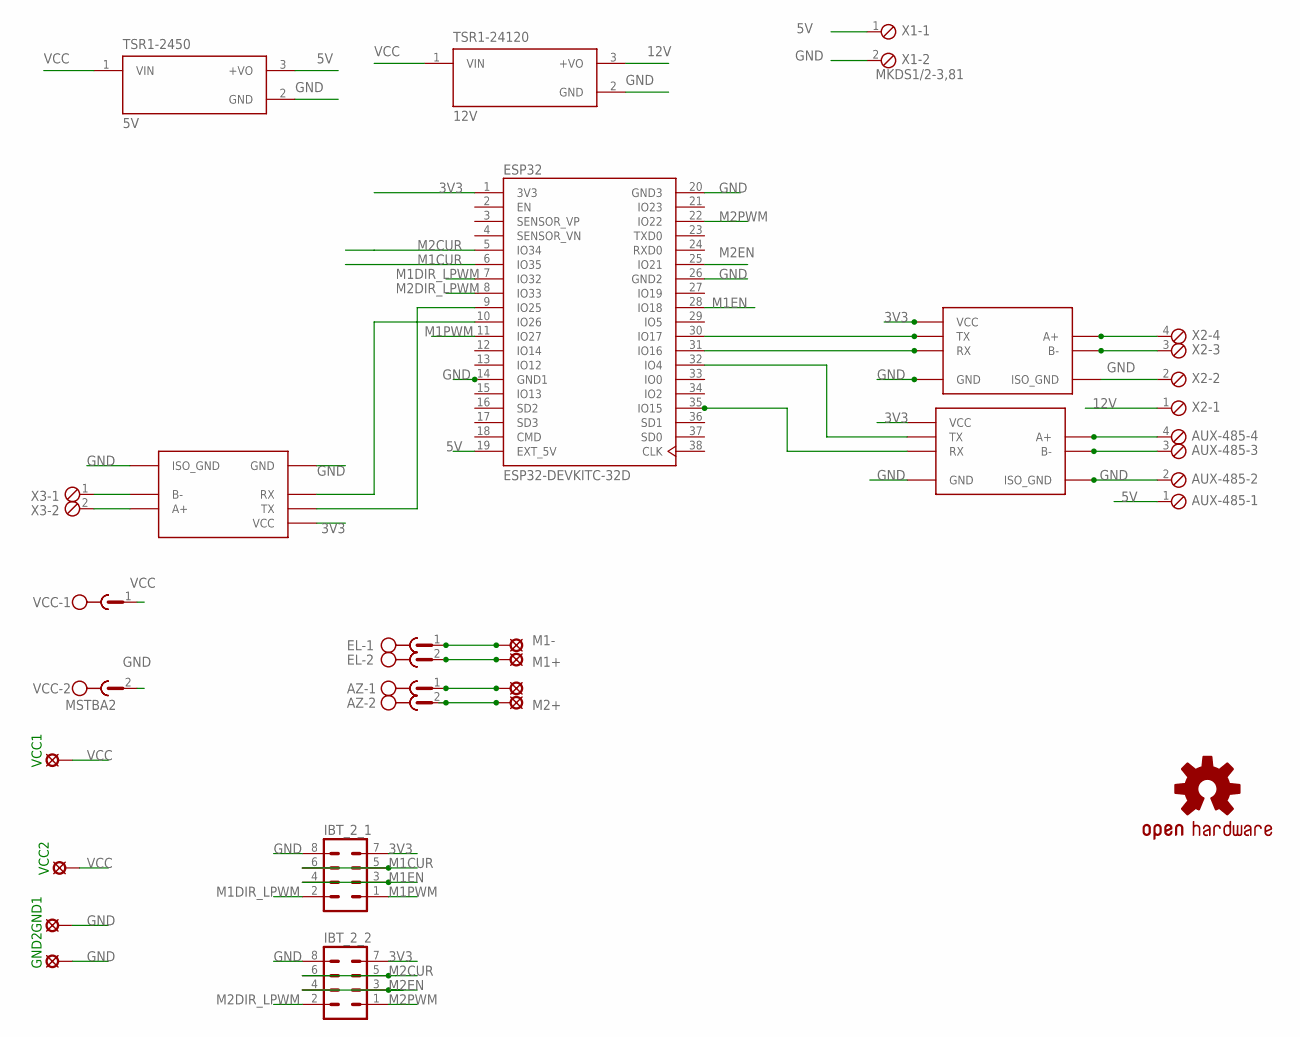
[picture p105: schematic esquema v5.sch]

Parts:
AUX-485: MKDS1/4-3,81; 4POL381
AZ: MSTBA2
EL: MSTBA2
ESP32: ESP32-DEVKITC-32D; MODULE_ESP32-DEVKITC-32D
GND1, GND2: LSP10
IBT_2_1: IBT_2_1; MA04-2
IBT_2_2: MA04-2
LOGO1: OSHW-LOGOMINI; OSHW-LOGO-MINI
M1+, M1-, M2+: LSP10
M2, M3, M4: LIMNOTECH_SMC_RS485
M2-: M2-; LSP10
TSR1-2450: 5V; CONV_K7803-500R3
TSR1-24120: 12V; CONV_K7803-500R3
VCC: MSTBA2
VCC1, VCC2: LSP10
X1, X3: MKDS1/2-3,81; 2POL381
X2: MKDS1/4-3,81; 4POL381

Connections:
3V3: ESP32.1 (3V3), IBT_2_1.7, IBT_2_2.7, M2.VCC, M3.VCC, M4.VCC
5V: AUX-485.1, ESP32.19 (EXT_5V), TSR1-2450.3 (+VO), X1.1
12V: TSR1-24120.3 (+VO), X2.1
GND: AUX-485.2, ESP32.14 (GND1), ESP32.20 (GND3), ESP32.26 (GND2), GND1.MP, GND2.MP, IBT_2_1.8, IBT_2_2.8, M2.GND, M2.GND_ISO (ISO_GND), M3.GND, M3.GND_ISO (ISO_GND), M4.GND, M4.GND_ISO (ISO_GND), TSR1-2450.2 (GND), TSR1-24120.2 (GND), VCC.2, X1.2, X2.2
M1+: EL.2, M1+.MP
M1-: EL.1, M1-.MP
M1CUR: ESP32.6 (IO35), IBT_2_1.5, IBT_2_1.6
M1DIR_LPWM: ESP32.7 (IO32), IBT_2_1.2
M1EN: ESP32.28 (IO18), IBT_2_1.3, IBT_2_1.4
M1PWM: ESP32.11 (IO27), IBT_2_1.1
M2+: AZ.2, M2+.MP
M2CUR: ESP32.5 (IO34), IBT_2_2.5, IBT_2_2.6
M2DIR_LPWM: ESP32.8 (IO33), IBT_2_2.2
M2EN: ESP32.25 (IO21), IBT_2_2.3, IBT_2_2.4
M2PWM: ESP32.22 (IO22), IBT_2_2.1
unnamed: M4.B-, X2.3
unnamed: AUX-485.4, M2.A+
unnamed: AZ.1, M2-.MP
unnamed: ESP32.32 (IO4), M2.TX
unnamed: ESP32.10 (IO26), M3.RX
unnamed: ESP32.9 (IO25), M3.TX
unnamed: ESP32.31 (IO16), M4.RX
unnamed: ESP32.30 (IO17), M4.TX
unnamed: M3.B-, X3.1
unnamed: M3.A+, X3.2
unnamed: ESP32.35 (IO15), M2.RX
unnamed: AUX-485.3, M2.B-
unnamed: M4.A+, X2.4
VCC: TSR1-2450.1 (VIN), TSR1-24120.1 (VIN), VCC.1, VCC1.MP, VCC2.MP

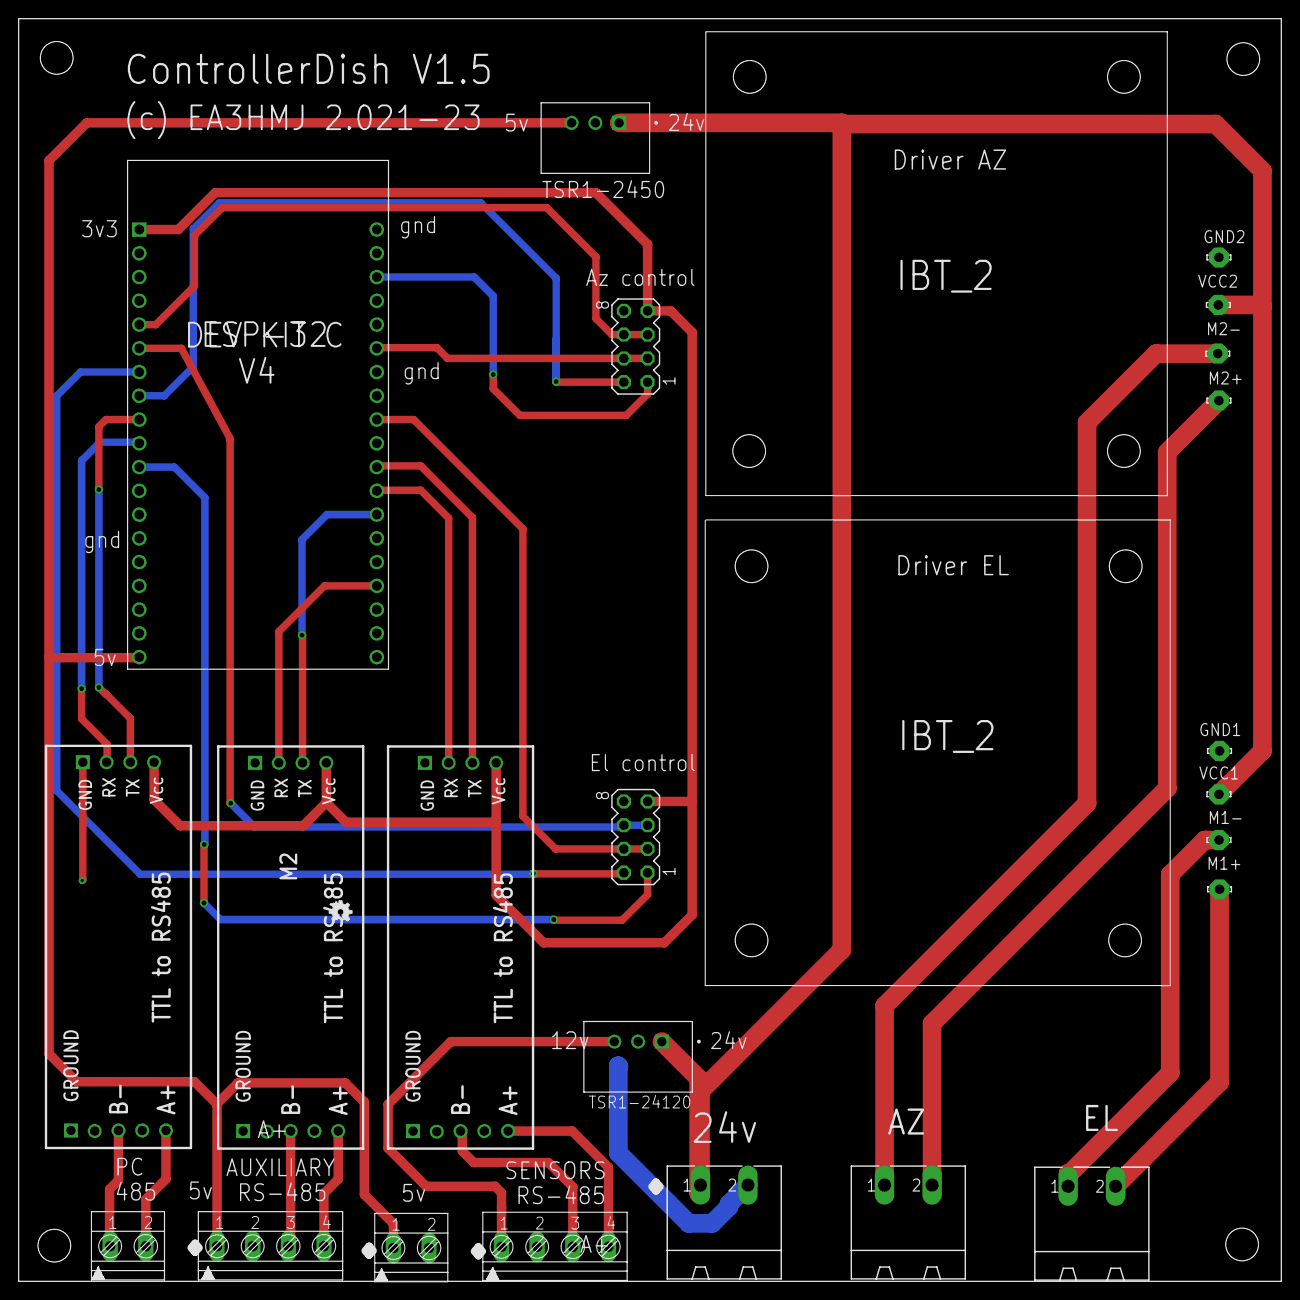
[picture p106: board esquema v5.brd from above]

Board: 2 copper layers, 135.0 x 135.0 mm, 24 parts (0 on the bottom side), 29 nets.
