ea3hmj/HMJTS/controller dish/main board/hardware/esquema v4.brd

## EAGLE design controller dish/main board/hardware/esquema v4.brd (2023-04-23, an earlier design)

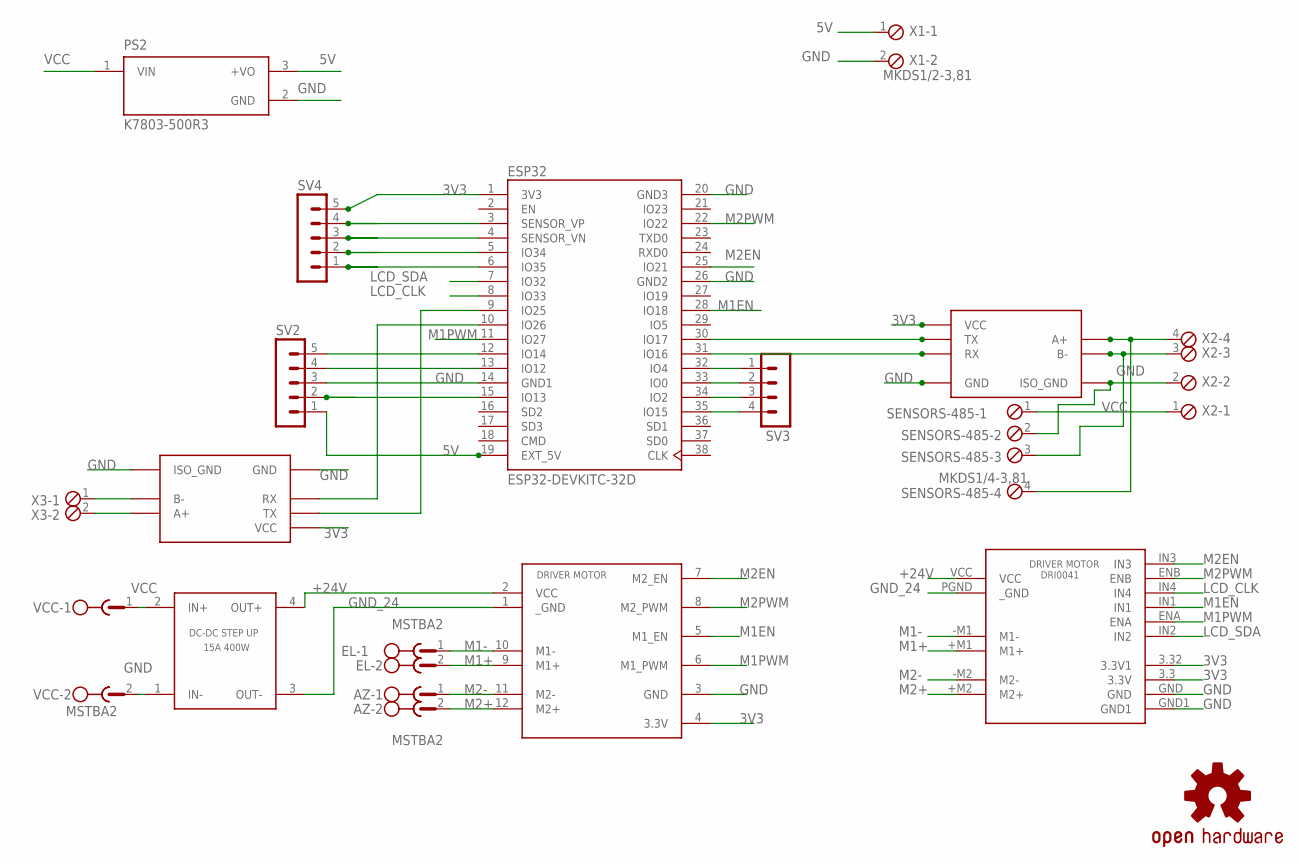
[picture p107: schematic esquema v4.sch]

Parts:
AZ: MSTBA2
EL: MSTBA2
ESP32: ESP32-DEVKITC-32D; MODULE_ESP32-DEVKITC-32D
LOGO1: OSHW-LOGOMINI; OSHW-LOGO-MINI
M1: DRIVER_MOTOR
M2: DC-DC_STRP_UP; DC-DC-SETP-UP
M3, M4: LIMNOTECH_SMC_RS485
PS2: K7803-500R3; CONV_K7803-500R3
SENSORS-485: MKDS1/4-3,81; 4POL381
SV2, SV4: MA05-1
SV3: MA04-1
U$2: DRIVER_DRI0041; DRI0041
VCC: MSTBA2
X1, X3: MKDS1/2-3,81; 2POL381
X2: MKDS1/4-3,81; 4POL381

Connections:
3V3: ESP32.1 (3V3), M1.4 (3.3V), M3.VCC, M4.VCC, SV4.5, U$2.3.3 (3.3V), U$2.3.32 (3.3V1)
5V: ESP32.19 (EXT_5V), PS2.3 (+VO), SV2.1, X1.1
+24V: M1.2 (VCC), M2.4 (OUT+), U$2.VCC
GND: ESP32.14 (GND1), ESP32.20 (GND3), ESP32.26 (GND2), M1.3 (GND), M2.1 (IN-), M3.GND, M3.GND_ISO (ISO_GND), M4.GND, M4.GND_ISO (ISO_GND), PS2.2 (GND), SENSORS-485.2, SV2.3, U$2.GND, U$2.GND1, VCC.2, X1.2, X2.2
GND_24: M1.1 (_GND), M2.3 (OUT-), U$2.PGND (_GND)
LCD_CLK: ESP32.8 (IO33), U$2.IN4
LCD_SDA: ESP32.7 (IO32), U$2.IN2
M1+: EL.2, M1.9 (M1+), U$2.+M1 (M1+)
M1-: EL.1, M1.10 (M1-), U$2.-M1 (M1-)
M1EN: ESP32.28 (IO18), M1.5 (M1_EN), U$2.IN1
M1PWM: ESP32.11 (IO27), M1.6 (M1_PWM), U$2.ENA
M2+: AZ.2, M1.12 (M2+), U$2.+M2 (M2+)
M2-: AZ.1, M1.11 (M2-), U$2.-M2 (M2-)
M2EN: ESP32.25 (IO21), M1.7 (M2_EN), U$2.IN3
M2PWM: ESP32.22 (IO22), M1.8 (M2_PWM), U$2.ENB
unnamed: M4.B-, SENSORS-485.3, X2.3
unnamed: M4.A+, SENSORS-485.4, X2.4
unnamed: ESP32.3 (SENSOR_VP), SV4.4
unnamed: ESP32.4 (SENSOR_VN), SV4.3
unnamed: ESP32.10 (IO26), M3.RX
unnamed: ESP32.9 (IO25), M3.TX
unnamed: ESP32.31 (IO16), M4.RX
unnamed: ESP32.30 (IO17), M4.TX
unnamed: M3.B-, X3.1
unnamed: M3.A+, X3.2
unnamed: ESP32.5 (IO34), SV4.2
unnamed: ESP32.6 (IO35), SV4.1
unnamed: ESP32.15 (IO13), SV2.2
unnamed: ESP32.13 (IO12), SV2.4
unnamed: ESP32.12 (IO14), SV2.5
unnamed: ESP32.32 (IO4), SV3.1
unnamed: ESP32.33 (IO0), SV3.2
unnamed: ESP32.34 (IO2), SV3.3
unnamed: ESP32.35 (IO15), SV3.4
VCC: M2.2 (IN+), PS2.1 (VIN), SENSORS-485.1, VCC.1, X2.1

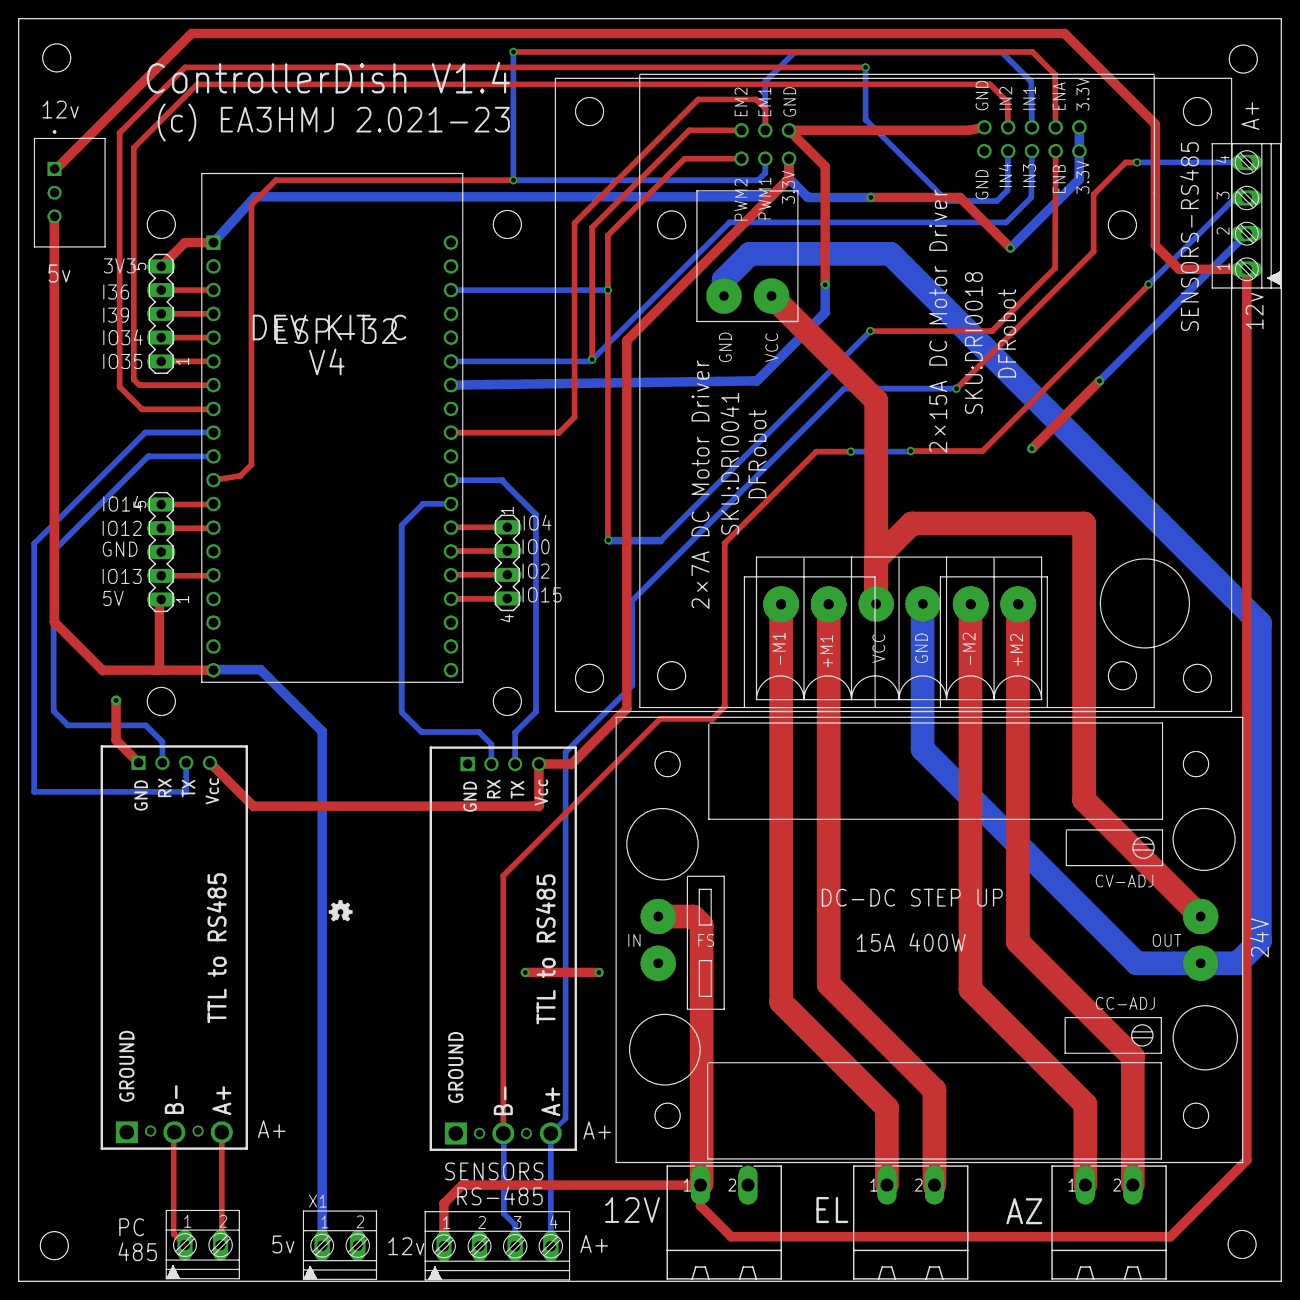
[picture p108: board esquema v4.brd from above]

Board: 2 copper layers, 135.0 x 135.0 mm, 18 parts (0 on the bottom side), 35 nets.
