ea3hmj/HMJTS/controller dish/main board/hardware/esquema v1.brd

## EAGLE design controller dish/main board/hardware/esquema v1.brd (2022-09-26, an earlier design)

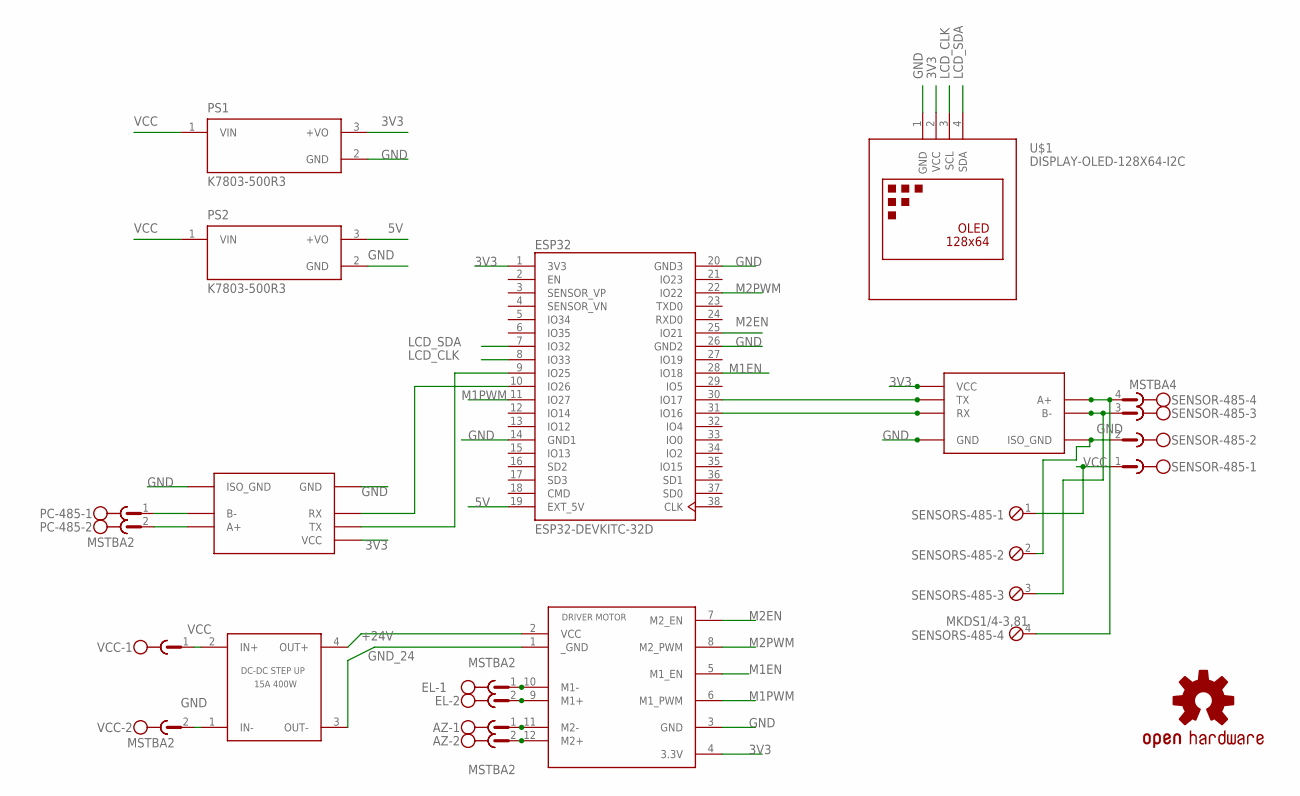
[picture p109: schematic esquema v1.sch]

Parts:
AZ: MSTBA2
EL: MSTBA2
ESP32: ESP32-DEVKITC-32D; MODULE_ESP32-DEVKITC-32D
LOGO1: OSHW-LOGOMINI; OSHW-LOGO-MINI
M1: DRIVER_MOTOR
M2: DC-DC_STRP_UP; DC-DC-SETP-UP
M3, M4: LIMNOTECH_SMC_RS485
PC-485: MSTBA2
PS1, PS2: K7803-500R3; CONV_K7803-500R3
SENSOR-485: MSTBA4
SENSORS-485: MKDS1/4-3,81; 4POL381
U$1: DISPLAY-OLED-128X64-I2C
VCC: MSTBA2

Connections:
3V3: ESP32.1 (3V3), M1.4 (3.3V), M3.VCC, M4.VCC, PS1.3 (+VO), U$1.2 (VCC)
5V: ESP32.19 (EXT_5V), PS2.3 (+VO)
+24V: M1.2 (VCC), M2.4 (OUT+)
GND: ESP32.14 (GND1), ESP32.20 (GND3), ESP32.26 (GND2), M1.3 (GND), M2.1 (IN-), M3.GND, M3.GND_ISO (ISO_GND), M4.GND, M4.GND_ISO (ISO_GND), PS1.2 (GND), PS2.2 (GND), SENSOR-485.2, SENSORS-485.2, U$1.1 (GND), VCC.2
GND_24: M1.1 (_GND), M2.3 (OUT-)
LCD_CLK: ESP32.8 (IO33), U$1.3 (SCL)
LCD_SDA: ESP32.7 (IO32), U$1.4 (SDA)
M1EN: ESP32.28 (IO18), M1.5 (M1_EN)
M1PWM: ESP32.11 (IO27), M1.6 (M1_PWM)
M2EN: ESP32.25 (IO21), M1.7 (M2_EN)
M2PWM: ESP32.22 (IO22), M1.8 (M2_PWM)
unnamed: M4.B-, SENSOR-485.3, SENSORS-485.3
unnamed: M4.A+, SENSOR-485.4, SENSORS-485.4
unnamed: EL.2, M1.9 (M1+)
unnamed: AZ.2, M1.12 (M2+)
unnamed: ESP32.10 (IO26), M3.RX
unnamed: ESP32.9 (IO25), M3.TX
unnamed: ESP32.31 (IO16), M4.RX
unnamed: ESP32.30 (IO17), M4.TX
unnamed: M3.B-, PC-485.1
unnamed: M3.A+, PC-485.2
unnamed: AZ.1, M1.11 (M2-)
unnamed: EL.1, M1.10 (M1-)
VCC: M2.2 (IN+), PS1.1 (VIN), PS2.1 (VIN), SENSOR-485.1, SENSORS-485.1, VCC.1

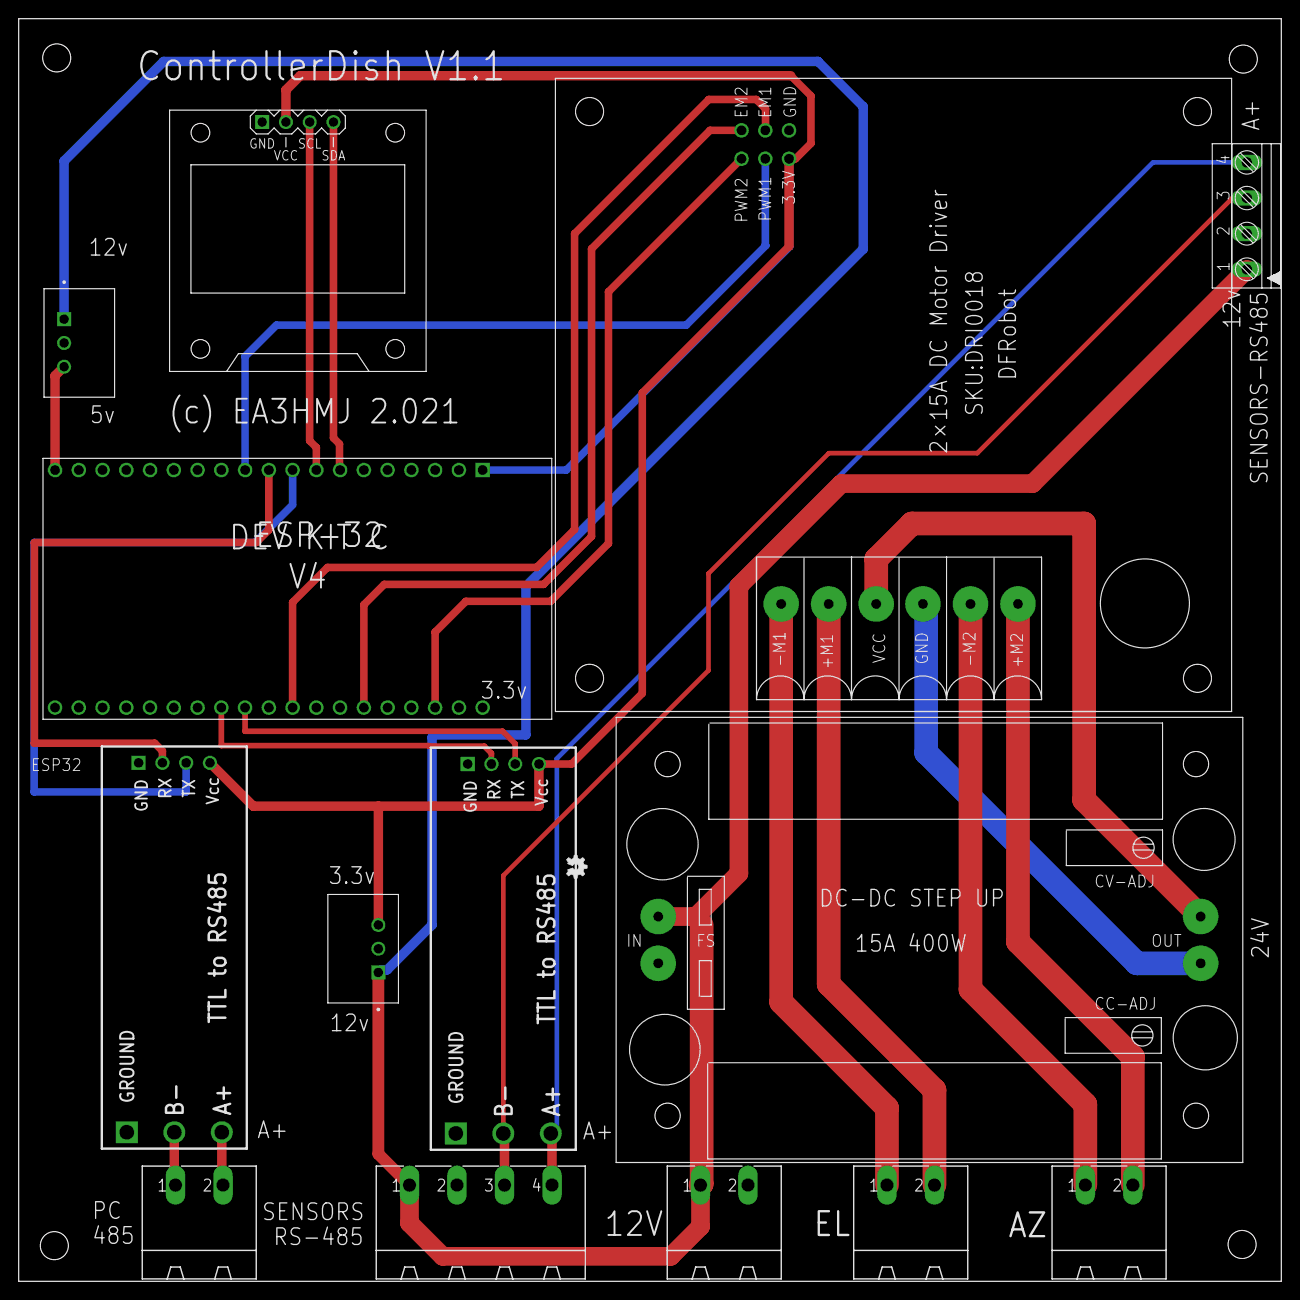
[picture p110: board esquema v1.brd from above]

Board: 2 copper layers, 135.0 x 135.0 mm, 15 parts (0 on the bottom side), 24 nets.
