ea3hmj/HMJTS/controller dish/paralell to 485/hardware/encoder_rs485.brd

## EAGLE design controller dish/paralell to 485/hardware/encoder_rs485.brd (2022-09-26)

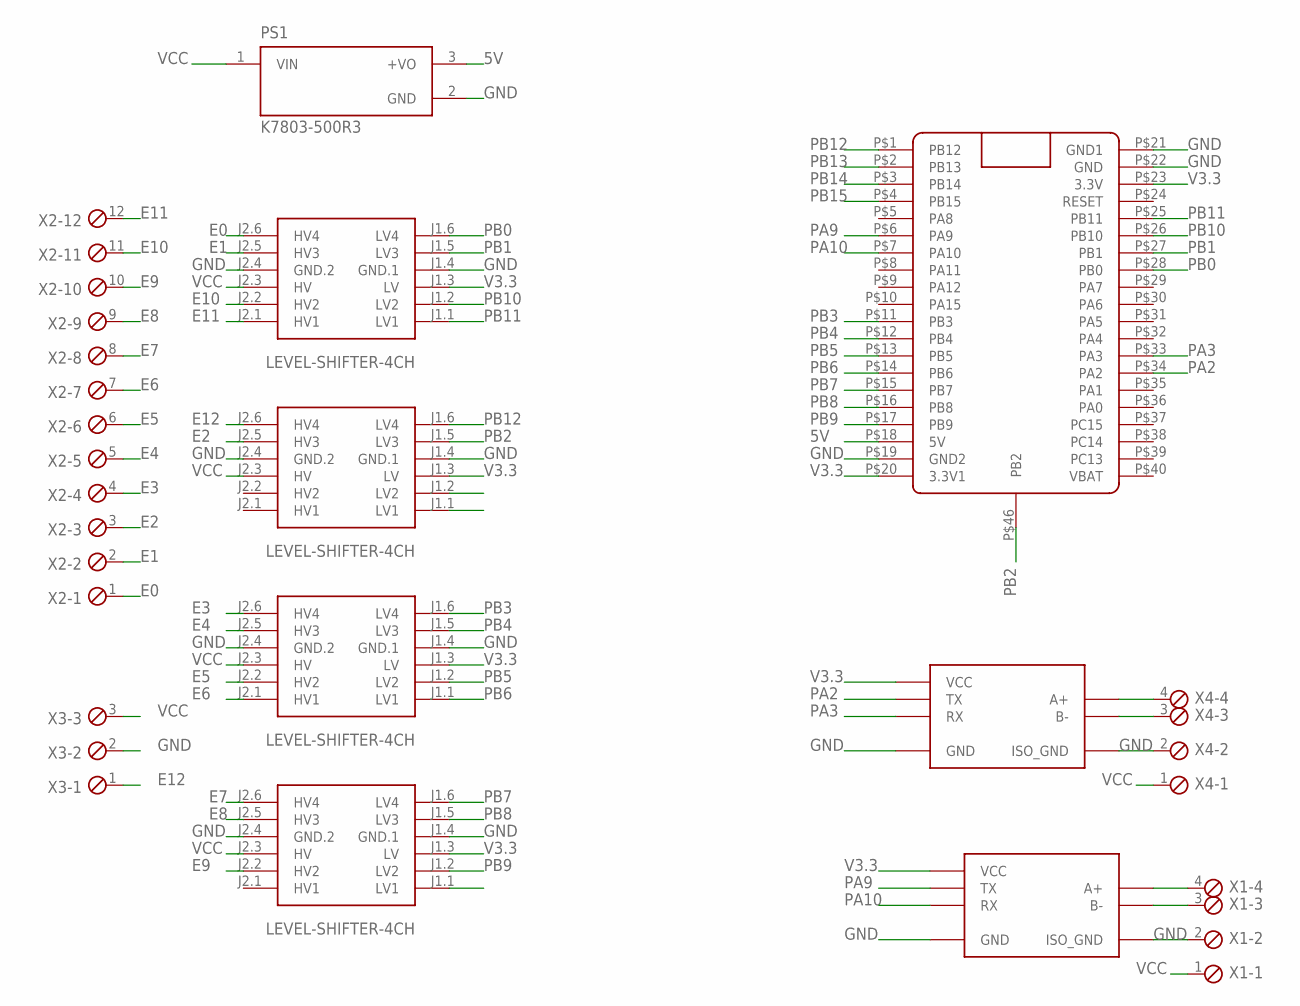
[picture p111: schematic encoder_rs485.sch]

Parts:
PS1: K7803-500R3; CONV_K7803-500R3
U$1, U$7: LIMNOTECH_SMC_RS485
U$2, U$3, U$4, U$5: LEVEL-SHIFTER-4CH
U$6: BLUE_PILLADVANCED; BLUE_PILL_ADV
X1, X4: MKDS1/4-3,81; 4POL381
X2: MKDS1/12-3,81; 12POL381
X3: MKDS1/3-3,81; 3POL381

Connections:
5V: PS1.3 (+VO), U$6.P$18 (5V)
E0: U$2.J2.6 (HV4), X2.1
E1: U$2.J2.5 (HV3), X2.2
E2: U$3.J2.5 (HV3), X2.3
E3: U$4.J2.6 (HV4), X2.4
E4: U$4.J2.5 (HV3), X2.5
E5: U$4.J2.2 (HV2), X2.6
E6: U$4.J2.1 (HV1), X2.7
E7: U$5.J2.6 (HV4), X2.8
E8: U$5.J2.5 (HV3), X2.9
E9: U$5.J2.2 (HV2), X2.10
E10: U$2.J2.2 (HV2), X2.11
E11: U$2.J2.1 (HV1), X2.12
E12: U$3.J2.6 (HV4), X3.1
GND: PS1.2 (GND), U$1.GND, U$1.GND_ISO (ISO_GND), U$2.J1.4 (GND.1), U$2.J2.4 (GND.2), U$3.J1.4 (GND.1), U$3.J2.4 (GND.2), U$4.J1.4 (GND.1), U$4.J2.4 (GND.2), U$5.J1.4 (GND.1), U$5.J2.4 (GND.2), U$6.P$19 (GND2), U$6.P$21 (GND1), U$6.P$22 (GND), U$7.GND, U$7.GND_ISO (ISO_GND), X1.2, X3.2, X4.2
unnamed: U$1.B-, X1.3
unnamed: U$1.A+, X1.4
unnamed: U$7.B-, X4.3
unnamed: U$7.A+, X4.4
PA2: U$6.P$34 (PA2), U$7.TX
PA3: U$6.P$33 (PA3), U$7.RX
PA9: U$1.TX, U$6.P$6 (PA9)
PA10: U$1.RX, U$6.P$7 (PA10)
PB0: U$2.J1.6 (LV4), U$6.P$28 (PB0)
PB1: U$2.J1.5 (LV3), U$6.P$27 (PB1)
PB2: U$3.J1.5 (LV3), U$6.P$46 (PB2)
PB3: U$4.J1.6 (LV4), U$6.P$11 (PB3)
PB4: U$4.J1.5 (LV3), U$6.P$12 (PB4)
PB5: U$4.J1.2 (LV2), U$6.P$13 (PB5)
PB6: U$4.J1.1 (LV1), U$6.P$14 (PB6)
PB7: U$5.J1.6 (LV4), U$6.P$15 (PB7)
PB8: U$5.J1.5 (LV3), U$6.P$16 (PB8)
PB9: U$5.J1.2 (LV2), U$6.P$17 (PB9)
PB10: U$2.J1.2 (LV2), U$6.P$26 (PB10)
PB11: U$2.J1.1 (LV1), U$6.P$25 (PB11)
PB12: U$3.J1.6 (LV4), U$6.P$1 (PB12)
PB13: U$6.P$2 (PB13)
PB14: U$6.P$3 (PB14)
PB15: U$6.P$4 (PB15)
V3.3: U$1.VCC, U$2.J1.3 (LV), U$3.J1.3 (LV), U$4.J1.3 (LV), U$5.J1.3 (LV), U$6.P$20 (3.3V1), U$6.P$23 (3.3V), U$7.VCC
VCC: PS1.1 (VIN), U$2.J2.3 (HV), U$3.J2.3 (HV), U$4.J2.3 (HV), U$5.J2.3 (HV), X1.1, X3.3, X4.1

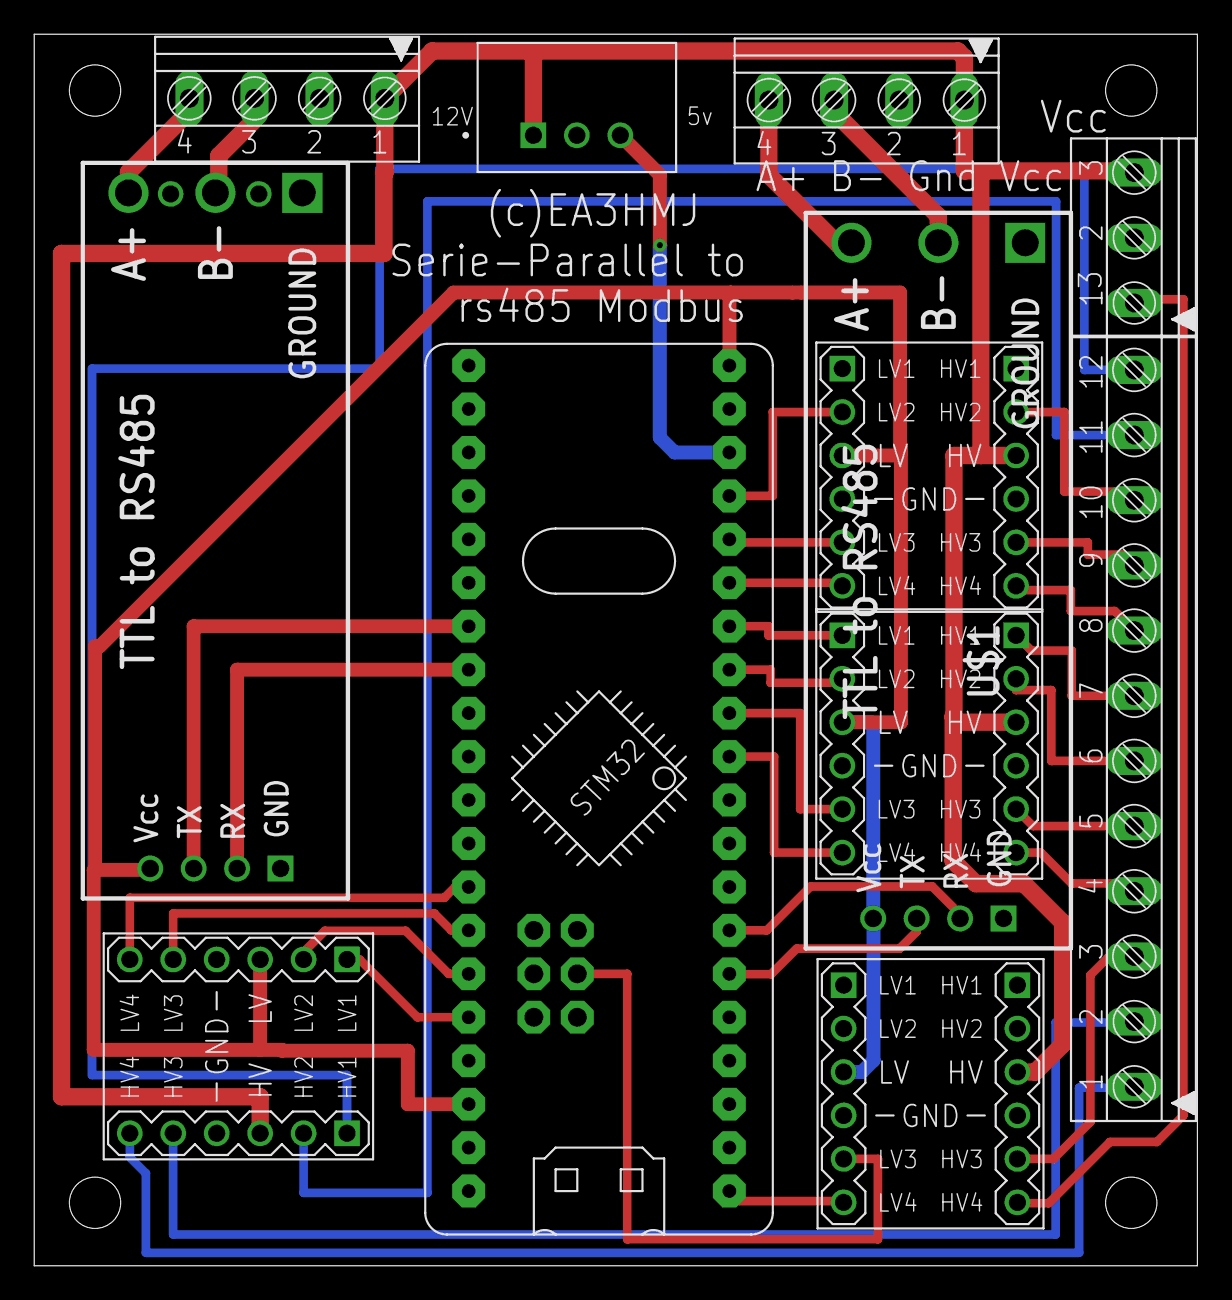
[picture p112: board encoder_rs485.brd from above]

Board: 2 copper layers, 68.0 x 72.0 mm, 12 parts (0 on the bottom side), 38 nets.
