ea3hmj/HMJTS/(commit log)

2022-09-26 Add files via upload
    Initial commit
    [encoder_rs485.brd, encoder_rs485.sch, esquema v1.brd, esquema v1.sch]
2023-04-23 new version
    [esquema v4.brd, esquema v4.sch]
2023-05-08 New hardware version
    [esquema v5.brd, esquema v5.sch]
