ea3hmj/HMJTS/img/batery.jpg

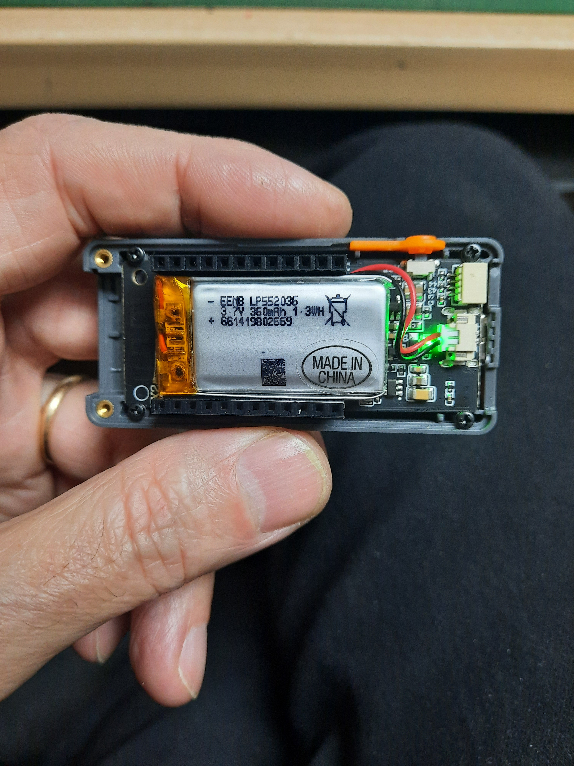
[picture p9: img/batery.jpg]
img/batery.jpg
