ea3hmj/HMJTS/img/batery2.jpg

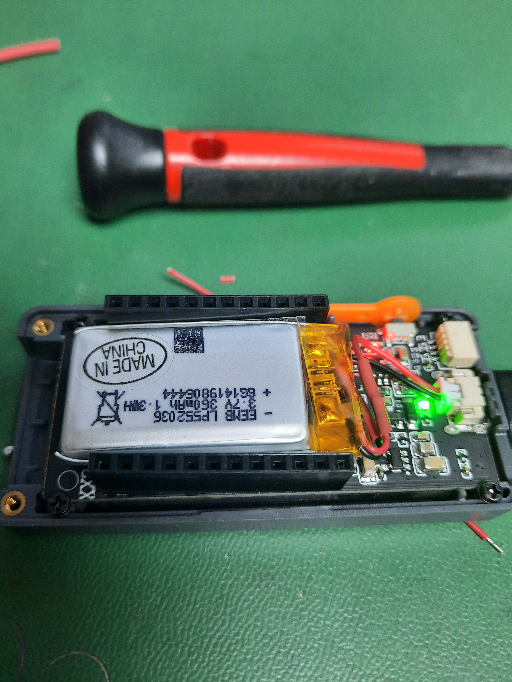
[picture p10: img/batery2.jpg]
img/batery2.jpg
