ea3hmj/HMJTS/img/batery3.jpg

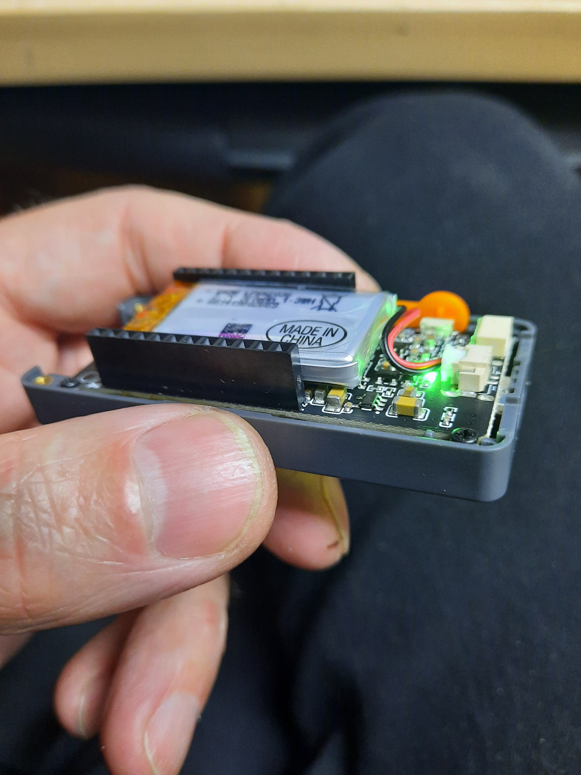
[picture p11: img/batery3.jpg]
img/batery3.jpg
