ea3hmj/HMJTS/img/encoder.jpg

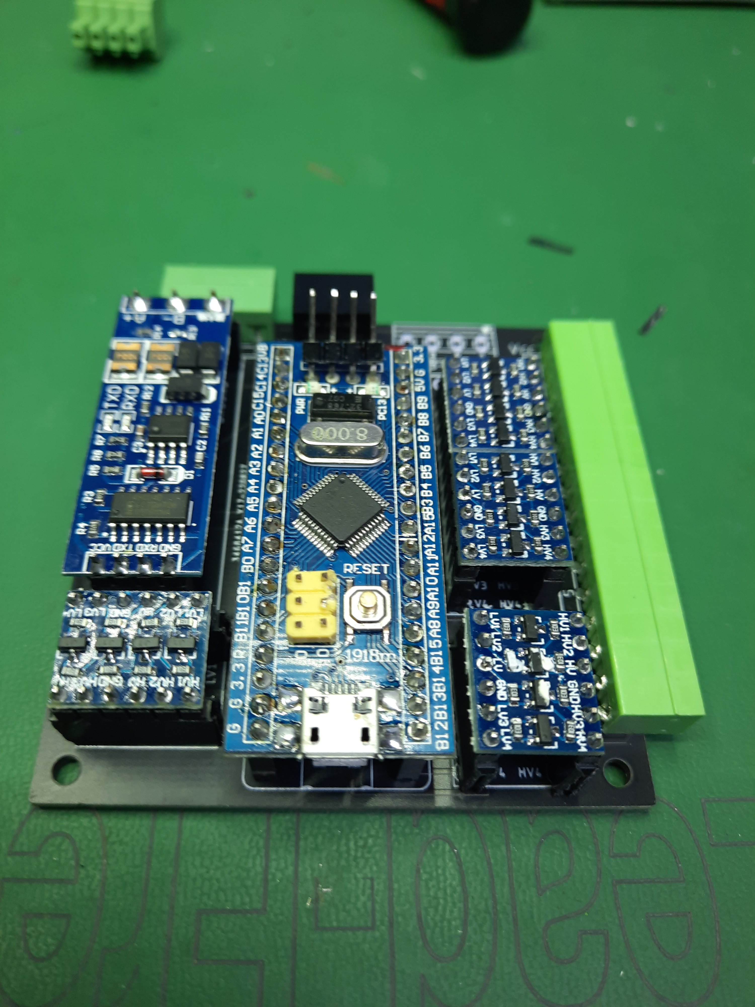
[picture p12: img/encoder.jpg]
img/encoder.jpg
