ea3hmj/HMJTS/img/controller.jpg

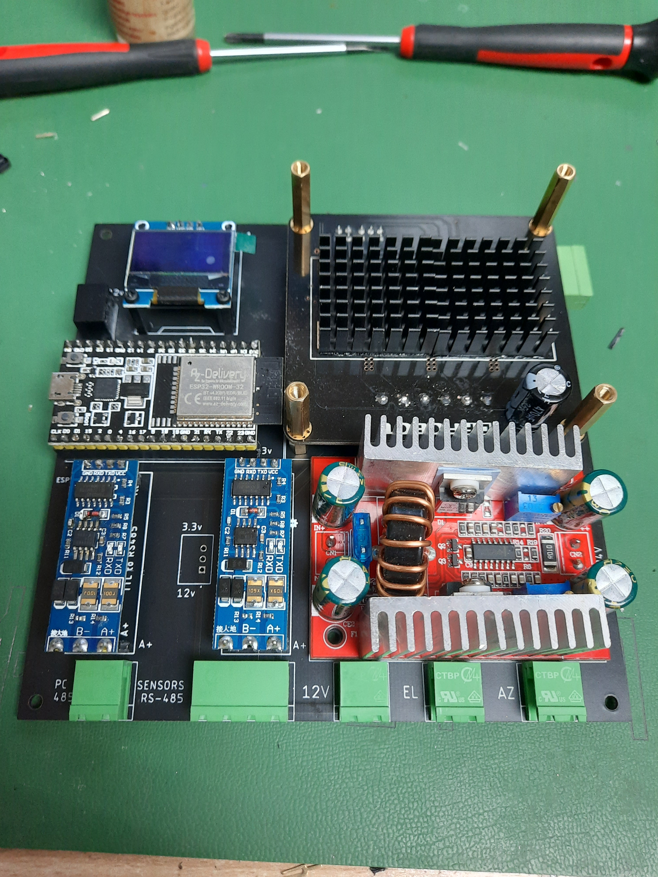
img/controller.jpg
